cee-wals/Voron-2/custom/mods/Corner_Cable_Cover_with_Drop_Holes /README.md

# Top Corner Cable Cover with Drop Down Holes (LED Wires)
Covers cables that are running around the top corners of 2.4R2 extrusions behind the Z idlers with drop down holes around the vertical extrusions and inline holes with cutouts to keep the wire management as clean as possible.

Holes are big enough to allow 2 pin microfit connectors pass through. Works perfectly with LDO LED PCB breakout board.

**CAUTION**
Check your max Z travel as there will be some loss.

### Printing
  * Print 1 cover per LED strip
  * Default voron settings
  * No supports needed

### BOM

Size | Qty
--- | ---
M3x8 | 2
M3 T-Nut | 2

* QTY per cover

Top Corner Cable Cover

Top Corner Cable Cover

Top Corner Cable Cover
