cee-wals/Voron-2/custom/tools/12mm_Linear_Rail_Alignment_Tool_for_2020___3030_T_Slot/README.txt

12mm Linear Rail Alignment Tool for 2020 + 3030 T Slot by Omster_Designs on Thingiverse: https://www.thingiverse.com/thing:3383221
