cee-wals/Voron-2/custom/mods/MRW_Kinematic_Sexbolt_Mount/ORIGIN.md

__Origin:__ [MRW Adapted SexBolt Z endstop](https://github.com/azoner/VoronUsers/tree/master/printer_mods/azoner/MRW_Kinematic_Sexbolt_Mount)
