cee-wals/Voron-2/custom/mods/voron-v2-bed-level-camera-model_files/532931-voron-v2-bed-level-camera-3a5c9853-37b9-4ec1-85e7-4c6113cc6f03.pdf

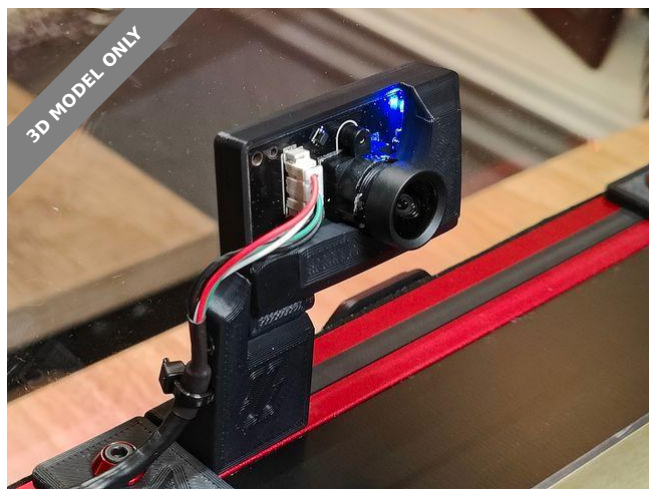
[picture p16: figure]
3D MODEL ONLY

Summary

In case you don't want the bird's eye view

3D Printers (https://printables.com/model?categoryId=1) > 3D Printers - Upgrades (https://printables.com/model?categoryId=2)

Tags: camera | mod | voron | webcam

This is a case and extrusion mount for inexpensive 1080p webcams. It's just low enough to clear the V2 gantry. Tested with Xol2 non-UHF hotend without kinematic mounts. If you use this successfully with other hotend combinations, please let me know and I'll update the description. If you use a kinematic mount, let me know what the difference is and I can make an additional extrusion mount for that height.

BOM

1x M3 20mm BHCS
3x M2 10mm self-tapping screws 1x 3x5x4 “Voron standard” heatset
1x Extrusion nut (roll-in, T-nut, etc.)
1x Small zip tie
1x Generic 1080p webcam (eMeet C960 (https://www.amazon.com/dp/B07M6Y7355?amp=&amp=) is what I used but I suspect most webcams are similar without the case)

neon.blue (https://printables.com/@neonblue)

Voron V2 Bed Level

Camera

VIEW IN BROWSER (https://printables.com/model/532931-voron-v2-bed-level-camera)

updated 26. 7. 2023 | published 26. 7. 2023

•
•
•
•
•
•

Instructions

Print 1 of each part
Insert heat set into Extrusion Mount
Open the webcam case (see below)
Once just the PCB is isolated, inspect the lens. Most of these cameras have a threaded (screw on) lens with a dab of glue. If so, twist the lens to break the glue seal. Rotate the lens so that it's about a quarter turn out(to the left) from it's original position. This step is necessary as most webcams are set with the focus distance too far away. Insert the PCB into the Back Plate.
Put the Front Cover over top of the Back Plate, holding both in place with one hand.
Thread the M2 screws in from the back.
Thread the M3 screw through the bottom of the Back Plate, and fasten to the Extrusion Mount.
Install extrusion not into 2020 frame and screw Extrusion Mount in place
Adjusting the pivot direction as needed
Place an item in the middle of the build plate to check how focus is. If everything is out of focus, twist the lens in (to the right). If the background is in focus but the printed object is not, twist the lens out (to the left).
Add a zip tie to secure the USB cable
Route the cable into the basement using your preferred method (belt covers with cable routing slots help here)

IMPORANT LAST STEP: Slowly lower the gantry down, then

move the Y axis back and forth to make sure everything
clears before running a print. I tested the model with a Xol2 toolhead with a Rapido HF (not the longer UHF), but your toolhead and hotend combination may vary slightly, so be sure to check!

Opening the eMeet C960 Case

Where the main case pivots from the mount, there are two rubber dots. Use an awl, ice pick, or thin need nose pliers to pry these out. Remove the pivot screws.
To remove the case, there's a small flat dimple that a flathead screwdriver will fit on the bottom. Use the screwdriver to pry it apart. This will break the case irreparably.
Once the case is halved, use plyers to pull the case apart to loosen the PCB. The case material is flexible and will bend enough to allow the PCB to easily come out. Be careful not to damage the PCB in the process.

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
### Model files

License

This work is licensed under a GNU

General Public License v3.0 (https://www.gnu.org/licenses/gpl-3.0.html)

✖ | Sharing without ATTRIBUTION
✔ | Remix Culture allowed
✔ | Commercial Use
✔ | Meets Open Definition
ℹ | Share under the same license extrusion⁻mount⁻no⁻kinematics.stl

front⁻cover.stl

back-plate.stl
