cee-wals/Voron-2/custom/tools/12mm_Linear_Rail_Alignment_Tool_for_2020___3030_T_Slot/images/Linear_Rail_3030_Alignment_Tool.png

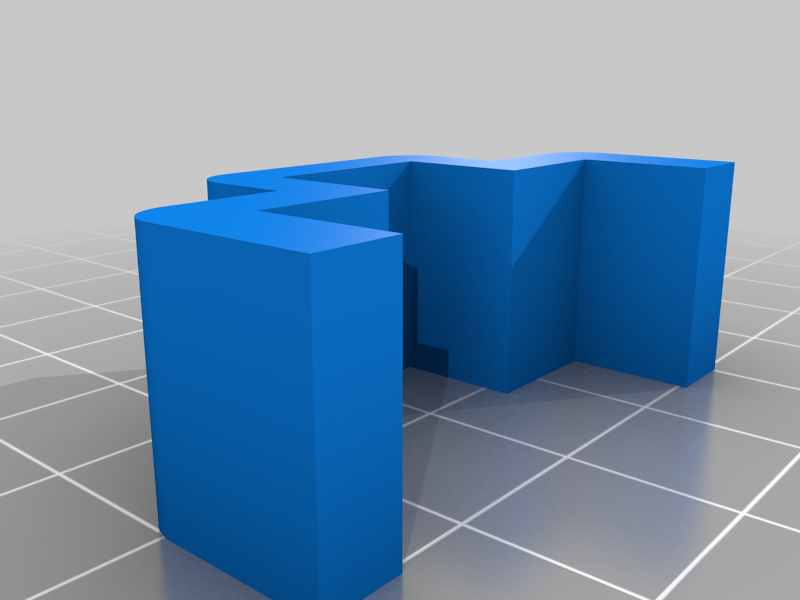
custom/tools/12mm_Linear_Rail_Alignment_Tool_for_2020___3030_T_Slot/images/Linear_Rail_3030_Alignment_Tool.png
