cee-wals/Voron-2/custom/voronica/BTT-Manta-M8P-v1.0.jpg

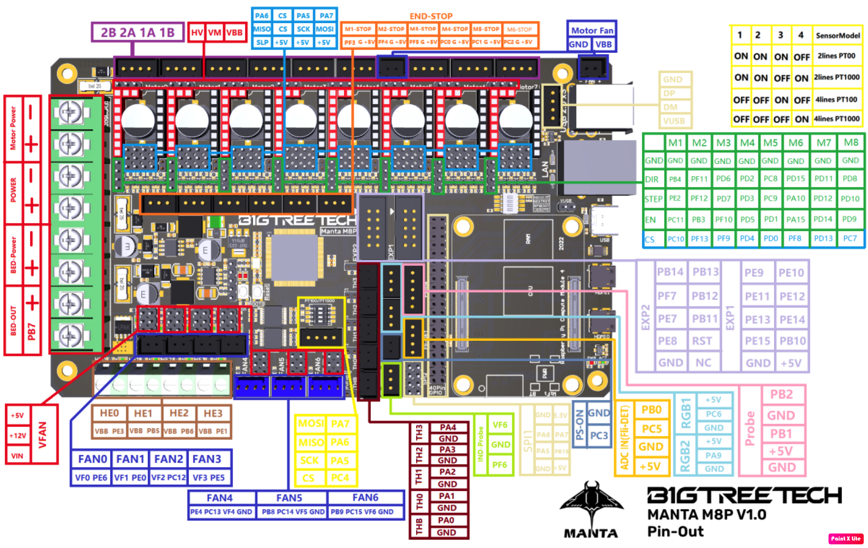
custom/voronica/BTT-Manta-M8P-v1.0.jpg
