cee-wals/Voron-2/BOM/voron2.4_350mm_bom.xlsx

Sheet: West3D Voron 2.4 BOM
WEST3D V2.4 Configurator - BOM In a Box
Description | Quantity | Configurable | BOM mod | Config 1 | Config 2 | Config 3 | My Choice | Notes | Actual Qty. | Unit Cost | Cost (parts only) | Shipping | Taxes | Total Cost | Actual Cost | Cost Adjustments | Status | Funding / Accounting Info | Accounting Tasking / Status
Printed Parts | 0 | YES |  | Printed Parts (https://west3d.com/products/printed-parts-for-voron-2-4?_pos=2&_sid=e14926f18&_ss=r) |  |  | DIY | TODO: Add filament and costs. 2 x ASA spools Jet black and lipstick red: from PrintedSolid.com | 0 | $0.00 | $0.00 |  |  | $0.00 |  |  | In-Progress |  |  | Statuses
West3D BDF Stainless Steel Fasteners - Default (https://west3d.com/products/west3d-stainless-steel-fastener-kit-for-voron-2-4-bdf) | 1 | YES |  | West3D BDF Stainless Steel Fasteners - Stainless Steel Hammer Head Upgrade (https://west3d.com/products/west3d-stainless-steel-fastener-kit-for-voron-2-4-bdf?variant=41091345612968) | West3DBDF All Black |  | West3D BDF Stainless Steel Fasteners - Stainless Steel Hammer Head Upgrade |  | 1 | $84.99 | $84.99 | $0.00 | $0.00 | $84.99 | $84.99 |  | Received | Voron Txn 3 (TWW-KF-VORON-3) TWW Kids fund (proj. voron): $530.90 on 11/11/2022 total shipping: $10.00 | TWW-KF-VORON-3 Direct from TWW account | Ordered
West3D Motion Kit Silver (https://west3d.com/products/west3d-bdm-voron-2-4-motion-set-black-or-silver?_pos=1&_sid=ffc38f735&_ss=r) | 1 | YES |  | West3D Motion Black (https://west3d.com/products/west3d-bdm-voron-2-4-motion-set-black-or-silver?variant=42314907910356) | POWGE Motion Silver (https://west3d.com/products/powge-gates-voron-2-4-motion-set-black-or-silver) | POWGE Motion Black (https://west3d.com/products/powge-gates-voron-2-4-motion-set-black-or-silver?_pos=6&_sid=c54dc9652&_ss=r) | POWGE Motion Black (https://west3d.com/products/berserker-v2-4-motion-kit?_pos=1&_sid=20ef47c64&_ss=r) | Voron 2.4 Motion Kit (black) | 1 | $144.99 | $144.99 | $0.00 | $0.00 | $144.99 | $144.99 |  | Received | Voron Txn 4 (TWW-KF-VORON-4) TWW Kids fund (proj. voron): $543.42 on 12/02/2022 | TWW-KF-VORON-4 Direct from TWW account | Out-of-stock
West3D Custom MGN9 Rails (https://west3d.com/products/west3d-printing-mgn9h-1r-300-350-400-linear-rails-with-carriages-cna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) | 6 | YES |  | LDO MGN9 Rails (https://west3d.com/products/ldo-motors-mgn9h-1r-300-350-4000-linear-rails-with-carriages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) | West3D MGN9 Black (https://west3d.com/products/west3d-printing-mgn9h-1r-300-350-400-linear-rails-with-carriages-cna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) | RobotDigg GS_MGN9-1H-B400 (black anodized) (https://www.robotdigg.com/product/1314/Black-anodized-linear-rail-7,-9,-12-and-15) | RobotDigg GS_MGN9-1H-B400 (black anodized) | Purchased from robotdig.com | 6 | $15.00 | $90.00 | $35.85 | $0.00 | $125.85 | $125.85 |  | Received | Voron Txn 2 (TWW-KF-VORON-2) TWW Kids fund (proj. voron): $146.82 on 10/24/2022 total shipping: $41.82 | TWW-KF-VORON-2 Pay Apple CC from TWW account | Received
West3D Custom MGN12 Rails (https://west3d.com/products/west3d-printing-mgn12h-1r-300-350-400-linear-rails-with-carriages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) | 1 | YES |  | LDO MGN12 Rails (https://west3d.com/products/ldo-motors-mgn12h-1r-300-350-400-linear-rails-with-carriages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) | West3D MGN12 Black (https://west3d.com/products/west3d-printing-mgn12h-1r-300-350-400-linear-rails-with-carriages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) | RobotDigg GS_MGN12-1H-B400 (black anodized) (https://www.robotdigg.com/product/1314/Black-anodized-linear-rail-7,-9,-12-and-15) | RobotDigg GS_MGN12-1H-B400 (black anodized) | Purchased from robotdig.com | 1 | $15.00 | $15.00 | $5.97 | $0.00 | $20.97 | $20.97 |  | Received | TWW-KF-VORON-2 | TWW-KF-VORON-2 Pay Apple CC from TWW account | Shipped
Updated Rubber Feet for V2.4 (https://west3d.com/products/updated-rubber-feet-for-trident-v2-4-set-of-4?_pos=3&_sid=1c2a5098d&_ss=r) | 4 | NO |  |  |  |  | Updated Rubber Feet for V2.4 | 1x Package contains 4 feet | 1 | $8.99 | $8.99 | $0.00 | $0.00 | $8.99 | $8.99 |  | Received | TWW-KF-VORON-4 | TWW-KF-VORON-4 | In-Progress
Z PCB (https://west3d.com/products/microswitch-z-endstop-pcb-assembled?_pos=1&_sid=06ad9004a&_ss=r) | 1 | YES |  | Sexbolt (https://west3d.com/products/sexbolt-z-endstop-fully-assembled?_pos=1&_sid=f739f1228&_ss=r) | Omron Mouse Button - Micro Switch (D2F-01L) (https://west3d.com/products/omron-mouse-button-micro-switch-d2f-01l?_pos=1&_sid=3f491dd97&_ss=r) |  | Z PCB | Accidentally bought the Z PCB. I originally planned on buying the Omron Mouse Button | 1 | $4.00 | $4.00 | $0.00 | $0.00 | $4.00 | $4.00 |  | Received | TWW-KF-VORON-4 | TWW-KF-VORON-4 | Partial Order
XY Microswitch PCB (https://west3d.com/products/voron-x-y-microswitch-endstop-pcb-assembled?_pos=2&_sid=15e9576ef&_ss=r) | 1 | YES |  | Microswitches (https://west3d.com/products/omron-mouse-button-micro-switch-d2f-01l?_pos=1&_sid=3f491dd97&_ss=r) | Hall Effect PCB (https://west3d.com/products/voron-hall-effect-x-y-endstop-pcb-assembled?_pos=1&_sid=ca49ce687&_ss=r) |  | XY Microswitch PCB |  | 1 | $6.49 | $6.49 | $0.00 | $0.00 | $6.49 | $6.49 |  | Received | TWW-KF-VORON-4 | TWW-KF-VORON-4
Omron TL-Q5MC2-Z NPN Inductve Probe (https://west3d.com/products/omron-tl-q5m-inductive-probe?_pos=2&_sid=832b33dd2&_ss=r) | 1 | NO |  | Klicky Probe (Complete) (https://west3d.com/products/klicky-probe-kit-complete) |  |  | Klicky Probe (Complete) | Attempting to use the Voron Tap | 0 | $27.99 | $0.00 |  |  | $0.00
Bat85 Diode (https://west3d.com/products/bat85-diode?_pos=2&_sid=7df00f9b9&_ss=r) | 1 | NO |  |  |  |  | Bat85 Diode | Included in wiring kit | 0 | $0.99 | $0.00 |  |  | $0.00
Panasonic AWA211VL 15A SSR (https://west3d.com/products/panasonic-aqa211vl-15a-solid-state-relay-ssr?_pos=1&_sid=8c7f9840c&_ss=r) | 1 | YES |  | Omron G3NA-210B-DC5 10A SSR (https://west3d.com/products/omron-g3na-210b-utu-dc5-24v-solid-state-relay-ssr?_pos=2&_sid=8c7f9840c&_ss=r) |  |  | Omron G3NA-210B-DC5 10A SSR |  | 1 | $28.99 | $28.99 | $0.00 | $0.00 | $28.99 | $28.99 |  | Received | TWW-KF-VORON-11 | TWW-KF-VORON-11
Voron 2.4 Motor Kit by OMC / Stepperonline (https://west3d.com/products/voron-2-4-motor-kit-by-omc-steppersonline?_pos=1&_sid=dd1f4dbfe&_ss=r) | 1 | YES |  | LDO V 2.4 Motor Kit (https://west3d.com/products/voron-2-4-motor-kit-by-ldo-motors) |  |  | LDO V 2.4 Motor Kit |  | 1 | $109.99 | $109.99 | $0.00 | $0.00 | $109.99 | $109.99 |  | Received | TWW-KF-VORON-3 | TWW-KF-VORON-3
Mean Well LRS-200-24 200W 24V 8.8A Power Supply (PSU) (https://west3d.com/products/mean-well-lrs-200-24-200w-24v-8-8a-power-supply-psu?_pos=4&_sid=965d25871&_ss=r) | 1 | NO |  | Mean Well LRS-200-48 (https://west3d.com/products/mean-well-lrs-200-48-200w-48v-4-4a-power-supply-psu?_pos=5&_sid=caa366dc6&_ss=r) | Mean Well UHP-200-24 (https://west3d.com/products/mean-well-uhp-200-24-200w-24v-8-4a-power-supply-psu?_pos=6&_sid=caa366dc6&_ss=r) | Mean Well UHP-200-48 (https://west3d.com/products/mean-well-uhp-200-48-200w-48v-4-2a-power-supply-psu-1?_pos=7&_sid=caa366dc6&_ss=r) | Mean Well LRS-200-24 200W 24V 8.8A Power Supply (PSU) |  | 1 | $30.99 | $30.99 | $0.00 | $0.00 | $30.99 | $30.99 |  | Received | TWW-KF-VORON-11 | TWW-KF-VORON-11
Mean Well RS-25-5 25W Power Supply (PSU) (https://west3d.com/products/mean-well-rs-25-5-25w-5v-5a-power-supply-psu?_pos=1&_sid=965d25871&_ss=r) | 1 | NO |  |  |  |  | Mean Well RS-25-5 25W Power Supply (PSU) |  | 1 | $18.99 | $18.99 | $0.00 | $0.00 | $18.99 | $18.99 |  | Received | TWW-KF-VORON-11 | TWW-KF-VORON-11
ZF - Rocker Switch DPST 16A On-Off - WRG32F2BBRLN (https://west3d.com/products/zf-rocker-switch-dpst-16a-on-off-wrg32f2bbrln?_pos=1&_sid=5dfc265cb&_ss=r) | 1 | YES |  | AC Power Unfiltered Inlet w/ 15A switch 250VAC Inlet IEC-GS-1-100 - Adam Tech (https://west3d.com/products/ac-power-unfilted-inlet-w-15a-switch-250vac-inlet-iec-gs-1-100-adam-tech) |  |  | ZF - Rocker Switch DPST 16A On-Off - WRG32F2BBRLN | Didn't order for some reason | 1 | $2.99 | $2.99 | $0.00 | $0.00 | $2.99 | $0.00 |  |  | TWW-KF-VORON-11 | TWW-KF-VORON-11
TycoElectronics - 10EHG1-2 Filtered Power Inlet (https://west3d.com/products/tycoelectronics-10ehg1-2-filtered-power-inlet?_pos=1&_sid=752da22d9&_ss=r) | 1 |  |  |  |  |  | TycoElectronics - 10EHG1-2 Filtered Power Inlet |  | 1 | $20.99 | $20.99 | $0.00 | $0.00 | $20.99 | $20.99 |  | Received | TWW-KF-VORON-11 | TWW-KF-VORON-11
Fuse 8A 250V Holder Cartridge 5 X 20mm Glass (https://west3d.com/products/fuse-8a-250v-holder-cartridge-5-x-20mm-glass?_pos=1&_sid=0d913b2f2&_ss=r) | 3 | NO |  |  |  |  | Fuse 8A 250V Holder Cartridge 5 X 20mm Glass |  | 3 | $0.99 | $2.97 | $0.00 | $0.00 | $2.97 | $2.97 |  | Received | TWW-KF-VORON-11 | TWW-KF-VORON-11
GDSTIME DC 24V 40x40x10 Axial Fan GDA4010 (https://west3d.com/products/gdstime-dc-24v-40x40x10-axial-fan-gda4010-9-blades-dual-ball-bearing-7500rpm-9w-04a-xh2-54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) | 1 | YES |  | Sunon 4010 Premium MagLev Axial (https://west3d.com/products/sunon-4010-premium-axial-fan-maglev-suspension-bearing-24v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) |  |  | GDSTIME DC 24V 40x40x10 Axial Fan GDA4010 | Adding 1 more for SB toolhead. TODO: Is this what that’s for | 2 | $6.99 | $13.98 | $0.00 | $0.00 | $13.98 | $13.98 |  | Received | TWW-KF-VORON-11 | TWW-KF-VORON-11
GDSTIME DC 24V 40x40x20 Centrifugal Blower Fan GDB4020 (https://west3d.com/products/gdstime-dc-24v-40x40x20-centrifugal-blower-fan-gdb3020-dual-ball-bearing-6500rpm-1-5w-07a-xh2-54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) | 1 | NO |  |  |  |  | GDSTIME DC 24V 40x40x20 Centrifugal Blower Fan GDB4020 |  | 1 | $6.99 | $6.99 | $0.00 | $0.00 | $6.99 | $6.99 |  | Received | TWW-KF-VORON-11 | TWW-KF-VORON-11
GDSTIME DC 24V 60x60x20 Axial Fan GDA6020 Dual Ball Bearing 5000RPM 1.7W 0.1A XH2.54 (https://west3d.com/products/gdstime-dc-24v-60x60x20-axial-fan-gda6020-dual-ball-bearing-5000rpm-1-7w-0-1a-xh2-54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) | 3 | NO |  |  |  |  | GDSTIME DC 24V 60x60x20 Axial Fan GDA6020 Dual Ball Bearing 5000RPM 1.7W 0.1A XH2.54 |  | 3 | $6.99 | $20.97 | $0.00 | $0.00 | $20.97 | $20.97 |  | Received | TWW-KF-VORON-11 | TWW-KF-VORON-11
125C Cutoff 15A Thermal Fuse (https://west3d.com/products/125c-cutoff-15a-thermal-fuse?_pos=6&_sid=0d913b2f2&_ss=r) | 1 | NO |  |  |  |  | 125C Cutoff 15A Thermal Fuse | 1 is required. Adding 1 more for in-case it fails | 2 | $1.29 | $2.58 | $0.00 | $0.00 | $2.58 | $2.58 | -$1.29 | Received | TWW-KF-VORON-11 | TWW-KF-VORON-11
~~BTT Octopus Controller Board / 3D Printer Control System~~ | ~~1~~ | ~~YES~~ |  | ~~Octopus PRO 446~~ (https://west3d.com/products/btt-48v-octopus-pro-controller-board-3d-printer-control-system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) | ~~Octopus PRO 429~~ (https://west3d.com/products/btt-48v-octopus-pro-controller-board-3d-printer-control-system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) | ~~Makerbase Monster8~~ (https://west3d.com/products/makerbase-mks-monster8-32bit-control-board-3d-printer?_pos=1&_sid=b657f83e5&_ss=r) | ~~Octopus PRO 429~~ | Not using the BTT Octopus PRO boards b/c the Rpi supply issue. Using the BTT Manta w/ BTT CB1 instead | ~~0~~ | ~~$74.99~~ | ~~$0.00~~ |  |  | ~~$0.00~~
BTT Manta M8P Klipper Controller Board / 3D Printer Control System using CB1/CM4 (https://west3d.com/products/btt-manta-m8p-klipper-controller-board-3d-printer-control-system-using-cb1-cm4) | 1 | YES | YES |  |  |  | BTT Manta M8P Klipper Controller Board / 3D Printer Control System using CB1/CM4 | Replaces BTT Octopus PRO control board and Raspberry Pi | 1 | $54.99 | $54.99 | $0.00 | $0.00 | $54.99 | $54.99 |  | Received | TWW-KF-VORON-3 | TWW-KF-VORON-3
BTT CB1 Computing Core Board Adapter for Manta CBs (https://west3d.com/products/btt-cb1-adapter-for-manta-controller-boards) | 2 | NO | YES (only 1 req) |  |  |  | BTT CB1 Computing Core Board Adapter for Manta CBs | 1 is only required. Adding 1 for private stock | 2 | $29.99 | $59.98 | $0.00 | $0.00 | $59.98 | $59.98 | -$29.99 | Received | TWW-KF-VORON-3 | TWW-KF-VORON-3
BTT Pi4B Adapter for CM4 or CB1 (https://west3d.com/products/btt-pi4b-adapter) | 1 | N/A | NO (not for Voron) |  |  |  | BTT Pi4B Adapter for CM4 or CB1 | Note a part of the Voron 2.4 build. For private stock | 1 | $22.99 | $22.99 | $0.00 | $0.00 | $22.99 | $22.99 | -$22.99 | Received | TWW-KF-VORON-3 | TWW-KF-VORON-3
TMC2209 Stepper Motor Driver / Drivers (BTT) | 7 | YES |  | TMC2226 (https://west3d.com/products/tmc2226-stepper-motor-driver-drivers-btt) | 5160HV |  | TMC2226 |  | 7 | $6.49 | $45.43 | $0.00 | $0.00 | $45.43 | $45.43 |  | Received | TWW-KF-VORON-11 | TWW-KF-VORON-11
Mini 12864 Display Type B RGB - Choose your color (extra) (https://west3d.com/products/mini-12864-display-type-b-bttwhite-on-rgb?_pos=3&_sid=7225d3998&_ss=r) | 1 | YES |  | Touch Screen 5" PiTFT50 (extra) (https://west3d.com/products/touch-screen-display-5-inch-ptft50-btt?_pos=1&_sid=3ed1cf151&_ss=r) | Touch Screen 7" PiTFT70 (extra) (https://west3d.com/products/touch-screen-display-5-inch-ptft50-btt?_pos=1&_sid=3ed1cf151&_ss=r) | BTT HDMI7 V1.0 Display from DFH (https://dfh.fm/products/btt-hdmi7-v1-0-display) | BTT HDMI7 V1.0 Display from DFH | Feature enhancement. 5" display PiTFT50 is listed in BOM, but V2.4 STLs are for the 7" display. | 1 | $70.00 | $70.00 | $3.27 | $0.00 | $73.28 | $73.28 | -$73.28 | Ordered | Voron Txn 13 (TWW-KF-VORON-13) TWW Kids fund (proj. voron): $130.10 on 12/26/2022 | TWW-KF-VORON-13 Direct from TWW account
Mini 12864 Display Type B RGB - Choose your color (https://west3d.com/products/mini-12864-display-type-b-bttwhite-on-rgb) | 2 | N/A | NO |  |  |  | Mini 12864 Display Type B RGB - Choose your color | 1 x Voron + 1 x Polyformer | 2 | $12.99 | $25.98 | $0.00 | $0.00 | $25.98 | $25.98 | -$12.99 | Received | TWW-KF-VORON-3 | TWW-KF-VORON-3
Voron v2.4 USA Frame Kit (black); 350mm (https://west3d.com/products/voron-v2-4-usa-frame-kit?variant=41115940520104) | 1 | NO |  |  |  |  | Voron v2.4 USA Frame Kit (black); 350mm |  | 1 | $150.00 | $150.00 | $10.00 | $0.00 | $160.00 | $160.00 |  | Received | TWW-KF-VORON-3 | TWW-KF-VORON-3
Bowden / PTFE Tube 4mm OD 3mm ID (https://west3d.com/products/bowden-ptfe-tube-4mm-od-3mm-id?variant=41895975387348) | 3 | NO |  |  |  |  | Bowden / PTFE Tube 4mm OD 3mm ID | Not needed for direct drive Voron. | 0 | $3.50 | $0.00 |  |  | $0.00
6mm x 3mm Round Neomydium Magnets (https://west3d.com/products/6mm-x-3mm-round-neomydium-magnets) | 8 | NO |  |  |  |  | 6mm x 3mm Round Neomydium Magnets | Only need 8 but doubling the quantity for other projects | 16 | $0.49 | $7.84 |  |  | $7.84 | $7.84 | -$3.92 | Received | TWW-KF-VORON-11 | TWW-KF-VORON-11
Bowden Coupler for 4mm OD PTFE Tube (https://west3d.com/products/bowden-coupler-for-4mm-od-ptfe-tube) | 1 | NO |  |  |  |  | Bowden Coupler for 4mm OD PTFE Tube |  | 1 | $0.99 | $0.99 |  |  | $0.99
5mm x 10m Single Sided Self Adhesive Tape / 1mm thick (https://west3d.com/products/5mm-x-10m-single-sided-self-adhesive-tape-1mm-thick) | 1 | NO |  |  |  |  | 5mm x 10m Single Sided Self Adhesive Tape / 1mm thick |  | 1 | $4.99 | $4.99 |  |  | $4.99
BMG Components Kit by TriangleLab Hardened Steel | 1 | YES |  | BMG Components Kit Nano Coated RNC (https://west3d.com/products/bmg-components-kit-by-trianglelab?variant=42230858744020) |  |  | BMG Components Kit Nano Coated RNC |  | 1 | $32.99 | $32.99 | $0.00 | $0.00 | $32.99 | $32.99 |  | Received | TWW-KF-VORON-11 | TWW-KF-VORON-11
Wiring Harness for Voron 2.4 / Trident (https://west3d.com/products/wiring-harness-for-voron-2-4-trident) | 1 | YES |  | Linneo DIY FEP Wiring Harness (https://west3d.com/products/linneo-diy-fep-wiring-harness-kit-for-voron-2-4-trident) | GleipnerHarness |  | Wiring Harness for Voron 2.4 / Trident | Linneo $99.99 West3D - Out of stock Need to make new cables for alt CB. Has stop PCBs | 1 | $79.99 | $79.99 | $0.00 | $0.00 | $79.99 | $79.99 |  | Received | TWW-KF-VORON-11 | TWW-KF-VORON-11
Generic Cable Chain Sets for V2.4 (350mm) (https://west3d.com/products/v2-4-cable-chain-set?variant=42258915098836) | 1 | YES |  | IGUS Cable Chain Set (350mm) (https://west3d.com/products/igus-cable-chain-kits?variant=42052418601172) |  |  | IGUS Cable Chain Set (350mm) | IGUS Cable Chain Set (350mm) $79.99 West3D - Out of stock. Default option $24.99 | 1 | $79.99 | $79.99 | $0.00 | $0.00 | $79.99 | $79.99 |  | Received | TWW-KF-VORON-11 | TWW-KF-VORON-11
Mandala Roseworks ABS Panels Black (350 mm) (https://west3d.com/products/voron-2-4-abs-panels?variant=41207116497064) | 1 | YES |  | Mandala Roseworks ABS Panels White | Printed Solide - Aluminum Composite backing Panels (https://www.printedsolid.com/products/voron-v2-panel-set-made-from-aluminum-composite-material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) |  | Printed Solide - Aluminum Composite backing Panels | Getting the ones from Printed Solid | 1 | $65.00 | $65.00 | $0.00 | $0.00 | $65.00 | $65.00 |  | Received | TWW-KF-VORON-5 | TWW-KF-VORON-5
Mandala Roseworks Acrylic Panels Smoked (350mm) (https://west3d.com/products/voron-2-4-acrylic-panels?variant=41213966287016) | 1 | YES |  | Mandala Roseworks Acrylic Panels Clear |  |  | Mandala Roseworks Acrylic Panels Clear | 350mm option | 1 | $48.99 | $48.99 | $19.57 | $0.00 | $68.56 | $68.56 |  | Received | TWW-KF-VORON-12 | TWW-KF-VORON-12
Voron 2.4 Build MIC6 Aluminum Build Plate (350mm) (https://west3d.com/products/voron-2-4-build-mic6-aluminum-build-plate?variant=41126171279528) | 1 | YES |  | Mandala Roseworks Ultraflat Magbed (350mm) (https://west3d.com/products/voron-mag-bed-mic6-aluminum-build-plate?variant=42537846702292) |  |  | Mandala Roseworks Ultraflat Magbed (350mm) | 350mm Aluminum build plate is $104.99 | 1 | $253.99 | $253.99 | $25.00 | $0.00 | $278.99 | $278.99 |  | Received | TWW-KF-VORON-4 | TWW-KF-VORON-4
Keenovo Silicone Heater / Heating Pad | 1 | YES |  | Fermio Style (350mm) (https://west3d.com/products/keenovo-fermio-style-silicone-heater-heating-pad?variant=41219774185640) | Fermoi Style (350mm) from Keenovo Store (https://keenovo.store/products/keenovo-silicone-heater-for-voron-3d-printer-with-fermio-style-build-plate-heatbed-heating-mat) |  | Fermoi Style (350mm) from Keenovo Store | Purchase from the Keenovo Store directly b/c of limited supplies | 1 | $102.12 | $102.12 | $32.00 | $0.00 | $134.12 | $134.12 |  | Received | Voron Txn 14 (TWW-KF-VORON-14) TWW Kids fund (proj. voron): $134.12 on 12/26/2022 | TWW-KF-VORON-14 Direct from TWW account
Magnetic Flex Plate Double-Sided (Texture - Smooth) with 3M Magnetic Backing (Energetic & West3D Collab) (https://west3d.com/products/double-sided-texture-smooth-flex-plate-with-3m-magnetic-backing-energetic-west3d-collab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) | 1 | YES |  |  |  |  | Magnetic Flex Plate Double-Sided (Texture - Smooth) with 3M Magnetic Backing (Energetic & West3D Collab) | Double-sided smoot/texture with Logo for 350mm | 1 | $59.99 | $59.99 | $19.57 | $0.00 | $79.56 | $79.56 |  | Ordered | Voron Txn 12 (TWW-KF-VORON-12) TWW Kids fund (proj. voron): $148.13 on 12/25/2022 | TWW-KF-VORON-12 Direct from TWW account
Phaetus Dragonfly Hotend (BMS) | 1 | YES |  | TriangleLab / Phaetus Rapdio HF (add $10 for UHF) | The Mosquito Hotend | Phaetus Rapido UHF /TL PT1000 (black) (https://west3d.com/products/rapido-hot-end-high-flow-tl-phaetus?variant=43306704470228) | Phaetus Rapido UHF /TL PT1000 (black) |  | 1 | $119.99 | $119.99 | $0.00 | $0.00 | $119.99 | $119.99 |  | Received | TWW-KF-VORON-11 | TWW-KF-VORON-11
50W 24V Heater Cartridge with 100CM cable | 1 | YES |  | 50W Heater Cartidge - 24V Slice Engineering |  |  | N/A | Is this need if using the Rapido Hotend | 1 | $0.00 | $0.00 |  |  | $0.00
PT1000 Thermistor Cartridge (450C) | 1 | YES |  | Pt1000 Resistance Temperature Detector (RTD) Thermistor | Thermistor High Temperature - 300C |  | N/A | Is this needed if using the Rapido Hotend | 1 | $0.00 | $0.00 |  |  | $0.00
Mobil Mobilux EP2 10ml filled syringe with blunt tips (https://west3d.com/products/mobil-mobilux-ep2-10ml-filled-syringe-with-blunt-tip) | 1 | NO |  |  |  |  | Mobil Mobilux EP2 10ml filled syringe with blunt tips |  | 1 | $8.99 | $8.99 | $0.00 | $0.00 | $8.99 | $8.99 |  | Received | TWW-KF-VORON-4 | TWW-KF-VORON-4
Large Printed Parts Decal (https://west3d.com/products/vinyl-sticker-decals?variant=42168373117140) | 1 | NO |  |  |  |  | Large Printed Parts Decal | Optional | 1 | $15.99 | $15.99 |  |  | $15.99
Voron Design Decal (https://west3d.com/products/vinyl-sticker-decals?_pos=1&_sid=e602fe7fa&_ss=r) | 1 | NO |  |  |  |  | Voron Design Decal | Optional | 1 | $5.99 | $5.99 |  |  | $5.99
Din Rails (Pair); 470mm (350 builds; Model 2.4 (https://west3d.com/products/din-rails-35mm-x-7-5mm-steel-pair?variant=42117740658900) | 1 | NO |  |  |  |  | Din Rails (Pair); 470mm (350 builds; Model 2.4 |  | 1 | $11.99 | $11.99 | $0.00 | $0.00 | $11.99 | $11.99 |  | Received | TWW-KF-VORON-4 | TWW-KF-VORON-4
Din Rail Clamp / Bracket for Solid State Relay (SSR) (https://west3d.com/products/din-rail-clamp-bracket-with-2-mounting-screws-for-solid-state-relay-ssr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) | 1 | NO |  |  |  |  | Din Rail Clamp / Bracket for Solid State Relay (SSR) |  | 1 | $3.99 | $3.99 | $0.00 | $0.00 | $3.99 | $3.99 |  | Received | TWW-KF-VORON-4 | TWW-KF-VORON-4
Wire Connectors (Wago 221-415) (https://west3d.com/products/wago-lever-nuts-fast-wire-cable-connectors-12-24awg-221-412-221-413-221-415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) | 3 | NO |  |  |  |  | Wire Connectors (Wago 221-415) |  | 3 | $2.79 | $8.37 |  |  | $8.37
3-3 DIN Mounting Fast Wire Cable Connectors / Wago Connector (https://west3d.com/products/3-3-din-mounting-fast-wire-cable-connectors-wago-connector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) | 2 | NO |  |  |  |  | 3-3 DIN Mounting Fast Wire Cable Connectors / Wago Connector | 2 is on the BOM, but purchasing 3 for an extra | 3 | $3.49 | $10.47 | $0.00 | $0.00 | $10.47 | $10.47 | -$3.49 | Received | TWW-KF-VORON-11 | TWW-KF-VORON-11
ADXL345 Accelerometer (https://west3d.com/products/adxl345-accelerometer?_pos=1&_sid=92bc887c8&_ss=r) | 1 | YES | YES | LDO Input Shaper kit; ADXL345 and more (https://www.fabreeko.com/products/copy-of-adxl345-accelerometer) |  |  | LDO Input Shaper kit; ADXL345 and more | On sale from Fabreeko. | 1 | $9.99 | $9.99 | $4.99 | $0.00 | $14.98 | $14.98 |  | Received | Voron Txn 16 (TWW-KF-VORON-16) TWW Kids fund (proj. voron): $14.98 on 12/27/2022 | TWW-KF-VORON-16 Direct from TWW account
C13 Power Cord (https://west3d.com/products/6ft-18-awg-power-cord-c13-ul-listed?_pos=1&_sid=9a86b2051&_ss=r) | 0 | NO |  |  |  |  | C13 Power Cord | Optional. I already have one | 0 |  | $0.00 |  |  | $0.00
ZipTies, VHB Tape + Other Misc. | 0 | NO |  |  |  |  |  | Not an acutal part. Adding al acarte | 0 |  | $0.00 |  |  | $0.00
3M VHB Tape 5952 5mm width (https://west3d.com/products/3m-vhb-tape-5952?variant=42692316594388) | 1 |  | YES |  |  |  | 3M VHB Tape 5952 5mm width | Addon. What size and purpose | 1 | $5.99 | $5.99 | $1.38 | $0.00 | $7.37 | $7.37 |  | Ordered | TWW-KF-VORON-19 | TWW-KF-VORON-19
3M VHB Tape 5952 6.35mm width (https://west3d.com/products/3m-vhb-tape-5952?variant=42692316627156) | 1 |  | YES |  |  |  | 3M VHB Tape 5952 6.35mm width | Addon. What size and purpose | 1 | $6.99 | $6.99 | $1.38 | $0.00 | $8.37 | $8.37 |  | Ordered | TWW-KF-VORON-19 | TWW-KF-VORON-19
Voron Serial Sticker (https://west3d.com/products/voron-serial-sticker) | 1 |  | YES |  |  |  |  |  | 1 | $6.50 | $6.50 |  |  | $6.50
Titanium Backers for Voron 2.4/Trident with screws 3-Pack (350mm) (https://west3d.com/products/titanium-backers-for-voron-2-4-trident-3-pack?variant=42064409624788) | 1 | NO | YES |  |  |  | Titanium Backers for Voron 2.4/Trident with screws 3-Pack (350mm) | Not required but highly recommended | 1 | $74.99 | $74.99 | $0.00 | $0.00 | $74.99 | $74.99 |  | Received | TWW-KF-VORON-4 | TWW-KF-VORON-4
Kinematics Mount V2.4 (350mm) (https://west3d.com/products/kinematics-mount?variant=42814774870228) | 1 | NO | YES | Mandala Roseworks Matched height kinematic kit (https://mandalaroseworks.com/products/matched-height-kinematic-kit) |  |  | Mandala Roseworks Matched height kinematic kit | Not required but highly recommended Shipping is split between orders. Purchased from Mandala Roseworks - Shop store | 1 | $88.00 | $88.00 | $4.06 | $0.00 | $92.06 | $92.06 |  | Received | TWW-KF-VORON-6 | TWW-KF-VORON-6
Kapton Tape | 1 | NO | YES |  |  |  | Kapton Tape | TODO: Figure out if needed and size | 1 | $0.00 | $0.00 |  |  | $0.00
Voron Zip Tie Kit (https://west3d.com/products/voron-zip-tie-kit) | 0 | NO |  |  |  |  | Voron Zip Tie Kit | TODO: Sizes? is there an assortment kit? | 0 | $4.00 | $0.00 |  |  | $0.00
Jet Black ASA Prusament (850g) - Primary color (https://www.printedsolid.com/collections/prusament/products/prusament-asa-1-75mm-850g-jet-black) | 3 | NO | YES |  |  |  | Jet Black ASA Prusament (850g) - Primary color | vendor: printedsolid.com; Purchased: 3 | 3 | $35.99 | $107.97 | $0.00 | $0.00 | $107.97 | $107.97 |  | Received | Voron Txn 1 (TWW-KF-VORON-1) TWW Kids fund (proj. voron): $71.98 on 10/07/2022 Voron Txn 5 (TWW-KF-VORON-5) TWW Kids fund (proj. voron): $136.98 on 12/02/2022 | TWW-KF-VORON-1 Pay Citicard CC from TWW account TWW-KF-VORON-5 Direct from TWW account
Jet Black ASA Prusament (850g) - Primary color; for mods (https://www.printedsolid.com/collections/prusament/products/prusament-asa-1-75mm-850g-jet-black) | 1 | NO | YES |  |  |  | Jet Black ASA Prusament (850g) - Primary color; for mods | vendor: printedsolid.com; Additional filament for printing mods | 1 | $35.99 | $35.99 | $0.00 | $0.00 | $35.99 | $35.99 |  | Ordered | Voron Txn 22 (TWW-KF-VORON-22) TWW Kids fund (proj. voron): $55.99 on 01/03/2022 | TWW-KF-VORON-22 Direct from TWW account
Lipstick Red ASA Prusament (850g) - Secondary color (https://www.printedsolid.com/collections/prusament/products/prusament-asa-lipstick-red-850g) | 1 | NO | YES |  |  |  | Lipstick Red ASA Prusament (850g) - Secondary color | vendor: printedsolid.com; Purchased: 1 | 1 | $35.99 | $35.99 | $0.00 |  | $35.99 | $35.99 |  | Received | TWW-KF-VORON-1 | TWW-KF-VORON-1
Jessie Premium PLA 1.75mm X Blue Moon 1kg (https://www.printedsolid.com/collections/1-75mm-jessie/products/jessie-pla-1-75mm-x-1kg-blue-moon) | 1 | NO | YES |  |  |  | Jessie Premium PLA 1.75mm X Blue Moon 1kg | vendor: printedsolid.com; for initial calibration and testing | 1 | $20.00 | $20.00 | $0.00 |  | $20.00 | $20.00 |  | Ordered | TWW-KF-VORON-22 | TWW-KF-VORON-22
BTT Smart Filament Runout Sensor (SFS) (https://west3d.com/products/btt-smart-filament-runout-sensor-sfs) | 1 | NO | YES | BTT SFS V1.0 Smart Filament Sensor (from DFH) (https://dfh.fm/products/btt-sfs-v1-0-smart-filament-sensor) |  |  | BTT SFS V1.0 Smart Filament Sensor (from DFH) | vendor: DFH via Shop | 1 | $20.00 | $20.00 | $3.27 | $0.00 | $23.27 | $23.27 |  | Ordered | TWW-KF-VORON-13 | TWW-KF-VORON-13
BTT CB1 Heatsink (https://west3d.com/products/btt-cb1-heatsink) | 2 | NO | YES |  |  |  | BTT CB1 Heatsink | 1 for Voron. 1 for private stock | 2 | $5.99 | $11.98 | $0.00 | $0.00 | $11.98 | $11.98 | -$5.99 | Received | TWW-KF-VORON-3 | TWW-KF-VORON-3
Mandala Roseworks Kinematic center brace for Voron 2.4 (https://mandalaroseworks.com/products/kinematic-center-brace-for-voron-2-4) | 1 | NO | YES |  |  |  | Mandala Roseworks Kinematic center brace for Voron 2.4 | Shipping is split between items. Purchased from Mandala Roseworks - Shop store | 1 | $35.00 | $35.00 | $4.06 | $0.00 | $39.06 | $39.06 |  | Received | Voron Txn 6 (TWW-KF-VORON-6) TWW Kids fund (proj. voron): $131.12 on 12/05/2022 total shipping: $8.12 | TWW-KF-VORON-6 Direct from TWW account
Mandala Roseworks The "Gripper" E3DV6 Wrench (https://mandalaroseworks.com/products/the-gripper-e3dv6-wrench) | 1 | NO | YES |  |  |  | Mandala Roseworks The "Gripper" E3DV6 Wrench | Tool. Not just for Voron though. Purchase through Mandala Roseworks - Shop store | 1 | $29.00 | $29.00 | $6.27 | $0.00 | $35.27 | $35.27 | -$35.27 | Received | Voron Txn 7 (TWW-KF-VORON-7) TWW Kids fund (proj. voron): $35.27 on 12/05/2022 total shipping: $6.27 | TWW-KF-VORON-7 Direct from TWW account
Layerneer Bed Weld - Original 3D printing adhesive (https://www.amazon.com/Printer-Adhesive-Layerneer-Original-Filament/dp/B079984GV5/) | 1 | NO | YES |  |  |  | Layerneer Bed Weld - Original 3D printing adhesive | Purchased from Amazon | 1 | $22.95 | $22.95 | $0.00 | $0.00 | $22.95 | $22.95 | -$22.95 | Received | Voron Txn 8 (TWW-KF-VORON-8) TWW Kids fund (proj. voron): $22.95 on 12/05/2022 | TWW-KF-VORON-8 Direct from TWW account
Voron Tap - rail w/ optotap v2 (5-24v) and HW kit; from DFH (https://dfh.fm/products/voron-tap?variant=43703614341342) | 1 | NO | YES |  |  |  | Voron Tap - rail w/ optotap v2 (5-24v) and HW kit; from DFH | Shipping is split between items. Purchased from DFH - Shop store | 1 | $45.00 | $45.00 | $2.24 | $0.00 | $47.24 | $45.24 |  | Ordered | Voron Txn 9 (TWW-KF-VORON-9) TWW Kids fund (proj. voron): $182.63 on 12/08/2022 total shipping: $20.18; total discount: $18.05 | TWW-KF-VORON-9 Direct from TWW account
Nightlight on a stick - LED Strip; from DFH (https://dfh.fm/products/nightlight-on-a-stick-by-bartlammers) | 2 | NO | YES |  |  |  | Nightlight on a stick - LED Strip; from DFH | Optional add-on Purchased from DFH - Shop store | 2 | $17.50 | $35.00 | $4.48 | $0.00 | $39.48 | $35.47 | -$35.47 | Ordered | TWW-KF-VORON-9 | TWW-KF-VORON-9
Disco stick on black PCB - LED Strip; from DFH (https://dfh.fm/products/disco-stick?variant=43340754976990) | 2 | NO | YES |  |  |  | Disco stick on black PCB - LED Strip; from DFH | Optional add-on Purchased from DFH - Shop store | 2 | $16.50 | $33.00 | $4.48 | $0.00 | $37.48 | $33.47 |  | Ordered | TWW-KF-VORON-9 | TWW-KF-VORON-9
OV5640 Camera Module; from DFH (https://dfh.fm/products/ov5640-camera-module) | 1 | NO | YES |  |  |  | OV5640 Camera Module; from DFH | Optional add-on Purchased from DFH - Shop store | 1 | $32.50 | $32.50 | $2.24 | $0.00 | $34.74 | $32.74 |  | Ordered | TWW-KF-VORON-9 | TWW-KF-VORON-9
Seeeduino XIAO; from DFH (https://dfh.fm/products/seeeduino-xiao') | 2 | NO | NO (not for Voron) |  |  |  | Seeeduino XIAO; from DFH | Not all for Voron. LED controller and other projects Purchased from DFH - Shop store | 2 | $10.00 | $20.00 | $4.48 | $0.00 | $24.48 | $20.47 | -$10.24 | Ordered | TWW-KF-VORON-9 | TWW-KF-VORON-9
Daylight on a stick on black PCB; from DFH (https://dfh.fm/products/daylight-on-a-stick-by-bartlammers?variant=43155177308382) | 1 | NO | NO (not for Voron) |  |  |  | Daylight on a stick on black PCB; from DFH | Bought for other projects Purchased from DFH - Shop store | 1 | $15.00 | $15.00 | $2.24 | $0.00 | $17.24 | $15.24 | -$15.24 | Ordered | TWW-KF-VORON-9 | TWW-KF-VORON-9
MR85 Bearings |  |  |  |  |  |  |  | Toolhead parts for: Stealth Burner + Clockwork2 + Phaetus Rapido UHF | 0 |  | $0.00 |  |  | $0.00
M3 x 6 FHCS |  |  |  |  |  |  |  | Toolhead parts for: Stealth Burner + Clockwork2 + Phaetus Rapido UHF | 0 |  | $0.00 |  |  | $0.00
LDO Nema14 36mm Pancake Stepper Motor LDO-36STH20-1004AHG (https://west3d.com/products/ldo-nema14-36mm-pancake-stepper-motor-ldo-36sth20-1004ahg?variant=41897549562068) | 1 | NO | YES |  |  |  | LDO Nema14 36mm Pancake Stepper Motor LDO-36STH20-1004AHG | Toolhead parts for: Stealth Burner + Clockwork2 + Phaetus Rapido UHF | 1 | $20.99 | $20.99 | $0.00 | $0.00 | $20.99 | $20.99 |  | Received | TWW-KF-VORON-11 | TWW-KF-VORON-11
Hartk Stealthburner Toolhead PCB (https://west3d.com/products/hartk-stealthburner-toolhead-pcb?variant=42679613718740) | 1 | NO | YES |  |  |  | Hartk Stealthburner Toolhead PCB | Toolhead parts for: Stealth Burner + Clockwork2 + Phaetus Rapido UHF | 1 | $21.99 | $21.99 | $0.00 | $0.00 | $21.99 | $21.99 |  | Received | TWW-KF-VORON-11 | TWW-KF-VORON-11
5015 GDSTIME DC 24V 50x50x15 Centrifugal Blower Fan GDB5015Dual Ball Bearing 6000RPM 2.2W .1A XH2.54 (https://west3d.com/products/gdstime-dc-24v-50x50x15-centrifugal-blower-fan-gdb5015dual-ball-bearing-6000rpm-2-2w-1a-xh2-54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) | 1 | NO | YES |  |  |  | 5015 GDSTIME DC 24V 50x50x15 Centrifugal Blower Fan GDB5015Dual Ball Bearing 6000RPM 2.2W .1A XH2.54 | Toolhead parts for: Stealth Burner + Clockwork2 + Phaetus Rapido UHF | 1 | $8.99 | $8.99 | $0.00 | $0.00 | $8.99 | $8.99 |  | Received | TWW-KF-VORON-11 | TWW-KF-VORON-11
Voron Stealthburner Fastener and LED Kit (https://dfh.fm/products/voron-stealthburner-fastener-and-led-kit) | 1 | NO | YES |  |  |  | Voron Stealthburner Fastener and LED Kit | Purchased from DFH via shop. Not sure if I duplicated the parts. | 1 | $12.00 | $12.00 | $3.27 | $0.00 | $15.28 | $15.28 |  | Ordered | TWW-KF-VORON-13 | TWW-KF-VORON-13
Voron 2.4 and Trident Sexbolt Z Endstop Super Kit (https://dfh.fm/products/voron-2-4-sexbolt-z-endstop-super-kit?variant=42577694163166) | 1 | NO | YES |  |  |  | Voron 2.4 and Trident Sexbolt Z Endstop Super Kit | Purchased from DFH via shop. Some parts are duplicated. | 1 | $15.00 | $15.00 | $3.27 | $0.00 | $18.27 | $18.27 |  | Ordered | TWW-KF-VORON-13 | TWW-KF-VORON-13
Capricornus PTFE Tube 1.9mm Teflonto Bowden Tube - Red (https://west3d.com/products/capricornus-ptfe-tube-1-9mm-teflonto?variant=42504300462292) | 2 | NO | YES |  |  |  | Capricornus PTFE Tube 1.9mm Teflonto Bowden Tube - Red | Addon. May not need | 2 | $4.99 | $9.98 | $2.75 | $0.00 | $12.73 | $12.73 |  | Ordered | Voron Txn 19 (TWW-KF-VORON-19) TWW Kids fund (proj. voron): $35.83 on 12/27/2022 | TWW-KF-VORON-19 Direct from TWW account
5mm x 10m Single Sided Self Adhesive Tape / 3mm thick (https://west3d.com/products/5mm-x-10m-single-sided-self-adhesive-tape-3mm-thick) | 1 | NO | YES |  |  |  | 5mm x 10m Single Sided Self Adhesive Tape / 3mm thick | For sealing enclosure | 1 | $5.99 | $5.99 | $1.38 | $0.00 | $7.37 | $7.37 |  | Ordered | TWW-KF-VORON-19 | TWW-KF-VORON-19
MODIFI3D - PRO 3D Print Finishing and Repair Tool (https://www.printedsolid.com/products/modifi3d-pro-3d-print-finishing-and-repair-tool?variant=31596345426005) | 1 | NO | NO (not for Voron) |  |  |  | MODIFI3D - PRO 3D Print Finishing and Repair Tool | vendor: Printedsolid.com | 1 |  | $89.99 | $0.00 | $0.00 | $89.99 | $89.99 | -$89.99 | Received | Voron Txn 10 (TWW-KF-VORON-10) TWW Kids fund (proj. voron): $89.99 on 12/21/2022 | TWW-KF-VORON-10 Direct from TWW account
SK6812 RGBW 5v LED (Similar to NeoPixel) (https://west3d.com/products/sk6812-rgbw-5v-led-neopixel?variant=42230909632724) | 4 | NO | YES |  |  |  | SK6812 RGBW 5v LED (Similar to NeoPixel) | Toolhead parts for: Stealth Burner + Clockwork2 + Phaetus Rapido UHF | 4 | $1.29 | $5.16 | $0.00 | $0.00 | $5.16 | $5.16 |  | Received | Voron Txn 11 (TWW-KF-VORON-11) TWW Kids fund (proj. voron): $581.28 on 12/21/2022 | TWW-KF-VORON-11 Direct from TWW account
LBY 100pcs Binding Screw kit,M5 x 10/20/30/40/50; Nickel Plated (Black) (https://www.amazon.com/dp/B0B5RBWM3Y?th=1) | 1 | NO | YES |  |  |  | LBY 100pcs Binding Screw kit,M5 x 10/20/30/40/50; Nickel Plated (Black) | Nevermore Micro V5 Duo Filter and MRW Voron 2.4 mod parts | 1 | $9.19 | $9.19 | $0.00 | $0.65 | $9.84 | $9.84 |  | Received | Voron Txn 17 (TWW-KF-VORON-17) TWW Kids fund (proj. voron): $17.48 on 12/27/2022 | TWW-KF-VORON-17 Direct from TWW account
uxcell 10pcs Sleeve Bearing 5x7x8mm (https://www.amazon.com/dp/B07JLVRYKT) | 1 | NO | YES |  |  |  | uxcell 10pcs Sleeve Bearing 5x7x8mm | Nevermore Micro V5 Duo Filter and MRW Voron 2.4 mod parts | 1 | $6.99 | $6.99 | $0.00 | $0.65 | $7.64 | $7.64 |  | Received | TWW-KF-VORON-17 | TWW-KF-VORON-17
5015 24v Dual Ball Blower (https://dfh.fm/products/5015-24v-dual-ball-blower?variant=39612699738281) | 2 | NO | YES |  |  |  | 5015 24v Dual Ball Blower | Nevermore Micro V5 Duo Filter and MRW Voron 2.4 mod parts | 2 | $8.00 | $16.00 | $4.92 | $0.00 | $20.92 | $20.92 |  | Received | Voron Txn 15 (TWW-KF-VORON-15) TWW Kids fund (proj. voron): $45.95 on 12/27/2022 | TWW-KF-VORON-15 Direct from TWW account
Nevermore Printer Carbon (https://dfh.fm/products/nevermore-printer-carbon?variant=42292685209822) | 1 | NO | YES |  |  |  | Nevermore Printer Carbon | Nevermore Micro V5 Duo Filter and MRW Voron 2.4 mod parts | 1 | $13.50 | $13.50 | $4.92 | $0.00 | $18.42 | $18.42 |  | Received | TWW-KF-VORON-15 | TWW-KF-VORON-15
Neodymium Magnet 6x3 Round - 10 Pack (https://dfh.fm/products/neodymium-magnet-6x3-round?variant=40397500940457) | 1 | NO | YES |  |  |  | Neodymium Magnet 6x3 Round - 10 Pack | Nevermore Micro V5 Duo Filter and MRW Voron 2.4 mod parts | 1 | $1.69 | $1.69 | $4.92 | $0.00 | $6.61 | $6.61 |  | Received | TWW-KF-VORON-15 | TWW-KF-VORON-15
M3x12 SHCS; Class 12.9 alloy steel black oxide finish (https://www.boltdepot.com/Product-Details.aspx?product=13637) | 8 | NO | YES |  |  |  | M3x12 SHCS; Class 12.9 alloy steel black oxide finish | Nevermore Micro V5 Duo Filter and MRW Voron 2.4 mod parts | 8 | $0.12 | $0.96 | $1.24 | $0.20 | $2.40 | $2.40 |  | Received | Voron Txn 18 (TWW-KF-VORON-18) TWW Kids fund (proj. voron): $11.05 on 12/27/2022 | TWW-KF-VORON-18 Direct from TWW account
M5x8 SHCS; Class 12.9 alloy steel black oxide finish (https://www.boltdepot.com/Product-Details.aspx?product=65183) | 8 | NO | YES |  |  |  | M5x8 SHCS; Class 12.9 alloy steel black oxide finish | Nevermore Micro V5 Duo Filter and MRW Voron 2.4 mod parts | 8 | $0.11 | $0.88 | $1.24 | $0.20 | $2.32 | $2.32 |  | Received | TWW-KF-VORON-18 | TWW-KF-VORON-18
M3x30 SHCS; Class 12.9 alloy steel black oxide finish (https://www.boltdepot.com/Product-Details.aspx?product=13641) | 12 | NO | YES |  |  |  | M3x30 SHCS; Class 12.9 alloy steel black oxide finish | Nevermore Micro V5 Duo Filter and MRW Voron 2.4 mod parts | 12 | $0.20 | $2.40 | $1.24 | $0.20 | $3.84 | $3.84 |  | Received | TWW-KF-VORON-18 | TWW-KF-VORON-18
M3x30 SHCS; Stainless steel 18-8 (A-2) (https://www.boltdepot.com/Product-Details.aspx?product=6385) | 8 | NO | NO (not for Voron) |  |  |  | M3x30 SHCS; Stainless steel 18-8 (A-2) | Not for Voron. Polyform parts | 8 | $0.13 | $1.04 | $1.24 | $0.20 | $2.48 | $2.48 | -$2.48 | Received | TWW-KF-VORON-18 | TWW-KF-VORON-18
Clockwise Tools DITR-0105 Digital Dial Indicator Gauge; 0.00005 Inch/0.001mm Resolution (https://www.amazon.com/gp/product/B07888LX1R) | 1 | NO | YES |  |  |  | Clockwise Tools DITR-0105 Digital Dial Indicator Gauge; 0.00005 Inch/0.001mm Resolution | Bed calibration tools. Purchased from Amazon | 1 | $63.84 | $63.84 | $0.00 | $2.96 | $66.80 | $66.80 |  | Received | Voron Txn 20 (TWW-KF-VORON-20) TWW Kids fund (proj. voron): $79.74 on 12/22/2022 | TWW-KF-VORON-20 Direct from TWW account
TÜRLEN Premium 22 pc Dial/Digital Indicator End Tip Point Set (https://www.amazon.com/gp/product/B0043F776) | 1 | NO | YES |  |  |  | TÜRLEN Premium 22 pc Dial/Digital Indicator End Tip Point Set | Bed calibration tools. Purchased from Amazon | 1 | $9.99 | $9.99 | $0.00 | $2.96 | $12.95 | $12.95 |  | Received | TWW-KF-VORON-20 | TWW-KF-VORON-20
Spring Loaded M3 T-Nuts for 2020 Series Aluminum Extrusions; 100 pack (https://www.amazon.com/100-Pack-Aluminum-Extrusions-Profile-Accessories/dp/B08YNFGYNH?th=1) | 1 | NO | YES |  |  |  |  | Additional 2020 M3 T-Nuts. B/c ball-joint T-Nuts are the shiz | 1 | $18.01 | $18.01 | $0.00 | $1.33 | $19.34 | $19.34 |  | Received | Voron Txn 21 (TWW-KF-VORON-21) TWW Kids fund (proj. voron): $18.01 on 12/28/2022 | TWW-KF-VORON-21 Direct from TWW account
 |  |  |  |  |  |  |  |  | 0 |  | $0.00 |  |  | $0.00
 |  |  |  |  |  |  |  |  | 0 |  | $0.00 |  |  | $0.00
 |  |  |  |  |  |  |  |  | 0 |  | $0.00 |  |  | $0.00
 |  |  |  |  |  |  |  |  | 0 |  | $0.00 |  |  | $0.00
 |  |  |  |  |  |  |  |  | 0 |  | $0.00 |  |  | $0.00
 |  |  |  |  |  |  |  |  | 0 |  | $0.00 |  |  | $0.00
 |  |  |  |  |  |  |  |  | 0 |  | $0.00 |  |  | $0.00
 |  |  |  |  |  |  |  |  | 0 |  | $0.00 |  |  | $0.00
 |  |  |  |  |  |  |  |  | 0 |  | $0.00 |  |  | $0.00
 |  |  |  |  |  |  |  |  | 0 |  | $0.00 |  |  | $0.00
 |  |  |  |  |  |  |  |  | 0 |  | $0.00 |  |  | $0.00
 |  |  |  |  |  |  |  |  | 0 |  | $0.00 |  |  | $0.00
 |  |  |  |  |  |  |  |  | 0 |  | $0.00 |  |  | $0.00
 |  |  |  |  |  |  |  |  | 0 |  | $0.00 |  |  | $0.00
 |  |  |  |  |  |  |  |  | 0 |  | $0.00 |  |  | $0.00
 |  |  |  |  |  |  |  |  | 0 |  | $0.00 |  |  | $0.00
 |  |  |  |  |  |  |  |  | 0 |  | $0.00 |  |  | $0.00
 |  |  |  |  |  |  |  |  | 0 |  | $0.00 |  |  | $0.00
 |  |  |  |  |  |  |  |  | 0 |  | $0.00 |  |  | $0.00
 |  |  |  |  |  |  |  |  | 0 |  | $0.00 |  |  | $0.00
 |  |  |  |  |  |  |  |  | 0 |  | $0.00 |  |  | $0.00
 |  |  |  |  |  |  |  |  | 0 |  | $0.00 |  |  | $0.00
 |  |  |  |  |  |  |  |  | 0 |  | $0.00 |  |  | $0.00
 |  |  |  |  |  |  |  |  | 0 |  | $0.00 |  |  | $0.00
 |  |  |  |  |  |  |  |  | 0 |  | $0.00 |  |  | $0.00
 |  |  |  |  |  |  |  |  | 0 |  | $0.00 |  |  | $0.00
 |  |  |  |  |  |  |  |  | 0 |  | $0.00 |  |  | $0.00
 |  |  |  |  |  |  |  |  | 0 |  | $0.00 |  |  | $0.00
 |  |  |  |  |  |  |  |  | 0 |  | $0.00 |  |  | $0.00
 |  |  |  |  |  |  |  |  | 0 |  | $0.00 |  |  | $0.00
 |  |  |  |  |  |  |  | Totals |  |  | $2993.34 | $227.22 | $9.36 | $3229.92 | $3166.05 | -$365.57
 |  |  |  |  |  |  |  |  |  |  |  |  |  |  |  | Remaining to spend | -$301.70
 |  |  |  |  |  |  |  |  |  |  |  |  |  |  |  | Total spent | $3166.05
 |  |  |  |  |  |  |  |  |  |  |  |  |  |  |  | Total cost of non-Voron parts | $365.57
 |  |  |  |  |  |  |  |  |  |  |  |  |  |  |  | To refund to Apple CC | $146.82
 |  |  |  |  |  |  |  |  |  |  |  |  |  |  |  | To refund to CitiCard CC | $71.98
 |  |  |  |  |  |  |  |  |  |  |  |  |  |  |  | TWW direct purchase | $2792.18

Sheet: Voron Stealthburner BOM
WEST3D V2.4 Configurator - BOM In a Box
Description | Quantity | Configurable | BOM mod | Config 1 | Config 2 | Config 3 | My Choice | Notes | Actual Qty. | Unit Cost | Cost (parts only) | Shipping | Taxes | Total Cost | Actual Cost | Cost Adjustments | Status | Funding / Accounting Info | Accounting Tasking / Status
MR85 Bearings |  |  |  |  |  |  |  | Toolhead parts for: Stealth Burner + Clockwork2 + Phaetus Rapido UHF | 0 |  | $0.00 |  |  | $0.00
M3 x 6 FHCS |  |  |  |  |  |  |  |  | 0 |  | $0.00 |  |  | $0.00
 |  |  |  |  |  |  |  |  | 0 |  | $0.00 |  |  | $0.00
 |  |  |  |  |  |  |  |  | 0 |  | $0.00 |  |  | $0.00
 |  |  |  |  |  |  |  |  | 0 |  | $0.00 |  |  | $0.00
 |  |  |  |  |  |  |  |  | 0 |  | $0.00 |  |  | $0.00
 |  |  |  |  |  |  |  |  | 0 |  | $0.00 |  |  | $0.00
 |  |  |  |  |  |  |  |  | 0 |  | $0.00 |  |  | $0.00
 |  |  |  |  |  |  |  |  | 0 |  | $0.00 |  |  | $0.00
 |  |  |  |  |  |  |  |  | 0 |  | $0.00 |  |  | $0.00
 |  |  |  |  |  |  |  |  | 0 |  | $0.00 |  |  | $0.00
 |  |  |  |  |  |  |  |  | 0 |  | $0.00 |  |  | $0.00
 |  |  |  |  |  |  |  |  | 0 |  | $0.00 |  |  | $0.00
 |  |  |  |  |  |  |  |  | 0 |  | $0.00 |  |  | $0.00
 |  |  |  |  |  |  |  |  | 0 |  | $0.00 |  |  | $0.00
 |  |  |  |  |  |  |  |  | 0 |  | $0.00 |  |  | $0.00
 |  |  |  |  |  |  |  |  | 0 |  | $0.00 |  |  | $0.00
 |  |  |  |  |  |  |  |  | 0 |  | $0.00 |  |  | $0.00
 |  |  |  |  |  |  |  |  | 0 |  | $0.00 |  |  | $0.00
 |  |  |  |  |  |  |  |  | 0 |  | $0.00 |  |  | $0.00
 |  |  |  |  |  |  |  |  | 0 |  | $0.00 |  |  | $0.00
 |  |  |  |  |  |  |  |  | 0 |  | $0.00 |  |  | $0.00
 |  |  |  |  |  |  |  |  | 0 |  | $0.00 |  |  | $0.00
 |  |  |  |  |  |  |  |  | 0 |  | $0.00 |  |  | $0.00
 |  |  |  |  |  |  |  |  | 0 |  | $0.00 |  |  | $0.00
 |  |  |  |  |  |  |  |  | 0 |  | $0.00 |  |  | $0.00
 |  |  |  |  |  |  |  |  | 0 |  | $0.00 |  |  | $0.00
 |  |  |  |  |  |  |  |  | 0 |  | $0.00 |  |  | $0.00
 |  |  |  |  |  |  |  |  | 0 |  | $0.00 |  |  | $0.00
 |  |  |  |  |  |  |  |  | 0 |  | $0.00 |  |  | $0.00
 |  |  |  |  |  |  |  |  | 0 |  | $0.00 |  |  | $0.00
 |  |  |  |  |  |  |  |  | 0 |  | $0.00 |  |  | $0.00
 |  |  |  |  |  |  |  |  | 0 |  | $0.00 |  |  | $0.00
 |  |  |  |  |  |  |  |  | 0 |  | $0.00 |  |  | $0.00
 |  |  |  |  |  |  |  |  | 0 |  | $0.00 |  |  | $0.00
 |  |  |  |  |  |  |  |  | 0 |  | $0.00 |  |  | $0.00
 |  |  |  |  |  |  |  |  | 0 |  | $0.00 |  |  | $0.00
 |  |  |  |  |  |  |  |  | 0 |  | $0.00 |  |  | $0.00
 |  |  |  |  |  |  |  |  | 0 |  | $0.00 |  |  | $0.00
 |  |  |  |  |  |  |  |  | 0 |  | $0.00 |  |  | $0.00
 |  |  |  |  |  |  |  |  | 0 |  | $0.00 |  |  | $0.00
 |  |  |  |  |  |  |  |  | 0 |  | $0.00 |  |  | $0.00
 |  |  |  |  |  |  |  |  | 0 |  | $0.00 |  |  | $0.00
 |  |  |  |  |  |  |  |  | 0 |  | $0.00 |  |  | $0.00
 |  |  |  |  |  |  |  |  | 0 |  | $0.00 |  |  | $0.00
 |  |  |  |  |  |  |  |  | 0 |  | $0.00 |  |  | $0.00
 |  |  |  |  |  |  |  |  | 0 |  | $0.00 |  |  | $0.00
 |  |  |  |  |  |  |  |  | 0 |  | $0.00 |  |  | $0.00
 |  |  |  |  |  |  |  |  | 0 |  | $0.00 |  |  | $0.00
 |  |  |  |  |  |  |  |  | 0 |  | $0.00 |  |  | $0.00
 |  |  |  |  |  |  |  | Totals |  |  | $0.00 | $0.00 | $0.00 | $0.00 | $0.00 | $0.00
 |  |  |  |  |  |  |  |  |  |  |  |  |  |  |  | Remaining to spend | $0.00
 |  |  |  |  |  |  |  |  |  |  |  |  |  |  |  | Total spent | $0.00
 |  |  |  |  |  |  |  |  |  |  |  |  |  |  |  | Total cost of non-Voron parts | $0.00
 |  |  |  |  |  |  |  |  |  |  |  |  |  |  |  | To refund to Apple CC | $146.82
 |  |  |  |  |  |  |  |  |  |  |  |  |  |  |  | To refund to CitiCard CC | $71.98
 |  |  |  |  |  |  |  |  |  |  |  |  |  |  |  | TWW direct purchase | $1583.27

Sheet: Voron Stealthburner orig BOM
WEST3D V2.4 Configurator - BOM In a Box
Description | Quantity | Configurable | BOM mod | Config 1 | Config 2 | Config 3 | My Choice | Notes | Actual Qty. | Unit Cost | Cost (parts only) | Shipping | Taxes | Total Cost | Actual Cost | Cost Adjustments | Status | Funding / Accounting Info | Accounting Tasking / Status
MR85 Bearings |  |  |  |  |  |  |  | Toolhead parts for: Stealth Burner + Clockwork2 + Phaetus Rapido UHF | 0 |  | $0.00 |  |  | $0.00
M3 x 6 FHCS |  |  |  |  |  |  |  |  | 0 |  | $0.00 |  |  | $0.00
 |  |  |  |  |  |  |  |  | 0 |  | $0.00 |  |  | $0.00
 |  |  |  |  |  |  |  |  | 0 |  | $0.00 |  |  | $0.00
 |  |  |  |  |  |  |  |  | 0 |  | $0.00 |  |  | $0.00
 |  |  |  |  |  |  |  |  | 0 |  | $0.00 |  |  | $0.00
 |  |  |  |  |  |  |  |  | 0 |  | $0.00 |  |  | $0.00
 |  |  |  |  |  |  |  |  | 0 |  | $0.00 |  |  | $0.00
 |  |  |  |  |  |  |  |  | 0 |  | $0.00 |  |  | $0.00
 |  |  |  |  |  |  |  |  | 0 |  | $0.00 |  |  | $0.00
 |  |  |  |  |  |  |  |  | 0 |  | $0.00 |  |  | $0.00
 |  |  |  |  |  |  |  |  | 0 |  | $0.00 |  |  | $0.00
 |  |  |  |  |  |  |  |  | 0 |  | $0.00 |  |  | $0.00
 |  |  |  |  |  |  |  |  | 0 |  | $0.00 |  |  | $0.00
 |  |  |  |  |  |  |  |  | 0 |  | $0.00 |  |  | $0.00
 |  |  |  |  |  |  |  |  | 0 |  | $0.00 |  |  | $0.00
 |  |  |  |  |  |  |  |  | 0 |  | $0.00 |  |  | $0.00
 |  |  |  |  |  |  |  |  | 0 |  | $0.00 |  |  | $0.00
 |  |  |  |  |  |  |  |  | 0 |  | $0.00 |  |  | $0.00
 |  |  |  |  |  |  |  |  | 0 |  | $0.00 |  |  | $0.00
 |  |  |  |  |  |  |  |  | 0 |  | $0.00 |  |  | $0.00
 |  |  |  |  |  |  |  |  | 0 |  | $0.00 |  |  | $0.00
 |  |  |  |  |  |  |  |  | 0 |  | $0.00 |  |  | $0.00
 |  |  |  |  |  |  |  |  | 0 |  | $0.00 |  |  | $0.00
 |  |  |  |  |  |  |  |  | 0 |  | $0.00 |  |  | $0.00
 |  |  |  |  |  |  |  |  | 0 |  | $0.00 |  |  | $0.00
 |  |  |  |  |  |  |  |  | 0 |  | $0.00 |  |  | $0.00
 |  |  |  |  |  |  |  |  | 0 |  | $0.00 |  |  | $0.00
 |  |  |  |  |  |  |  |  | 0 |  | $0.00 |  |  | $0.00
 |  |  |  |  |  |  |  |  | 0 |  | $0.00 |  |  | $0.00
 |  |  |  |  |  |  |  |  | 0 |  | $0.00 |  |  | $0.00
 |  |  |  |  |  |  |  |  | 0 |  | $0.00 |  |  | $0.00
 |  |  |  |  |  |  |  |  | 0 |  | $0.00 |  |  | $0.00
 |  |  |  |  |  |  |  |  | 0 |  | $0.00 |  |  | $0.00
 |  |  |  |  |  |  |  |  | 0 |  | $0.00 |  |  | $0.00
 |  |  |  |  |  |  |  |  | 0 |  | $0.00 |  |  | $0.00
 |  |  |  |  |  |  |  |  | 0 |  | $0.00 |  |  | $0.00
 |  |  |  |  |  |  |  |  | 0 |  | $0.00 |  |  | $0.00
 |  |  |  |  |  |  |  |  | 0 |  | $0.00 |  |  | $0.00
 |  |  |  |  |  |  |  |  | 0 |  | $0.00 |  |  | $0.00
 |  |  |  |  |  |  |  |  | 0 |  | $0.00 |  |  | $0.00
 |  |  |  |  |  |  |  |  | 0 |  | $0.00 |  |  | $0.00
 |  |  |  |  |  |  |  |  | 0 |  | $0.00 |  |  | $0.00
 |  |  |  |  |  |  |  |  | 0 |  | $0.00 |  |  | $0.00
 |  |  |  |  |  |  |  |  | 0 |  | $0.00 |  |  | $0.00
 |  |  |  |  |  |  |  |  | 0 |  | $0.00 |  |  | $0.00
 |  |  |  |  |  |  |  |  | 0 |  | $0.00 |  |  | $0.00
 |  |  |  |  |  |  |  |  | 0 |  | $0.00 |  |  | $0.00
 |  |  |  |  |  |  |  |  | 0 |  | $0.00 |  |  | $0.00
 |  |  |  |  |  |  |  |  | 0 |  | $0.00 |  |  | $0.00
 |  |  |  |  |  |  |  | Totals |  |  | $0.00 | $0.00 | $0.00 | $0.00 | $0.00 | $0.00
 |  |  |  |  |  |  |  |  |  |  |  |  |  |  |  | Remaining to spend | $0.00
 |  |  |  |  |  |  |  |  |  |  |  |  |  |  |  | Total spent | $0.00
 |  |  |  |  |  |  |  |  |  |  |  |  |  |  |  | Total cost of non-Voron parts | $0.00
 |  |  |  |  |  |  |  |  |  |  |  |  |  |  |  | To refund to Apple CC | $146.82
 |  |  |  |  |  |  |  |  |  |  |  |  |  |  |  | To refund to CitiCard CC | $71.98
 |  |  |  |  |  |  |  |  |  |  |  |  |  |  |  | TWW direct purchase | $1583.27

Sheet: Voron Stealthburner srcng guide
Category | Component | Additional Info | Qty | All sizes | Recommended | Alternative Source | Alternative Source 2 | Notes
Hardware | M3 Brass Heatstake Inserts - Short |  | 19 | All | Amazon | McMaster-Carr | Aliexpress - M3x5x4
Hardware | Hotend Mounting Screws (M2.5) |  | 2 | All
Hardware | Hotend Mounting Screws (M3) |  | 4 | All
Hardware | M3x6 FHCS | ISO 10462 / DIN7991 | 3 | All
Hardware | M3x6 BHCS | ISO 7380-1 | 1 | All | Bolt Depot
Hardware | M3x8 SHCS | ISO 4762 / DIN 912 | 2 | All | Bolt Depot
Hardware | M3x10 SHCS | ISO 4762 / DIN 913 | 2 | All
Hardware | M3x12 SHCS | ISO 4762 / DIN 912 | 2 | All | Bolt Depot
Hardware | M3x16 SHCS | ISO 4762 / DIN 912 | 2 | All | Bolt Depot
Hardware | M3x20 SHCS | ISO 4762 / DIN 912 | 1 | All | Bolt Depot
Hardware | M3x25 SHCS | ISO 4762 / DIN 912 | 6 | All | Bolt Depot
Hardware | M3x30 SHCS | ISO 4762 / DIN 912 | 1 | All | Bolt Depot
Hardware | M3x50 SHCS | ISO 4762 / DIN 912 | 2 | All | McMaster
Hardware | M3 washer | ISO 4033 / DIN 934 | 1 | All
Electronics | NEMA14 36mm Round Pancake Motor with 10 tooth gear 20mm |  | 1 | All
Electronics | 50x50x15 Centrefugal Fan |  | 1 | All
Electronics | 4010 Axial Fan |  | 1 | All
Electronics | NeoPixel RGBW Mini Button PCB |  | 3 | All
Misc. | 6x3mm Magnet |  | 1 | All
Misc. | PTFE Tube |  | 1 | All
Motion | BMG Extruder Insides |  | 1 | All | Aliexpress (TL)
Cables | MicroFit3 Male Pin |  | 3 | All
Cables | MicroFit3 Female Pin |  | 3 | All
Cables | MicroFit3 Connector Receptical 3 Position |  | 1 | All
Cables | MicroFit3 Connector Plug 3 Position |  | 1 | All
Cables | 30AWG PTFE Cable (3ft total) |  | 1 | All
Cables | 24AWG PTFE Cable (30ft total) |  | 1 | All
ADXL Optional | M3x12 SHCS |  | 2 | All
ADXL Optional | M3 Threaded Inserts - short |  | 2 | All
ADXL Optional | M2x10 self tapping screw |  | 2 | All
ADXL Optional | Harness for ADXL Sensor Module |  | 1 | All

Sheet: Voron2.4 350mm OUR BOM
Category | Description | Qty | Unit Cost | Cost | Shipping | Shipping Const | Total Cost | Actual Cost | Vendor | Part URL | Order Status | Notes | Original BOM Vendor | Additional Info | Funding / Accounting Info | Accounting Tasking / Status
Fasteners | Fastner kit (350mm x 350mm x 350mm) | 1 | $56.99 | $56.99 | $0.00 |  | $56.99 | $56.99 | www.voronkit.com |  | Ordered |  | www.voronkit.com | https://www.voronkit.com/products/voron-2-4-kit | Voron Txn 2 (TWW-KF-VORON-2) TWW Kids fund (proj. voron): $510.57 on 10/24/2022 | TWW-KF-VORON-2 Paid via TWW business acct. Update Oct. Invoice
Fasteners | M3x10 FHCS | 4 | $0.00 | $0.00 | $0.00 |  | $0.00 |  |  |  |  | TODO: Not in the Kit. Verify if this is just another screw
Motion | Motion kit (350mm x 350mm x 350mm) | 1 | $129.90 | $129.90 | $0.00 |  | $129.90 | $129.90 | www.voronkit.com | Voron Kit Store - Motion Kit (https://www.voronkit.com/products/voron-v2-4-motion-kit) | Ordered |  | www.voronkit.com | https://www.voronkit.com/products/voron-2-4-kit | TWW-KF-VORON-2 | TWW-KF-VORON-2
Motion | LDO Linear Rail MGN9H 400mm; black anondized stainless steel GS_MGN9-1H-B400 | 6 | $15.00 | $90.00 | $35.85 | $5.97 | $125.85 | $125.85 | robotdigg.com | Robot Digg - black anondize linear rail (http://robotdigg.com/product/1314/Black-anodized-linear-rail-7,-9,-12-and-15) | Ordered |  |  |  | Voron Txn 1 (TWW-KF-VORON-1) TWW Kids fund (proj. voron): $146.82 on 10/24/2022 | TWW-KF-VORON-1 Pay Apple CC from TWW account
Motion | LDO Linear Rail MGN12H 400mm; black anondized stainless steel GS_MGN12-1H-B400 | 1 | $15.00 | $15.00 | $5.97 | $5.97 | $20.97 | $20.97 | robotdigg.com | Robot Digg - black anondize linear rail (http://robotdigg.com/product/1314/Black-anodized-linear-rail-7,-9,-12-and-15) | Ordered |  |  |  | TWW-KF-VORON-1 | TWW-KF-VORON-1
Frame | Frame kit (350mm x 350mm x 350mm) | 1 | $129.99 | $129.99 | $0.00 |  | $129.99 | $129.99 | www.voronkit.com | Voron Kit Store - Frame Kit (https://www.voronkit.com/products/voron-v2-4-frame-kit?variant=39755687493720) | Ordered |  | www.voronkit.com | https://www.voronkit.com/products/voron-2-4-kit | TWW-KF-VORON-2 | TWW-KF-VORON-2
Cables | Cable kit (350mm x 350mm x 350mm) | 1 | $56.99 | $56.99 | $0.00 |  | $56.99 |  | www.voronkit.com | Voron Kit Store - Cables Kit (https://www.voronkit.com/products/voron-v2-4-cables-kit) |  |  | www.voronkit.com | https://www.voronkit.com/products/voron-2-4-kit
Misc | Misc. Parts Kit | 1 | $65.99 | $65.99 | $0.00 |  | $65.99 | $65.99 | www.voronkit.com | Voron Kit Store - Misc Parts (https://www.voronkit.com/products/voron-v2-4-misc-parts) | Ordered | See contents of Misc Parts Kit | www.voronkit.com | https://www.voronkit.com/products/voron-2-4-kit | TWW-KF-VORON-2 | TWW-KF-VORON-2
Electronics | BTT Mini 12864 Screen | 2 | $13.90 | $27.80 | $0.00 |  | $27.80 | $27.80 | www.voronkit.com | Voron Kit Store - BTT Mini 12864 screen (https://www.voronkit.com/products/btt-mini-12864-screen) | Ordered | Actually bought 2 (1 x vonon + 1 x polyformer | www.voronkit.com | https://www.voronkit.com/products/voron-2-4-kit | TWW-KF-VORON-2 | TWW-KF-VORON-2
Electronics | BTT TMC 2209 v1.2 Stepper Motor Driver | 7 | $5.90 | $41.30 | $0.00 |  | $41.30 |  | www.voronkit.com | Voron Kit Store - BTT TMC 2209 v1.2 (https://www.voronkit.com/products/btt-tmc-2209-v12) |  |  | www.voronkit.com | https://www.voronkit.com/products/voron-2-4-kit
Electronics | Steppers Kits | 1 | $99.90 | $99.90 | $0.00 |  | $99.90 | $99.00 | www.voronkit.com | Voron Kit Store - Steppers Kit (https://www.voronkit.com/products/voron-v24-steppers-kit) | Ordered | NEMA17 Stepper Motor 17HS19-2004S NEMA17 Stepper Motor 17HS08-1004S | www.voronkit.com | https://www.voronkit.com/products/voron-2-4-kit | TWW-KF-VORON-2 | TWW-KF-VORON-2
Electronics | BTT Manta M8P Klipper Controller Board / 3D Printer Control System using CB1/CM4 | 1 | $54.99 | $54.99 | $0.00 |  | $54.99 |  | west3d.com | West3D - BTT Manta M8P control board (https://west3d.com/products/btt-manta-m8p-klipper-controller-board-3d-printer-control-system-using-cb1-cm4) |  | Eliminates need for an RPi. TODO: Is there a change to the power supply req?
Electronics | BTT CB1 Computing Core Board Adapter for Manta Controller Boards | 1 | $29.99 | $29.99 | $0.00 |  | $29.99 |  | west3d.com | West3D - BTT CB1 adapter (https://west3d.com/products/btt-cb1-adapter-for-manta-controller-boards) |  | Eliminates need for an RPi. TODO: Is there a change to the power supply req?
Electronics | Auto bed leveling sensor (high quality) - Omrn TL-Q5MC2-Z | 1 | $27.90 | $27.90 | $0.00 |  | $27.90 |  | www.voronkit.com | Voron Kit Store - OMRN TL-Q5MC2-Z (https://www.voronkit.com/products/omron-tl-q5mc2?pr_prod_strat=copurchase_transfer_learning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) |  | Proximity switch. Compat w/ Voron 2.2 and 2.4 | www.voronkit.com
Electronics | Mean Well LRS-200-24 PSU; 24v power supply | 1 | $32.90 | $32.90 | $0.00 |  | $32.90 |  | www.voronkit.com | Voron Kit Store - MeanWell LRS-200-24 (https://www.voronkit.com/products/meanwell-lrs-200-24) |  |  | www.voronkit.com | https://www.voronkit.com/products/voron-2-4-kit
Electronics | Mean Well RS-25-5 PSU; 5v power supply | 1 | $13.90 | $13.90 | $0.00 |  | $13.90 |  | www.voronkit.com | Voron Kit Store - MeanWell RS-25-5 (https://www.voronkit.com/products/meanwell-rs-25-5) |  |  | www.voronkit.com | https://www.voronkit.com/products/voron-2-4-kit
Electronics | OMRON G3NB-210B DC5-24 SSR . solid state relay | 1 | $22.90 | $22.90 | $0.00 |  | $22.90 |  | www.voronkit.com | Voron Kit Store - OMRON G3NB-210B (https://www.voronkit.com/products/omron-g3nb-210b-dc5-24-misumi) |  |  | www.voronkit.com | MiSUMi - G3NA-210B DC5-24 (https://us.misumi-ec.com/vona2/detail/222000863384/?HissuCode=G3NA-210B%20DC5-24)
Electronics | Omron D2F-01L Micro Switch | 3 | $0.00 | $0.00 | $0.00 |  | $0.00
Electronics | Inductive Probe (See sourcing guide) | 1 | $0.00 | $0.00 | $0.00 |  | $0.00 |  |  |  |  | TODO: Is this the same as the auto-bed leveling sensor? |  | https://www.digikey.com/en/products/detail/panasonic-industrial-automation-sales/GX-HL15B/3896951 https://www.digikey.com/en/products/detail/omron-automation-and-safety/tl-q5mc2/2669828 https://www.aliexpress.us/item/2251832663198775.html?gatewayAdapt=glo2usa&_randl_shipto=US
Electronics | Hotend Kit (24V) | 1 | $0.00 | $0.00 | $0.00 |  | $0.00 |  |  |  |  | Need to figure out which hotend to start with. The Cables Kit comes with some parts, but not going to use them.
 |  |  | $0.00 | $0.00 | $0.00 |  | $0.00
 |  |  | $0.00 | $0.00 | $0.00 |  | $0.00
Electronics | TycoElectronics 10EGG1-1 Filtered Power Inlet (NA/UK) | 1 | $0.00 | $0.00 | $0.00 |  | $0.00 |  |  |  |  | Part of Cables Kit but is for non-US, Inlet Power Socket IEC320 C14 (With 8A250V Fuse). TODO: Get the US compat part
Electronics | Medium Blow Fuse 5x20mm 8A (120v mains) | 1 | $0.00 | $0.00 | $0.00 |  | $0.00 |  |  |  |  | Part of Cables Kit but is for non-US, Inlet Power Socket IEC320 C14 (With 8A250V Fuse). TODO: Get the US compat part
Electronics | Keystone CAT6 Insert (Optional) | 1 | $0.00 | $0.00 | $0.00 |  | $0.00
 |  |  | $0.00 | $0.00 | $0.00 |  | $0.00
Electronics | USB Cable for selected controller (TODO: Do we need this) | 1 | $0.00 | $0.00 | $0.00 |  | $0.00 | $0.00 |  |  | Own | Does this come with the BTT Octopus Pro 1.0?
Cables | Nylon Cable Ties, Small (.07-.10", 1.8-2.7mm wide) | 42 | $0.00 | $0.00 | $0.00 |  | $0.00
 |  |  | $0.00 | $0.00 | $0.00 |  | $0.00
 |  |  | $0.00 | $0.00 | $0.00 |  | $0.00
 |  |  | $0.00 | $0.00 | $0.00 |  | $0.00
Cables | Female Spade Crimp Terminal (18-22AWG, .250", 6.35mm) | 7 | $0.00 | $0.00 | $0.00 |  | $0.00
Cables | Fork Spade Crimp Terminal (18-22AWG, #10) | 5 | $0.00 | $0.00 | $0.00 |  | $0.00
Cables | Ring Crimp Terminal (16-22AWG, #6) | 1 | $0.00 | $0.00 | $0.00 |  | $0.00
Cables | JST XH Connector, 3 Position Male/Female Pair plus Pins | 1 | $0.00 | $0.00 | $0.00 |  | $0.00
Cables | Connector kit matching your controller choice (usually JST-XH) | 1 | $0.00 | $0.00 | $0.00 |  | $0.00
Cables | Crimp Ferrule Kit (covering sizes 24AWG to 18AWG) | 1 | $0.00 | $0.00 | $0.00 |  | $0.00
Cables | WAGO 221-415 Lever-Nuts | 3 | $0.00 | $0.00 | $0.00 |  | $0.00
Cables | IGUS E2-15-10-028-0 Chain | 1 | $0.00 | $0.00 | $0.00 |  | $0.00 |  |  |  |  | Z Chain, (250 - 22 links) (300 - 25 links) (350 - 28 links)
Cables | IGUS E2-150-10-12PZ Chain Ends | 1 | $0.00 | $0.00 | $0.00 |  | $0.00 |  |  |  |  | Z Chain End link sets
Cables | IGUS E2i-10-10-018-0 Chain | 2 | $0.00 | $0.00 | $0.00 |  | $0.00 |  |  |  |  | X/Y Chain (250 - 16 links) (300 - 19 links) (350 - 21 links)
Cables | IGUS E2-100-10-12PZ Chain Ends | 2 | $0.00 | $0.00 | $0.00 |  | $0.00 |  |  |  |  | X/Y Chain End link sets
 |  |  | $0.00 | $0.00 | $0.00 |  | $0.00
 |  |  | $0.00 | $0.00 | $0.00 |  | $0.00 |  |  |  |  | Does this come with the BTT Octopus Pro 1.0?
 |  |  | $0.00 | $0.00 | $0.00 |  | $0.00
 |  |  | $0.00 | $0.00 | $0.00 |  | $0.00
 |  |  | $0.00 | $0.00 | $0.00 |  | $0.00
 |  |  | $0.00 | $0.00 | $0.00 |  | $0.00
 |  |  | $0.00 | $0.00 | $0.00 |  | $0.00
 |  |  | $0.00 | $0.00 | $0.00 |  | $0.00 |  |  |  |  | Does this come with the BTT Octopus Pro 1.0?
 |  |  | $0.00 | $0.00 | $0.00 |  | $0.00
 |  |  | $0.00 | $0.00 | $0.00 |  | $0.00
 |  |  | $0.00 | $0.00 | $0.00 |  | $0.00
 |  |  | $0.00 | $0.00 | $0.00 |  | $0.00
Fliament | Jet Black ASA (850g spool) - Primary color | 3 | $29.99 | $89.97 | $26.86 |  |  |  | Prusa3D (https://www.prusa3d.com/) | Prusament ASA (https://www.prusa3d.com/category/prusament-asa/) |  | Required qty: 2 x 1 kg spool |  | Purchased 1 spool; Jet Black ASA; printedsolid.com. (TODO: Check price)
Filament | Red ASA (850g spool) - Secondary color | 2 | $29.99 | $59.98 | $24.02 |  |  |  | Prusa3D (https://www.prusa3d.com/) | Prusament ASA (https://www.prusa3d.com/category/prusament-asa/) |  | Required qty: 1 x 1 kg spool |  | Purchased 1 spool; Lipstick Red ASA; printedsolid.com. (TODO: Check price)
 |  |  | $0.00 | $0.00 | $0.00 |  | $0.00
 |  |  | $0.00 | $0.00 | $0.00 |  | $0.00 |  |  |  |  | Does this come with the BTT Octopus Pro 1.0?
 |  |  | $0.00 | $0.00 | $0.00 |  | $0.00
 |  |  | $0.00 | $0.00 | $0.00 |  | $0.00
 |  |  | $0.00 | $0.00 | $0.00 |  | $0.00
 |  |  | $0.00 | $0.00 | $0.00 |  | $0.00
 |  |  | $0.00 | $0.00 | $0.00 |  | $0.00
 |  |  | $0.00 | $0.00 | $0.00 |  | $0.00 |  |  |  |  | Does this come with the BTT Octopus Pro 1.0?
 |  |  | $0.00 | $0.00 | $0.00 |  | $0.00
 |  |  | $0.00 | $0.00 | $0.00 |  | $0.00
 |  |  | $0.00 | $0.00 | $0.00 |  | $0.00
 |  |  | $0.00 | $0.00 | $0.00 |  | $0.00
 |  |  | $0.00 | $0.00 | $0.00 |  | $0.00
 |  |  |  |  |  |  |  | $656.49
Voron 2.4 Mods or alternative parts
Accessories | Logitech C270 HD Webcam w/ 3D printed mount | 1 | $34.99 | $34.99 | $0.00 |  | $34.99 |  | voronkits.com (https://voronkits.com/collections/voron-upgrades) | voronkits.com - Logitech C270 Webcam (https://voronkits.com/collections/voron-upgrades/products/logitech-c270-hd-webcam-with-3d-printed-mount-for-voron-2-4-trident-hd-720p-pc-mac-raspberry-pi)
Electronics | BTT Manta M8P Klipper Controller Board / 3D Printer Control System using CB1/CM4 | 1 | $54.99 | $54.99 | $0.00 |  | $54.99 |  | west3d.com | West3D - BTT Manta M8P control board (https://west3d.com/products/btt-manta-m8p-klipper-controller-board-3d-printer-control-system-using-cb1-cm4) |  | Eliminates need for an RPi. TODO: Is there a change to the power supply req?
Electronics | BTT CB1 Computing Core Board Adapter for Manta Controller Boards | 1 | $29.99 | $29.99 | $0.00 |  | $29.99 |  | west3d.com | West3D - BTT CB1 adapter (https://west3d.com/products/btt-cb1-adapter-for-manta-controller-boards) |  | Eliminates need for an RPi. TODO: Is there a change to the power supply req?
Electronics | BTT Octopus Pro F446 (180 Mhz ARM-Cortex-M4 CPU & 512 KB flash memory); Controller w/ 7 stepper outputs | 1 | $59.99 | $59.99 | $0.00 |  | $59.99 |  | www.voronkit.com | Voron Kit Store - BTT Octopus Pro (https://www.voronkit.com/products/btt-octopus-pro) |  | Octopus v1.0 Pro; DO NOT get the Octopus v1.1 | www.voronkit.com | Alt. control boards: SKR V1.4 Turbo Control Board
Electronics | RaspberryPi 4 w/ 4GB RAM Canakit. (RaspberryPi 3B+ or better) | 1 | $159.95 | $159.95 | $0.00 |  | $159.95 | $0.00 | www.canakit.com | Canakit - RPi4 4GB (https://www.canakit.com/raspberry-pi-4-4gb.html) | Own | No need to purchase necessary. already own.
Voron 2.4 Alternative part sources
Electronics | Auto bed leveling sensor (high quality) - Omrn TL-Q5MC2-Z | 1 | $21.99 | $21.99 | $0.00 |  | $21.99 |  | voronkits.com (https://voronkits.com/collections/voron-upgrades) | voronkits.com - OMRN TL-Q5MC2-Z (https://voronkits.com/collections/voron-upgrades/products/vorn2-4-auto-bed-leveling-sensor-omrn-tl-q5mc2-z-proximity-switch-3-wire-dc10-30v-shield-type-induct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) |  | Alt. source. | Maker Creatives - voronkits.com (https://voronkits.com/collections/voron-upgrades)
Motion | LDO Linear Rail MGN9H 400mm | 6 | $30.00 | $180.00 | $0.00 |  | $180.00 |  | printedsolid.com | Printed Solid - MGN9H (https://www.printedsolid.com/products/ldo-linear-rail-mgn9h-linear-rail-with-carriage-400mm-350mm-300mm-lengths) |  |  | www.printedsolid.com
Motion | LDO Linear Rail MGN9H 400mm; stainless steel | 6 | $35.94 | $215.64 | $0.00 |  | $215.64 |  | printedsolid.com | Printed Solid - MGN9H (stainless steel) (https://www.printedsolid.com/products/ldo-stainless-steel-linear-rail-mgn9h-with-carriage-400mm-350mm-300mm-lengths) |  | Alt. source and material | www.printedsolid.com
Motion | LDO Linear Rail MGN12H 400mm | 1 | $34.80 | $34.80 | $0.00 |  | $34.80 |  | printedsolid.com | Printed Solid - MGN12H (https://www.printedsolid.com/products/ldo-linear-rail-mgn12h-with-one-carriage-in-300-400-500-700mm-lengths) |  |  | www.printedsolid.com
Motion | LDO Linear Rail MGN9H 400mm; black anondized stainless steel GS_MGN9-1H-B400 | 6 | $15.00 | $90.00 | $35.85 | $5.97 | $125.85 |  | robotdigg.com | Robot Digg - black anondize linear rail (http://robotdigg.com/product/1314/Black-anodized-linear-rail-7,-9,-12-and-15)
Motion | LDO Linear Rail MGN12H 400mm; black anondized stainless steel GS_MGN12-1H-B400 | 1 | $15.00 | $15.00 | $5.97 | $5.97 | $20.97 |  | robotdigg.com | Robot Digg - black anondize linear rail (http://robotdigg.com/product/1314/Black-anodized-linear-rail-7,-9,-12-and-15)
Motion | Linear Rail MGN9H 400mm | 6 | $26.90 | $161.40 | $0.00 |  | $161.40 |  | www.voronkit.com | Voron Kit Store - MGN9H (https://www.voronkit.com/products/mgn9h-linear-rail?variant=39772655845464) |  |  | www.voronkit.com | https://www.voronkit.com/products/voron-2-4-kit
Motion | Linear Rail MGN12H 400mm | 1 | $34.80 | $34.80 | $0.00 |  | $34.80 |  | www.voronkit.com | Printed Solid - MGN12H (https://www.printedsolid.com/products/ldo-linear-rail-mgn12h-with-one-carriage-in-300-400-500-700mm-lengths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) |  | Not available from the Voron Kit Store. | www.voronkit.com | https://www.voronkit.com/products/voron-2-4-kit
 |  |  | $0.00 | $0.00 | $0.00 |  | $0.00
 |  |  | $0.00 | $0.00 | $0.00 |  | $0.00
 |  |  | $0.00 | $0.00 | $0.00 |  | $0.00
 |  |  | $0.00 | $0.00 | $0.00 |  | $0.00
 |  |  | $0.00 | $0.00 | $0.00 |  | $0.00
 |  |  | $0.00 | $0.00 | $0.00 |  | $0.00
 |  |  | $0.00 | $0.00 | $0.00 |  | $0.00
Parts to find and add to our BOM w/ vendor info
Misc | Fume Extractor Carbon Filter Element | 1
Misc | Loctite Blue Threadlocker Stick | 1
Misc | Mobil EP1/2 Grease | 1
Misc | Single Sided Foam Tape 1mm Thick (5m) | 1
Misc | Single Sided Foam Tape 3mm Thick (5m) | 1
Misc | PTFE Tube (4mm OD 2mm ID) - 300mm | 1
Cables | Nylon Cable Ties, Small (.07-.10", 1.8-2.7mm wide) | 42
Cables | 18AWG Wire (10ft/3m total) | 1
Cables | 20AWG High-flex Wire (10ft/3m total) | 1
Cables | 22-24AWG High-flex Wire (min 19 strand)(250ft/76m total) | 1
Cables | Female Spade Crimp Terminal (18-22AWG, .250", 6.35mm) | 7
Cables | Fork Spade Crimp Terminal (18-22AWG, #10) | 5
Cables | Ring Crimp Terminal (16-22AWG, #6) | 1
Cables | JST XH Connector, 3 Position Male/Female Pair plus Pins | 1
Cables | Connector kit matching your controller choice (usually JST-XH) | 1
Cables | Crimp Ferrule Kit (covering sizes 24AWG to 18AWG) | 1
Cables | WAGO 221-415 Lever-Nuts | 3
Panels | Coroplast Sheet - 469x469x4 mm | 2
Panels | Coroplast Sheet - 483x503x4 mm | 1
Panels | Acrylic Sheet Clear - 241.5x503x3 mm | 2
Panels | Acrylic Sheet Clear - 483x503x3 mm | 2
Panels | Acrylic Sheet Clear - 483x483x3 mm | 1
Buildplate | MIC6 5/16" Plate - 14"x14" | 1
Buildplate | Adhesive Magnetic Sheet - 14"x14" | 1
Buildplate | Spring Steel Flexible Print Surface - 14"x14" | 1
Buildplate | Keenovo Silicone AC Heater w/ thermistor - 300x300mm (650W) | 1

Sheet: Voron2.4 350mm (orig - redo)
Category | Description | Qty | Unit Cost | Cost | Shipping | Shipping Const | Total Cost | Actual Cost | Vendor | Part URL | Order Status | Notes | Original BOM Vendor | Additional Info | Funding / Accounting Info | Accounting Tasking / Status
Fasteners | Fastner kit (350mm x 350mm x 350mm) | 1 | $56.99 | $56.99 | $0.00 |  | $56.99 | $56.99 | www.voronkit.com |  | Ordered |  | www.voronkit.com | https://www.voronkit.com/products/voron-2-4-kit | Voron Txn 2 (TWW-KF-VORON-2) TWW Kids fund (proj. voron): $510.57 on 10/24/2022 | TWW-KF-VORON-2 Paid via TWW business acct. Update Oct. Invoice
Fasteners | M3x10 FHCS | 4 | $0.00 | $0.00 | $0.00 |  | $0.00 |  |  |  |  | TODO: Not in the Kit. Verify if this is just another screw
Motion | Motion kit (350mm x 350mm x 350mm) | 1 | $129.90 | $129.90 | $0.00 |  | $129.90 | $129.90 | www.voronkit.com | Voron Kit Store - Motion Kit (https://www.voronkit.com/products/voron-v2-4-motion-kit) | Ordered |  | www.voronkit.com | https://www.voronkit.com/products/voron-2-4-kit | TWW-KF-VORON-2 | TWW-KF-VORON-2
Motion | LDO Linear Rail MGN9H 400mm; black anondized stainless steel GS_MGN9-1H-B400 | 6 | $15.00 | $90.00 | $35.85 | $5.97 | $125.85 | $125.85 | robotdigg.com | Robot Digg - black anondize linear rail (http://robotdigg.com/product/1314/Black-anodized-linear-rail-7,-9,-12-and-15) | Ordered |  |  |  | Voron Txn 1 (TWW-KF-VORON-1) TWW Kids fund (proj. voron): $146.82 on 10/24/2022 | TWW-KF-VORON-1 Pay Apple CC from TWW account
Motion | LDO Linear Rail MGN12H 400mm; black anondized stainless steel GS_MGN12-1H-B400 | 1 | $15.00 | $15.00 | $5.97 | $5.97 | $20.97 | $20.97 | robotdigg.com | Robot Digg - black anondize linear rail (http://robotdigg.com/product/1314/Black-anodized-linear-rail-7,-9,-12-and-15) | Ordered |  |  |  | TWW-KF-VORON-1 | TWW-KF-VORON-1
Frame | Frame kit (350mm x 350mm x 350mm) | 1 | $129.99 | $129.99 | $0.00 |  | $129.99 | $129.99 | www.voronkit.com | Voron Kit Store - Frame Kit (https://www.voronkit.com/products/voron-v2-4-frame-kit?variant=39755687493720) | Ordered |  | www.voronkit.com | https://www.voronkit.com/products/voron-2-4-kit | TWW-KF-VORON-2 | TWW-KF-VORON-2
Cables | Cable kit (350mm x 350mm x 350mm) | 1 | $56.99 | $56.99 | $0.00 |  | $56.99 |  | www.voronkit.com | Voron Kit Store - Cables Kit (https://www.voronkit.com/products/voron-v2-4-cables-kit) |  |  | www.voronkit.com | https://www.voronkit.com/products/voron-2-4-kit
Misc | Misc. Parts Kit | 1 | $65.99 | $65.99 | $0.00 |  | $65.99 | $65.99 | www.voronkit.com | Voron Kit Store - Misc Parts (https://www.voronkit.com/products/voron-v2-4-misc-parts) | Ordered | See contents of Misc Parts Kit | www.voronkit.com | https://www.voronkit.com/products/voron-2-4-kit | TWW-KF-VORON-2 | TWW-KF-VORON-2
Electronics | BTT Mini 12864 Screen | 2 | $13.90 | $27.80 | $0.00 |  | $27.80 | $27.80 | www.voronkit.com | Voron Kit Store - BTT Mini 12864 screen (https://www.voronkit.com/products/btt-mini-12864-screen) | Ordered | Actually bought 2 (1 x vonon + 1 x polyformer | www.voronkit.com | https://www.voronkit.com/products/voron-2-4-kit | TWW-KF-VORON-2 | TWW-KF-VORON-2
Electronics | BTT TMC 2209 v1.2 Stepper Motor Driver | 7 | $5.90 | $41.30 | $0.00 |  | $41.30 |  | www.voronkit.com | Voron Kit Store - BTT TMC 2209 v1.2 (https://www.voronkit.com/products/btt-tmc-2209-v12) |  |  | www.voronkit.com | https://www.voronkit.com/products/voron-2-4-kit
Electronics | Steppers Kits | 1 | $99.90 | $99.90 | $0.00 |  | $99.90 | $99.00 | www.voronkit.com | Voron Kit Store - Steppers Kit (https://www.voronkit.com/products/voron-v24-steppers-kit) | Ordered | NEMA17 Stepper Motor 17HS19-2004S NEMA17 Stepper Motor 17HS08-1004S | www.voronkit.com | https://www.voronkit.com/products/voron-2-4-kit | TWW-KF-VORON-2 | TWW-KF-VORON-2
Electronics | BTT Manta M8P Klipper Controller Board / 3D Printer Control System using CB1/CM4 | 1 | $54.99 | $54.99 | $0.00 |  | $54.99 |  | west3d.com | West3D - BTT Manta M8P control board (https://west3d.com/products/btt-manta-m8p-klipper-controller-board-3d-printer-control-system-using-cb1-cm4) |  | Eliminates need for an RPi. TODO: Is there a change to the power supply req?
Electronics | BTT CB1 Computing Core Board Adapter for Manta Controller Boards | 1 | $29.99 | $29.99 | $0.00 |  | $29.99 |  | west3d.com | West3D - BTT CB1 adapter (https://west3d.com/products/btt-cb1-adapter-for-manta-controller-boards) |  | Eliminates need for an RPi. TODO: Is there a change to the power supply req?
Electronics | Auto bed leveling sensor (high quality) - Omrn TL-Q5MC2-Z | 1 | $27.90 | $27.90 | $0.00 |  | $27.90 |  | www.voronkit.com | Voron Kit Store - OMRN TL-Q5MC2-Z (https://www.voronkit.com/products/omron-tl-q5mc2?pr_prod_strat=copurchase_transfer_learning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) |  | Proximity switch. Compat w/ Voron 2.2 and 2.4 | www.voronkit.com
Electronics | Mean Well LRS-200-24 PSU; 24v power supply | 1 | $32.90 | $32.90 | $0.00 |  | $32.90 |  | www.voronkit.com | Voron Kit Store - MeanWell LRS-200-24 (https://www.voronkit.com/products/meanwell-lrs-200-24) |  |  | www.voronkit.com | https://www.voronkit.com/products/voron-2-4-kit
Electronics | Mean Well RS-25-5 PSU; 5v power supply | 1 | $13.90 | $13.90 | $0.00 |  | $13.90 |  | www.voronkit.com | Voron Kit Store - MeanWell RS-25-5 (https://www.voronkit.com/products/meanwell-rs-25-5) |  |  | www.voronkit.com | https://www.voronkit.com/products/voron-2-4-kit
Electronics | OMRON G3NB-210B DC5-24 SSR . solid state relay | 1 | $22.90 | $22.90 | $0.00 |  | $22.90 |  | www.voronkit.com | Voron Kit Store - OMRON G3NB-210B (https://www.voronkit.com/products/omron-g3nb-210b-dc5-24-misumi) |  |  | www.voronkit.com | MiSUMi - G3NA-210B DC5-24 (https://us.misumi-ec.com/vona2/detail/222000863384/?HissuCode=G3NA-210B%20DC5-24)
Electronics | Omron D2F-01L Micro Switch | 3 | $0.00 | $0.00 | $0.00 |  | $0.00
Electronics | Inductive Probe (See sourcing guide) | 1 | $0.00 | $0.00 | $0.00 |  | $0.00 |  |  |  |  | TODO: Is this the same as the auto-bed leveling sensor? |  | https://www.digikey.com/en/products/detail/panasonic-industrial-automation-sales/GX-HL15B/3896951 https://www.digikey.com/en/products/detail/omron-automation-and-safety/tl-q5mc2/2669828 https://www.aliexpress.us/item/2251832663198775.html?gatewayAdapt=glo2usa&_randl_shipto=US
Electronics | Hotend Kit (24V) | 1 | $0.00 | $0.00 | $0.00 |  | $0.00 |  |  |  |  | Need to figure out which hotend to start with. The Cables Kit comes with some parts, but not going to use them.
 |  |  | $0.00 | $0.00 | $0.00 |  | $0.00
 |  |  | $0.00 | $0.00 | $0.00 |  | $0.00
Electronics | TycoElectronics 10EGG1-1 Filtered Power Inlet (NA/UK) | 1 | $0.00 | $0.00 | $0.00 |  | $0.00 |  |  |  |  | Part of Cables Kit but is for non-US, Inlet Power Socket IEC320 C14 (With 8A250V Fuse). TODO: Get the US compat part
Electronics | Medium Blow Fuse 5x20mm 8A (120v mains) | 1 | $0.00 | $0.00 | $0.00 |  | $0.00 |  |  |  |  | Part of Cables Kit but is for non-US, Inlet Power Socket IEC320 C14 (With 8A250V Fuse). TODO: Get the US compat part
Electronics | Keystone CAT6 Insert (Optional) | 1 | $0.00 | $0.00 | $0.00 |  | $0.00
 |  |  | $0.00 | $0.00 | $0.00 |  | $0.00
Electronics | USB Cable for selected controller (TODO: Do we need this) | 1 | $0.00 | $0.00 | $0.00 |  | $0.00 | $0.00 |  |  | Own | Does this come with the BTT Octopus Pro 1.0?
Cables | Nylon Cable Ties, Small (.07-.10", 1.8-2.7mm wide) | 42 | $0.00 | $0.00 | $0.00 |  | $0.00
 |  |  | $0.00 | $0.00 | $0.00 |  | $0.00
 |  |  | $0.00 | $0.00 | $0.00 |  | $0.00
 |  |  | $0.00 | $0.00 | $0.00 |  | $0.00
Cables | Female Spade Crimp Terminal (18-22AWG, .250", 6.35mm) | 7 | $0.00 | $0.00 | $0.00 |  | $0.00
Cables | Fork Spade Crimp Terminal (18-22AWG, #10) | 5 | $0.00 | $0.00 | $0.00 |  | $0.00
Cables | Ring Crimp Terminal (16-22AWG, #6) | 1 | $0.00 | $0.00 | $0.00 |  | $0.00
Cables | JST XH Connector, 3 Position Male/Female Pair plus Pins | 1 | $0.00 | $0.00 | $0.00 |  | $0.00
Cables | Connector kit matching your controller choice (usually JST-XH) | 1 | $0.00 | $0.00 | $0.00 |  | $0.00
Cables | Crimp Ferrule Kit (covering sizes 24AWG to 18AWG) | 1 | $0.00 | $0.00 | $0.00 |  | $0.00
Cables | WAGO 221-415 Lever-Nuts | 3 | $0.00 | $0.00 | $0.00 |  | $0.00
Cables | IGUS E2-15-10-028-0 Chain | 1 | $0.00 | $0.00 | $0.00 |  | $0.00 |  |  |  |  | Z Chain, (250 - 22 links) (300 - 25 links) (350 - 28 links)
Cables | IGUS E2-150-10-12PZ Chain Ends | 1 | $0.00 | $0.00 | $0.00 |  | $0.00 |  |  |  |  | Z Chain End link sets
Cables | IGUS E2i-10-10-018-0 Chain | 2 | $0.00 | $0.00 | $0.00 |  | $0.00 |  |  |  |  | X/Y Chain (250 - 16 links) (300 - 19 links) (350 - 21 links)
Cables | IGUS E2-100-10-12PZ Chain Ends | 2 | $0.00 | $0.00 | $0.00 |  | $0.00 |  |  |  |  | X/Y Chain End link sets
 |  |  | $0.00 | $0.00 | $0.00 |  | $0.00
 |  |  | $0.00 | $0.00 | $0.00 |  | $0.00 |  |  |  |  | Does this come with the BTT Octopus Pro 1.0?
 |  |  | $0.00 | $0.00 | $0.00 |  | $0.00
 |  |  | $0.00 | $0.00 | $0.00 |  | $0.00
 |  |  | $0.00 | $0.00 | $0.00 |  | $0.00
 |  |  | $0.00 | $0.00 | $0.00 |  | $0.00
 |  |  | $0.00 | $0.00 | $0.00 |  | $0.00
 |  |  | $0.00 | $0.00 | $0.00 |  | $0.00 |  |  |  |  | Does this come with the BTT Octopus Pro 1.0?
 |  |  | $0.00 | $0.00 | $0.00 |  | $0.00
 |  |  | $0.00 | $0.00 | $0.00 |  | $0.00
 |  |  | $0.00 | $0.00 | $0.00 |  | $0.00
 |  |  | $0.00 | $0.00 | $0.00 |  | $0.00
Fliament | Jet Black ASA (850g spool) - Primary color | 3 | $29.99 | $89.97 | $26.86 |  |  |  | Prusa3D (https://www.prusa3d.com/) | Prusament ASA (https://www.prusa3d.com/category/prusament-asa/) |  | Required qty: 2 x 1 kg spool |  | Purchased 1 spool; Jet Black ASA; printedsolid.com. (TODO: Check price)
Filament | Red ASA (850g spool) - Secondary color | 2 | $29.99 | $59.98 | $24.02 |  |  |  | Prusa3D (https://www.prusa3d.com/) | Prusament ASA (https://www.prusa3d.com/category/prusament-asa/) |  | Required qty: 1 x 1 kg spool |  | Purchased 1 spool; Lipstick Red ASA; printedsolid.com. (TODO: Check price)
 |  |  | $0.00 | $0.00 | $0.00 |  | $0.00
 |  |  | $0.00 | $0.00 | $0.00 |  | $0.00 |  |  |  |  | Does this come with the BTT Octopus Pro 1.0?
 |  |  | $0.00 | $0.00 | $0.00 |  | $0.00
 |  |  | $0.00 | $0.00 | $0.00 |  | $0.00
 |  |  | $0.00 | $0.00 | $0.00 |  | $0.00
 |  |  | $0.00 | $0.00 | $0.00 |  | $0.00
 |  |  | $0.00 | $0.00 | $0.00 |  | $0.00
 |  |  | $0.00 | $0.00 | $0.00 |  | $0.00 |  |  |  |  | Does this come with the BTT Octopus Pro 1.0?
 |  |  | $0.00 | $0.00 | $0.00 |  | $0.00
 |  |  | $0.00 | $0.00 | $0.00 |  | $0.00
 |  |  | $0.00 | $0.00 | $0.00 |  | $0.00
 |  |  | $0.00 | $0.00 | $0.00 |  | $0.00
 |  |  | $0.00 | $0.00 | $0.00 |  | $0.00
 |  |  |  |  |  |  |  | $656.49
Voron 2.4 Mods or alternative parts
Accessories | Logitech C270 HD Webcam w/ 3D printed mount | 1 | $34.99 | $34.99 | $0.00 |  | $34.99 |  | voronkits.com (https://voronkits.com/collections/voron-upgrades) | voronkits.com - Logitech C270 Webcam (https://voronkits.com/collections/voron-upgrades/products/logitech-c270-hd-webcam-with-3d-printed-mount-for-voron-2-4-trident-hd-720p-pc-mac-raspberry-pi)
Electronics | BTT Manta M8P Klipper Controller Board / 3D Printer Control System using CB1/CM4 | 1 | $54.99 | $54.99 | $0.00 |  | $54.99 |  | west3d.com | West3D - BTT Manta M8P control board (https://west3d.com/products/btt-manta-m8p-klipper-controller-board-3d-printer-control-system-using-cb1-cm4) |  | Eliminates need for an RPi. TODO: Is there a change to the power supply req?
Electronics | BTT CB1 Computing Core Board Adapter for Manta Controller Boards | 1 | $29.99 | $29.99 | $0.00 |  | $29.99 |  | west3d.com | West3D - BTT CB1 adapter (https://west3d.com/products/btt-cb1-adapter-for-manta-controller-boards) |  | Eliminates need for an RPi. TODO: Is there a change to the power supply req?
Electronics | BTT Octopus Pro F446 (180 Mhz ARM-Cortex-M4 CPU & 512 KB flash memory); Controller w/ 7 stepper outputs | 1 | $59.99 | $59.99 | $0.00 |  | $59.99 |  | www.voronkit.com | Voron Kit Store - BTT Octopus Pro (https://www.voronkit.com/products/btt-octopus-pro) |  | Octopus v1.0 Pro; DO NOT get the Octopus v1.1 | www.voronkit.com | Alt. control boards: SKR V1.4 Turbo Control Board
Electronics | RaspberryPi 4 w/ 4GB RAM Canakit. (RaspberryPi 3B+ or better) | 1 | $159.95 | $159.95 | $0.00 |  | $159.95 | $0.00 | www.canakit.com | Canakit - RPi4 4GB (https://www.canakit.com/raspberry-pi-4-4gb.html) | Own | No need to purchase necessary. already own.
Voron 2.4 Alternative part sources
Electronics | Auto bed leveling sensor (high quality) - Omrn TL-Q5MC2-Z | 1 | $21.99 | $21.99 | $0.00 |  | $21.99 |  | voronkits.com (https://voronkits.com/collections/voron-upgrades) | voronkits.com - OMRN TL-Q5MC2-Z (https://voronkits.com/collections/voron-upgrades/products/vorn2-4-auto-bed-leveling-sensor-omrn-tl-q5mc2-z-proximity-switch-3-wire-dc10-30v-shield-type-induct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) |  | Alt. source. | Maker Creatives - voronkits.com (https://voronkits.com/collections/voron-upgrades)
Motion | LDO Linear Rail MGN9H 400mm | 6 | $30.00 | $180.00 | $0.00 |  | $180.00 |  | printedsolid.com | Printed Solid - MGN9H (https://www.printedsolid.com/products/ldo-linear-rail-mgn9h-linear-rail-with-carriage-400mm-350mm-300mm-lengths) |  |  | www.printedsolid.com
Motion | LDO Linear Rail MGN9H 400mm; stainless steel | 6 | $35.94 | $215.64 | $0.00 |  | $215.64 |  | printedsolid.com | Printed Solid - MGN9H (stainless steel) (https://www.printedsolid.com/products/ldo-stainless-steel-linear-rail-mgn9h-with-carriage-400mm-350mm-300mm-lengths) |  | Alt. source and material | www.printedsolid.com
Motion | LDO Linear Rail MGN12H 400mm | 1 | $34.80 | $34.80 | $0.00 |  | $34.80 |  | printedsolid.com | Printed Solid - MGN12H (https://www.printedsolid.com/products/ldo-linear-rail-mgn12h-with-one-carriage-in-300-400-500-700mm-lengths) |  |  | www.printedsolid.com
Motion | LDO Linear Rail MGN9H 400mm; black anondized stainless steel GS_MGN9-1H-B400 | 6 | $15.00 | $90.00 | $35.85 | $5.97 | $125.85 |  | robotdigg.com | Robot Digg - black anondize linear rail (http://robotdigg.com/product/1314/Black-anodized-linear-rail-7,-9,-12-and-15)
Motion | LDO Linear Rail MGN12H 400mm; black anondized stainless steel GS_MGN12-1H-B400 | 1 | $15.00 | $15.00 | $5.97 | $5.97 | $20.97 |  | robotdigg.com | Robot Digg - black anondize linear rail (http://robotdigg.com/product/1314/Black-anodized-linear-rail-7,-9,-12-and-15)
Motion | Linear Rail MGN9H 400mm | 6 | $26.90 | $161.40 | $0.00 |  | $161.40 |  | www.voronkit.com | Voron Kit Store - MGN9H (https://www.voronkit.com/products/mgn9h-linear-rail?variant=39772655845464) |  |  | www.voronkit.com | https://www.voronkit.com/products/voron-2-4-kit
Motion | Linear Rail MGN12H 400mm | 1 | $34.80 | $34.80 | $0.00 |  | $34.80 |  | www.voronkit.com | Printed Solid - MGN12H (https://www.printedsolid.com/products/ldo-linear-rail-mgn12h-with-one-carriage-in-300-400-500-700mm-lengths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) |  | Not available from the Voron Kit Store. | www.voronkit.com | https://www.voronkit.com/products/voron-2-4-kit
 |  |  | $0.00 | $0.00 | $0.00 |  | $0.00
 |  |  | $0.00 | $0.00 | $0.00 |  | $0.00
 |  |  | $0.00 | $0.00 | $0.00 |  | $0.00
 |  |  | $0.00 | $0.00 | $0.00 |  | $0.00
 |  |  | $0.00 | $0.00 | $0.00 |  | $0.00
 |  |  | $0.00 | $0.00 | $0.00 |  | $0.00
 |  |  | $0.00 | $0.00 | $0.00 |  | $0.00
Parts to find and add to our BOM w/ vendor info
Misc | Fume Extractor Carbon Filter Element | 1
Misc | Loctite Blue Threadlocker Stick | 1
Misc | Mobil EP1/2 Grease | 1
Misc | Single Sided Foam Tape 1mm Thick (5m) | 1
Misc | Single Sided Foam Tape 3mm Thick (5m) | 1
Misc | PTFE Tube (4mm OD 2mm ID) - 300mm | 1
Cables | Nylon Cable Ties, Small (.07-.10", 1.8-2.7mm wide) | 42
Cables | 18AWG Wire (10ft/3m total) | 1
Cables | 20AWG High-flex Wire (10ft/3m total) | 1
Cables | 22-24AWG High-flex Wire (min 19 strand)(250ft/76m total) | 1
Cables | Female Spade Crimp Terminal (18-22AWG, .250", 6.35mm) | 7
Cables | Fork Spade Crimp Terminal (18-22AWG, #10) | 5
Cables | Ring Crimp Terminal (16-22AWG, #6) | 1
Cables | JST XH Connector, 3 Position Male/Female Pair plus Pins | 1
Cables | Connector kit matching your controller choice (usually JST-XH) | 1
Cables | Crimp Ferrule Kit (covering sizes 24AWG to 18AWG) | 1
Cables | WAGO 221-415 Lever-Nuts | 3
Panels | Coroplast Sheet - 469x469x4 mm | 2
Panels | Coroplast Sheet - 483x503x4 mm | 1
Panels | Acrylic Sheet Clear - 241.5x503x3 mm | 2
Panels | Acrylic Sheet Clear - 483x503x3 mm | 2
Panels | Acrylic Sheet Clear - 483x483x3 mm | 1
Buildplate | MIC6 5/16" Plate - 14"x14" | 1
Buildplate | Adhesive Magnetic Sheet - 14"x14" | 1
Buildplate | Spring Steel Flexible Print Surface - 14"x14" | 1
Buildplate | Keenovo Silicone AC Heater w/ thermistor - 300x300mm (650W) | 1

Sheet: Voron2.4 350 Checklist
Category | Description | Qty | Order Status | Voron 2.4 Kit | Info | Notes
Fasteners | M5x40 SHCS | 22 |  | Fastner Kit (https://www.voronkit.com/products/voron-v2-4-fasteners-kit-voron-3d-printer-project)
Fasteners | M5x30 BHCS | 22 |  | Fastner Kit (https://www.voronkit.com/products/voron-v2-4-fasteners-kit-voron-3d-printer-project)
Fasteners | M5x16 BHCS | 35 |  | Fastner Kit
Fasteners | M5x10 BHCS | 35 |  | Fastner Kit
Fasteners | M5 Hexnut | 16 |  | Fastner Kit (https://www.voronkit.com/products/voron-v2-4-fasteners-kit-voron-3d-printer-project)
Fasteners | M5 Post-install T-nut | 68 |  | Fastner Kit (https://www.voronkit.com/products/voron-v2-4-fasteners-kit-voron-3d-printer-project)
Fasteners | M5 1mm Shim | 42 |  | Fastner Kit (https://www.voronkit.com/products/voron-v2-4-fasteners-kit-voron-3d-printer-project)
Fasteners | M4x6 BHCS | 7 |  | Fastner Kit (https://www.voronkit.com/products/voron-v2-4-fasteners-kit-voron-3d-printer-project)
Fasteners | M4 Knurled Nut (DIN 466-B) | 4 |  | Fastner Kit (https://www.voronkit.com/products/voron-v2-4-fasteners-kit-voron-3d-printer-project)
Fasteners | M3x40 SHCS | 30 |  | Fastner Kit (https://www.voronkit.com/products/voron-v2-4-fasteners-kit-voron-3d-printer-project)
Fasteners | M3x30 SHCS | 25 |  | Fastner Kit (https://www.voronkit.com/products/voron-v2-4-fasteners-kit-voron-3d-printer-project)
Fasteners | M3x20 SHCS | 22 |  | Fastner Kit (https://www.voronkit.com/products/voron-v2-4-fasteners-kit-voron-3d-printer-project)
Fasteners | M3x16 SHCS | 20 |  | Fastner Kit (https://www.voronkit.com/products/voron-v2-4-fasteners-kit-voron-3d-printer-project)
Fasteners | M3x12 SHCS | 41 |  | Fastner Kit (https://www.voronkit.com/products/voron-v2-4-fasteners-kit-voron-3d-printer-project)
Fasteners | M3x10 FHCS | 4 |  |  | Not in kit | TODO: Not in the Kit. Verify if this is just another screw
Fasteners | M3x8 SHCS | 187 |  | Fastner Kit (https://www.voronkit.com/products/voron-v2-4-fasteners-kit-voron-3d-printer-project)
Fasteners | M3x6 BHCS | 11 |  | Fastner Kit (https://www.voronkit.com/products/voron-v2-4-fasteners-kit-voron-3d-printer-project)
Fasteners | M3x6 FHCS | 8 |  | Fastner Kit (https://www.voronkit.com/products/voron-v2-4-fasteners-kit-voron-3d-printer-project)
Fasteners | M3 Hexnut | 6 |  | Fastner Kit (https://www.voronkit.com/products/voron-v2-4-fasteners-kit-voron-3d-printer-project)
Fasteners | M3 Post-install T-nut | 103 |  | Fastner Kit (https://www.voronkit.com/products/voron-v2-4-fasteners-kit-voron-3d-printer-project)
Fasteners | M3 Hammer Head T-nuts | 60 |  | Fastner Kit (https://www.voronkit.com/products/voron-v2-4-fasteners-kit-voron-3d-printer-project)
Fasteners | M3 Washer | 3 |  | Fastner Kit (https://www.voronkit.com/products/voron-v2-4-fasteners-kit-voron-3d-printer-project)
Fasteners | M3 Threaded Insert | 110 |  | Fastner Kit (https://www.voronkit.com/products/voron-v2-4-fasteners-kit-voron-3d-printer-project)
Fasteners | M2x10 Self-tapping Screw | 16 |  | Fastner Kit (https://www.voronkit.com/products/voron-v2-4-fasteners-kit-voron-3d-printer-project)
Motion | GT2 80T Pulley (5mm ID 6mm W) | 4 |  | Motion kit (https://www.voronkit.com/products/voron-v2-4-motion-kit)
Motion | GT2 20T Pulley (5mm ID 6mm W) | 3 |  | Motion kit (https://www.voronkit.com/products/voron-v2-4-motion-kit)
Motion | GT2 20T Pulley (5mm ID 9mm W) | 4 |  | Motion kit
Motion | GT2 16T Pulley (5mm ID 6mm W) | 4 |  | Motion kit (https://www.voronkit.com/products/voron-v2-4-motion-kit)
Motion | GT2 20T Toothed Idler (5mm ID 6mm W) | 2 |  | Motion kit
Motion | GT2 20T Toothed Idler (5mm ID 9mm W) | 4 |  | Motion kit
Motion | F695 Bearing | 20 |  | Motion kit (https://www.voronkit.com/products/voron-v2-4-motion-kit)
Motion | 625 Bearing | 12 |  | Motion kit
Motion | 5x60mm Shaft (D Cut) - Grind Flat | 4 |  | Motion kit (https://www.voronkit.com/products/voron-v2-4-motion-kit)
Motion | 5x30mm Shaft (trim to size) | 1 |  | Motion kit
Motion | GT2 Belt Loop (6mm W) - 188mm | 4 |  | Motion kit (https://www.voronkit.com/products/voron-v2-4-motion-kit)
Motion | GT2 Open Belt LL-2GT-9 (9mm wide) - 1200mm | 4 |  | Motion kit (https://www.voronkit.com/products/voron-v2-4-motion-kit)
Motion | BMG Extruder Components Kit | 1 |  | Misc Parts kit (https://www.voronkit.com/products/voron-v2-4-misc-parts)
Motion | Linear Rail MGN9H 400mm | 6 |  | Voron Kit Store - MGN9H (https://www.voronkit.com/products/mgn9h-linear-rail?variant=39772655845464)
Motion | Linear Rail MGN12H 400mm | 1 |  | Printed Solid - MGN12H (https://www.printedsolid.com/products/ldo-linear-rail-mgn12h-with-one-carriage-in-300-400-500-700mm-lengths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)
Motion | GT2 Open Belt LL-2GT-6 (6mm wide) - 2000mm | 2 |  | Motion kit (https://www.voronkit.com/products/voron-v2-4-motion-kit)
Electronics | Omron D2F-01L Micro Switch | 3 |  | Cables Kit (https://www.voronkit.com/products/voron-v2-4-cables-kit)
Electronics | Inductive Probe (See sourcing guide) | 1 |  | Voron Kit Store - OMRN TL-Q5MC2-Z (https://www.voronkit.com/products/omron-tl-q5mc2?pr_prod_strat=copurchase_transfer_learning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)
Electronics | Hotend Kit (24V) | 1
Electronics | 40x40x20 Centrifugal Fan (24V) | 1 |  | Misc Parts kit (https://www.voronkit.com/products/voron-v2-4-misc-parts)
Electronics | 40x40x10 Axial Fan (24V) | 1 |  | Misc Parts kit (https://www.voronkit.com/products/voron-v2-4-misc-parts)
Electronics | Mini 12864 Display | 1 |  | Voron Kit Store - BTT Mini 12864 screen (https://www.voronkit.com/products/btt-mini-12864-screen)
Electronics | TycoElectronics 10EGG1-1 Filtered Power Inlet (NA/UK) | 1 |  |  |  | Part of Cables Kit but is for non-US, Inlet Power Socket IEC320 C14 (With 8A250V Fuse). TODO: Get the US compat part
Electronics | Medium Blow Fuse 5x20mm 8A (120v mains) | 1 |  |  |  | Part of Cables Kit but is for non-US, Inlet Power Socket IEC320 C14 (With 8A250V Fuse). TODO: Get the US compat part
Electronics | Keystone CAT6 Insert (Optional) | 1
Electronics | 60x60x20 Fan (24V) | 3 |  | Misc Parts kit (https://www.voronkit.com/products/voron-v2-4-misc-parts)
Electronics | Controller with 7+ Stepper outputs | 1 |  | Voron Kit Store - BTT Octopus Pro 1.0 (https://www.voronkit.com/products/btt-octopus-pro)
Electronics | TMC2209 Stepper Motor Driver | 7 |  | Voron Kit Store - BTT TMC 2209 v1.2 (https://www.voronkit.com/products/btt-tmc-2209-v12)
Electronics | USB Cable for selected controller | 1 | Own |  |  | TODO: Do we need?
Electronics | RaspberryPi 3B+ or better | 1 | Own | Canakit - RPi4 4GB (https://www.canakit.com/raspberry-pi-4-4gb.html) |  | Already own
Electronics | Mean Well LRS-200-24 PSU | 1 |  | Voron Kit Store - MeanWell LRS-200-24 (https://www.voronkit.com/products/meanwell-lrs-200-24)
Electronics | Mean Well RS-25-5 PSU | 1 |  | Voron Kit Store - MeanWell RS-25-5 (https://www.voronkit.com/products/meanwell-rs-25-5)
Electronics | Omron G3A-210B-DC5 SSR | 1 |  | Voron Kit Store - OMRON G3NB-210B (https://www.voronkit.com/products/omron-g3nb-210b-dc5-24-misumi)
Electronics | DIN Rail Mount Bracket for G3A SSR | 1 |  | Misc Parts kit (https://www.voronkit.com/products/voron-v2-4-misc-parts)
Electronics | BAT85 Diode | 1 |  | Cables Kit (https://www.voronkit.com/products/voron-v2-4-cables-kit)
Electronics | C13 Power Cord | 1 | Own | Cables Kit (https://www.voronkit.com/products/voron-v2-4-cables-kit) |  | TODO: Is it in the cables kit? Already own one
Electronics | Thermal Fuse (125C) | 1 |  | Cables Kit (https://www.voronkit.com/products/voron-v2-4-cables-kit) |  | 120C Thermal Fuse in the cables kit. Should we get the recommended 125C?
Electronics | NEMA17 Motor 17HS19-2004S | 6 |  | Steppers Kit (https://www.voronkit.com/products/voron-v24-steppers-kit)
Electronics | NEMA17 Motor 17HS08-1004S | 1 |  | Steppers Kit (https://www.voronkit.com/products/voron-v24-steppers-kit)
Vibration Management | Rubber Foot (1.5x.75", 38x19mm) | 4 |  | Misc Parts kit (https://www.voronkit.com/products/voron-v2-4-misc-parts)
Frame | OpenBuilds Billet Angle Corner Connector (2020) | 4 |  | Frame Kit (https://www.voronkit.com/products/voron-v2-4-frame-kit?variant=39755687493720)
Frame | Misumi HFSB5-2020-340 | 1 |  | Frame Kit (https://www.voronkit.com/products/voron-v2-4-frame-kit?variant=39755687493720)
Frame | DIN 3 Rails (35mm W) - 465mm | 2 |  | Frame Kit
Frame | Misumi HFSB5-2020-430 | 1 |  | Frame Kit (https://www.voronkit.com/products/voron-v2-4-frame-kit?variant=39755687493720)
Frame | Misumi HFSB5-2020-450 | 2 |  | Frame Kit
Frame | Misumi HFSB5-2020-470-TPW | 10 |  | Frame Kit
Frame | Misumi HFSB5-2020-530-LCP-RCP | 4 |  | Frame Kit
Frame | Voron 2.4 frame kit (350mm x 350mm x 350mm) | 0 |  | Frame Kit (https://www.voronkit.com/products/voron-v2-4-frame-kit?variant=39755687493720) |  | Frame kit. TODO: Remove if all the contents of the Voron Kit Store - Frame Kit checkout
Misc | Fume Extractor Carbon Filter Element | 1
Misc | 4mm Threaded Bowden Coupler | 1 |  | Misc Parts kit (https://www.voronkit.com/products/voron-v2-4-misc-parts) |  | PC4-01 in Misc Parts kit
Misc | 3M VHB Tape 5952 | 1 |  | Misc Parts kit (https://www.voronkit.com/products/voron-v2-4-misc-parts)
Misc | Loctite Blue Threadlocker Stick | 1 | Own |  |  | Already own
Misc | Mobil EP1/2 Grease | 1
Misc | Single Sided Foam Tape 1mm Thick (5m) | 1
Misc | Single Sided Foam Tape 3mm Thick (5m) | 1
Misc | 6x3mm Neodimium Magnet | 8 |  | Misc Parts kit (https://www.voronkit.com/products/voron-v2-4-misc-parts)
Misc | PTFE Tube (4mm OD 3mm ID) - 1000mm | 1 |  | Misc Parts kit (https://www.voronkit.com/products/voron-v2-4-misc-parts)
Misc | PTFE Tube (4mm OD 2mm ID) - 300mm | 1 |  |  |  | Not in kit. TODO: Verify after getting Misc Parts
Cables | Nylon Cable Ties, Small (.07-.10", 1.8-2.7mm wide) | 42
Cables | 18AWG Wire (10ft/3m total) | 1 |  | Cables Kit (https://www.voronkit.com/products/voron-v2-4-cables-kit) |  | 16 AWG in Cables kit; consider getting the 18 AWG. see https://www.amazon.com/gp/product/B01LH1G2IE/
Cables | 20AWG High-flex Wire (10ft/3m total) | 1 |  | Cables Kit (https://www.voronkit.com/products/voron-v2-4-cables-kit) |  | Alt. source: see https://www.amazon.com/gp/product/B01LH1G2IE/
Cables | 22-24AWG High-flex Wire (min 19 strand)(250ft/76m total) | 1 |  | Cables Kit (https://www.voronkit.com/products/voron-v2-4-cables-kit) |  | Alt. source: see https://www.amazon.com/gp/product/B01LH1G2IE/
Cables | Female Spade Crimp Terminal (18-22AWG, .250", 6.35mm) | 7 |  | Cables Kit (https://www.voronkit.com/products/voron-v2-4-cables-kit) |  | Insulated crimp receptical in Cables Kit. TODO: Verify
Cables | Fork Spade Crimp Terminal (18-22AWG, #10) | 5 |  | Cables Kit (https://www.voronkit.com/products/voron-v2-4-cables-kit) |  | Fork crimp terminal in Cables Kit. TODO: Verify
Cables | Ring Crimp Terminal (16-22AWG, #6) | 1
Cables | JST XH Connector, 3 Position Male/Female Pair plus Pins | 1 |  |  |  | XH2.54 Kit in the Cables Kit
Cables | Connector kit matching your controller choice (usually JST-XH) | 1 |  | Cables Kit (https://www.voronkit.com/products/voron-v2-4-cables-kit) |  | XH2.54 Kit in the Cables Kit
Cables | Crimp Ferrule Kit (covering sizes 24AWG to 18AWG) | 1 |  |  |  | TODO: Check sourcing. TODO: Do I have?
Cables | MicroFit3 Connector Plug 4 Position | 4 |  | Cables Kit (https://www.voronkit.com/products/voron-v2-4-cables-kit)
Cables | MicroFit3 Connector Plug 3 Position | 1 |  | Cables Kit (https://www.voronkit.com/products/voron-v2-4-cables-kit)
Cables | MicroFit3 Connector Plug 2 Position | 2 |  | Cables Kit
Cables | MicroFit3 Connector Receptacle 4 Position | 4 |  | Cables Kit
Cables | MicroFit3 Connector Receptacle 3 Position | 1 |  | Cables Kit
Cables | MicroFit3 Connector Receptacle 2 Position | 2 |  | Cables Kit
Cables | MLX Power Receptacle 3 Position (bed wiring) | 1 |  | Cables Kit
Cables | MLX Power Plug 3 Position | 1 |  | Cables Kit
Cables | MLX Male Pin | 6 |  | Cables Kit
Cables | MLX Female Pin | 6 |  | Cables Kit
Cables | MicroFit3 Female Pin | 40 |  | Cables Kit
Cables | MicroFit3 Male Pin | 40 |  | Cables Kit
Cables | WAGO 221-415 Lever-Nuts | 3
Cables | VORON XY ZipChain (printed a/b link pairs) | 24 |  | Misc Parts kit (https://www.voronkit.com/products/voron-v2-4-misc-parts) |  | Generic cable chain in kit. TODO: Update to use the IGUS E2xxxx chains. See BOM
Cables | VORON Z ZipChain (printed a/b link pairs) | 14 |  | Misc Parts kit (https://www.voronkit.com/products/voron-v2-4-misc-parts) |  | Generic cable chain in kit. TODO: Update to use the IGUS E2xxxx chains. See BOM
Cables | VORON XY ZipChain (printed ends) | 4 |  | Misc Parts kit (https://www.voronkit.com/products/voron-v2-4-misc-parts) |  | Generic cable chain in kit. TODO: Update to use the IGUS E2xxxx chains. See BOM
Cables | VORON Z ZipChain (printed ends) | 2 |  | Misc Parts kit (https://www.voronkit.com/products/voron-v2-4-misc-parts) |  | Generic cable chain in kit. TODO: Update to use the IGUS E2xxxx chains. See BOM
Cables | IGUS E2-15-10-028-0 Chain | 1 |  |  |  | Z Chain, (250 - 22 links) (300 - 25 links) (350 - 28 links) *adjust travel distance untill desired number of links is shown*
Cables | IGUS E2-150-10-12PZ Chain Ends | 1 |  |  |  | Z Chain End link sets
Cables | IGUS E2i-10-10-018-0 Chain | 2 |  |  |  | X/Y Chain (250 - 16 links) (300 - 19 links) (350 - 21 links) *adjust travel distance untill desired number of links is shown*
Cables | IGUS E2-100-10-12PZ Chain Ends | 2 |  |  |  | X/Y Chain End link sets
Panels | Coroplast Sheet - 469x469x4 mm | 2
Panels | Coroplast Sheet - 483x503x4 mm | 1
Panels | Acrylic Sheet Clear - 241.5x503x3 mm | 2
Panels | Acrylic Sheet Clear - 483x503x3 mm | 2
Panels | Acrylic Sheet Clear - 483x483x3 mm | 1

Sheet: voron2.4_350mm_bom
Category | Description | Qty | Unit Cost | Cost | Shipping | Total Cost | Actual Cost | Vendor | Part URL | Order Status | Notes | Original BOM Vendor | Additional Info
Fasteners | M5x40 SHCS | 22 | $0.00 | $0.00
Fasteners | M5x30 BHCS | 22
Fasteners | M5x16 BHCS | 35
Fasteners | M5x10 BHCS | 35
Fasteners | M5 Hexnut | 16
Fasteners | M5 Post-install T-nut | 68
Fasteners | M5 1mm Shim | 42
Fasteners | M4x6 BHCS | 7
Fasteners | M4 Knurled Nut (DIN 466-B) | 4
Fasteners | M3x40 SHCS | 30
Fasteners | M3x30 SHCS | 25
Fasteners | M3x20 SHCS | 22
Fasteners | M3x16 SHCS | 20
Fasteners | M3x12 SHCS | 41
Fasteners | M3x10 FHCS | 4
Fasteners | M3x8 SHCS | 187
Fasteners | M3x6 BHCS | 11
Fasteners | M3x6 FHCS | 8
Fasteners | M3 Hexnut | 6
Fasteners | M3 Post-install T-nut | 103
Fasteners | M3 Hammer Head T-nuts | 60
Fasteners | M3 Washer | 3
Fasteners | M3 Threaded Insert | 110
Fasteners | M2x10 Self-tapping Screw | 16
Motion | GT2 80T Pulley (5mm ID 6mm W) | 4
Motion | GT2 20T Pulley (5mm ID 6mm W) | 3
Motion | GT2 20T Pulley (5mm ID 9mm W) | 4
Motion | GT2 16T Pulley (5mm ID 6mm W) | 4
Motion | GT2 20T Toothed Idler (5mm ID 6mm W) | 2
Motion | GT2 20T Toothed Idler (5mm ID 9mm W) | 4
Motion | F695 Bearing | 20
Motion | 625 Bearing | 12
Motion | √ò5x60mm Shaft (D Cut) | 4
Motion | √ò5x35mm Shaft (trim to size) | 1
Motion | GT2 Belt Loop (6mm W) - 188mm | 4
Motion | GT2 Open Belt LL-2GT-9 (9mm wide) - 1200mm | 4
Motion | BMG Extruder Components Kit | 1
Motion | Linear Rail MGN9H 400mm | 6
Motion | Linear Rail MGN12H 400mm | 1
Motion | GT2 Open Belt LL-2GT-6 (6mm wide) - 2000mm | 2
Electronics | Omron D2F-01L Micro Switch | 3
Electronics | Inductive Probe (See sourcing guide) | 1
Electronics | Hotend Kit (24V) | 1
Electronics | 40x40x20 Centrifugal Fan (24V) | 1
Electronics | 40x40x10 Axial Fan (24V) | 1
Electronics | Mini 12864 Display | 1
Electronics | TycoElectronics 10EGG1-1 Filtered Power Inlet (NA/UK) | 1
Electronics | TycoElectronics 10EGG1-2 Filtered Power Inlet (EU) | 1
Electronics | Medium Blow Fuse 5x20mm 4A (220V mains) | 2
Electronics | Medium Blow Fuse 5x20mm 8A (120v mains) | 1
Electronics | Keystone CAT6 Insert (Optional) | 1
Electronics | 60x60x20 Fan (24V) | 3
Electronics | Controller with 7+ Stepper outputs | 1
Electronics | TMC2209 Stepper Motor Driver | 7
Electronics | USB Cable for selected controller | 1
Electronics | RaspberryPi 3B+ or better | 1
Electronics | Mean Well LRS-200-24 PSU | 1
Electronics | Mean Well RS-25-5 PSU | 1
Electronics | Omron G3A-210B-DC5 SSR | 1
Electronics | DIN Rail Mount Bracket for G3A SSR | 1
Electronics | BAT85 Diode | 1
Electronics | C13 Power Cord | 1
Electronics | Thermal Fuse (125C) | 1
Electronics | NEMA17 Motor 17HS19-2004S | 6
Electronics | NEMA17 Motor 17HS08-1004S | 1
Vibration Management | Rubber Foot (1.5x.75", 38x19mm) | 4
Frame | OpenBuilds Billet Angle Corner Connector (2020) | 4 |  |  |  |  |  | FermioLabs (Premium) (https://fermio.xyz/en/voron-design/voron2/frames/&sa=D&source=editors&ust=1659621277714488&usg=AOvVaw3Ix34gAu-x518leOIp7u_F) |  |  |  | FermioLabs (Premium) (https://fermio.xyz/en/voron-design/voron2/frames/&sa=D&source=editors&ust=1659621277714488&usg=AOvVaw3Ix34gAu-x518leOIp7u_F)
Frame | Misumi HFSB5-2020-340 | 1 |  |  |  |  |  | FermioLabs (Premium) |  |  |  | FermioLabs (Premium)
Frame | DIN 3 Rails (35mm W) - 465mm | 2 |  |  |  |  |  | FermioLabs (Premium) |  |  |  | FermioLabs (Premium)
Frame | Misumi HFSB5-2020-430 | 1 |  |  |  |  |  | FermioLabs (Premium) (https://fermio.xyz/en/voron-design/voron2/frames/&sa=D&source=editors&ust=1659621277714488&usg=AOvVaw3Ix34gAu-x518leOIp7u_F) |  |  |  | FermioLabs (Premium) (https://fermio.xyz/en/voron-design/voron2/frames/&sa=D&source=editors&ust=1659621277714488&usg=AOvVaw3Ix34gAu-x518leOIp7u_F)
Frame | Misumi HFSB5-2020-450 | 2 |  |  |  |  |  | FermioLabs (Premium) (https://fermio.xyz/en/voron-design/voron2/frames/&sa=D&source=editors&ust=1659621277714488&usg=AOvVaw3Ix34gAu-x518leOIp7u_F) |  |  |  | FermioLabs (Premium) (https://fermio.xyz/en/voron-design/voron2/frames/&sa=D&source=editors&ust=1659621277714488&usg=AOvVaw3Ix34gAu-x518leOIp7u_F)
Frame | Misumi HFSB5-2020-470-TPW | 10 |  |  |  |  |  | FermioLabs (Premium) |  |  |  | FermioLabs (Premium)
Frame | Misumi HFSB5-2020-530-LCP-RCP | 4 |  |  |  |  |  | FermioLabs (Premium) |  |  |  | FermioLabs (Premium)
Frame | Voron 2.4 frame kit (350mm x 350mm x 350mm) | 1 |  |  |  |  |  | Printed Solid (https://www.printedsolid.com/) | LDO Voron 2.4 Frame Kit (https://www.printedsolid.com/products/ldo-voron-2-4-frame-kit?variant=39294478745685)
Misc | Fume Extractor Carbon Filter Element | 1
Misc | 4mm Threaded Bowden Coupler | 1
Misc | 3M VHB Tape 5952 | 1
Misc | Loctite Blue Threadlocker Stick | 1
Misc | Mobil EP1/2 Grease | 1
Misc | Single Sided Foam Tape 1mm Thick (5m) | 1
Misc | Single Sided Foam Tape 3mm Thick (5m) | 1
Misc | √ò6x3mm Neodimium Magnet | 8
Misc | PTFE Tube (4mm OD 3mm ID) - 1000mm | 1
Misc | PTFE Tube (4mm OD 2mm ID) - 300mm | 1
Cables | Nylon Cable Ties, Small (.07-.10", 1.8-2.7mm wide) | 42
Cables | 18AWG Wire (10ft/3m total) | 1
Cables | 20AWG High-flex Wire (10ft/3m total) | 1
Cables | 22-24AWG High-flex Wire (min 19 strand)(250ft/76m total) | 1
Cables | Female Spade Crimp Terminal (18-22AWG, .250", 6.35mm) | 7
Cables | Fork Spade Crimp Terminal (18-22AWG, #10) | 5
Cables | Ring Crimp Terminal (16-22AWG, #6) | 1
Cables | JST XH Connector, 3 Position Male/Female Pair plus Pins | 1
Cables | Connector kit matching your controller choice (usually JST-XH) | 1
Cables | Crimp Ferrule Kit (covering sizes 24AWG to 18AWG) | 1
Cables | MicroFit3 Connector Plug 4 Position | 4
Cables | MicroFit3 Connector Plug 3 Position | 1
Cables | MicroFit3 Connector Plug 2 Position | 2
Cables | MicroFit3 Connector Receptacle 4 Position | 4
Cables | MicroFit3 Connector Receptacle 3 Position | 1
Cables | MicroFit3 Connector Receptacle 2 Position | 2
Cables | MLX Power Receptacle 3 Position (bed wiring) | 1
Cables | MLX Power Plug 3 Position | 1
Cables | MLX Male Pin | 6
Cables | MLX Female Pin | 6
Cables | MicroFit3 Female Pin | 40
Cables | MicroFit3 Male Pin | 40
Cables | WAGO 221-415 Lever-Nuts | 3
Cables | VORON XY ZipChain (printed a/b link pairs) | 24
Cables | VORON Z ZipChain (printed a/b link pairs) | 14
Cables | VORON XY ZipChain (printed ends) | 4
Cables | VORON Z ZipChain (printed ends) | 2
Panels | Coroplast Sheet - 469x469x4 mm | 2
Panels | Coroplast Sheet - 483x503x4 mm | 1
Panels | Acrylic Sheet Clear - 241.5x503x3 mm | 2
Panels | Acrylic Sheet Clear - 483x503x3 mm | 2
Panels | Acrylic Sheet Clear - 483x483x3 mm | 1
Buildplate | MIC6 5/16" Plate - 14"x14" | 1
Buildplate | Adhesive Magnetic Sheet - 14"x14" | 1
Buildplate | Spring Steel Flexible Print Surface - 14"x14" | 1
Buildplate | Keenovo Silicone AC Heater w/ thermistor - 300x300mm (650W) | 1
Fliament | Jet Black ASA (850g spool) - Primary color | 3 | $29.99 | $89.97 | $26.86 |  |  | Prusa3D (https://www.prusa3d.com/) | Prusament ASA (https://www.prusa3d.com/category/prusament-asa/) |  | Required qty: 2 x 1 kg spool |  | Purchased 1 spool; Jet Black ASA; printedsolid.com. (TODO: Check price)
Filament | Red ASA (850g spool) - Secondary color | 2 | $29.99 | $59.98 | $24.02 |  |  | Prusa3D (https://www.prusa3d.com/) | Prusament ASA (https://www.prusa3d.com/category/prusament-asa/) |  | Required qty: 1 x 1 kg spool |  | Purchased 1 spool; Lipstick Red ASA; printedsolid.com. (TODO: Check price)

Sheet: Multi_build_BOM
Category | Description | Qty | Unit Cost | Cost | Shipping | Total Cost | Actual Cost | Vendor | Part URL | Order Status | Notes | Custom Variables
Fasteners | M5x40 SHCS | 44 | $0.00 | $0.00 |  |  |  | 0 |  |  |  | # of printers | 2
Fasteners | M5x30 BHCS | 44 | $0.00 | $0.00 |  |  |  | 0 |  |  |  | NY Sales tax (Oswego) | 4.00%
Fasteners | M5x16 BHCS | 70 | $0.00 | $0.00 |  |  |  | 0
Fasteners | M5x10 BHCS | 70 | $0.00 | $0.00 |  |  |  | 0
Fasteners | M5 Hexnut | 32 | $0.00 | $0.00 |  |  |  | 0
Fasteners | M5 Post-install T-nut | 136 | $0.00 | $0.00 |  |  |  | 0
Fasteners | M5 1mm Shim | 84 | $0.00 | $0.00 |  |  |  | 0
Fasteners | M4x6 BHCS | 14 | $0.00 | $0.00 |  |  |  | 0
Fasteners | M4 Knurled Nut (DIN 466-B) | 8 | $0.00 | $0.00 |  |  |  | 0
Fasteners | M3x40 SHCS | 60 | $0.00 | $0.00 |  |  |  | 0
Fasteners | M3x30 SHCS | 50 | $0.00 | $0.00 |  |  |  | 0
Fasteners | M3x20 SHCS | 44 | $0.00 | $0.00 |  |  |  | 0
Fasteners | M3x16 SHCS | 40 | $0.00 | $0.00 |  |  |  | 0
Fasteners | M3x12 SHCS | 82 | $0.00 | $0.00 |  |  |  | 0
Fasteners | M3x10 FHCS | 8 | $0.00 | $0.00 |  |  |  | 0
Fasteners | M3x8 SHCS | 374 | $0.00 | $0.00 |  |  |  | 0
Fasteners | M3x6 BHCS | 22 | $0.00 | $0.00 |  |  |  | 0
Fasteners | M3x6 FHCS | 16 | $0.00 | $0.00 |  |  |  | 0
Fasteners | M3 Hexnut | 12 | $0.00 | $0.00 |  |  |  | 0
Fasteners | M3 Post-install T-nut | 206 | $0.00 | $0.00 |  |  |  | 0
Fasteners | M3 Hammer Head T-nuts | 120 | $0.00 | $0.00 |  |  |  | 0
Fasteners | M3 Washer | 6 | $0.00 | $0.00 |  |  |  | 0
Fasteners | M3 Threaded Insert | 220 | $0.00 | $0.00 |  |  |  | 0
Fasteners | M2x10 Self-tapping Screw | 32 | $0.00 | $0.00 |  |  |  | 0
Motion | GT2 80T Pulley (5mm ID 6mm W) | 8 | $0.00 | $0.00 |  |  |  | 0
Motion | GT2 20T Pulley (5mm ID 6mm W) | 6 | $0.00 | $0.00 |  |  |  | 0
Motion | GT2 20T Pulley (5mm ID 9mm W) | 8 | $0.00 | $0.00 |  |  |  | 0
Motion | GT2 16T Pulley (5mm ID 6mm W) | 8 | $0.00 | $0.00 |  |  |  | 0
Motion | GT2 20T Toothed Idler (5mm ID 6mm W) | 4 | $0.00 | $0.00 |  |  |  | 0
Motion | GT2 20T Toothed Idler (5mm ID 9mm W) | 8 | $0.00 | $0.00 |  |  |  | 0
Motion | F695 Bearing | 40 | $0.00 | $0.00 |  |  |  | 0
Motion | 625 Bearing | 24 | $0.00 | $0.00 |  |  |  | 0
Motion | √ò5x60mm Shaft (D Cut) | 8 | $0.00 | $0.00 |  |  |  | 0
Motion | √ò5x35mm Shaft (trim to size) | 2 | $0.00 | $0.00 |  |  |  | 0
Motion | GT2 Belt Loop (6mm W) - 188mm | 8 | $0.00 | $0.00 |  |  |  | 0
Motion | GT2 Open Belt LL-2GT-9 (9mm wide) - 1200mm | 8 | $0.00 | $0.00 |  |  |  | 0
Motion | BMG Extruder Components Kit | 2 | $0.00 | $0.00 |  |  |  | 0
Motion | Linear Rail MGN9H 400mm | 12 | $0.00 | $0.00 |  |  |  | 0
Motion | Linear Rail MGN12H 400mm | 2 | $0.00 | $0.00 |  |  |  | 0
Motion | GT2 Open Belt LL-2GT-6 (6mm wide) - 2000mm | 4 | $0.00 | $0.00 |  |  |  | 0
Electronics | Omron D2F-01L Micro Switch | 6 | $0.00 | $0.00 |  |  |  | 0
Electronics | Inductive Probe (See sourcing guide) | 2 | $0.00 | $0.00 |  |  |  | 0
Electronics | Hotend Kit (24V) | 2 | $0.00 | $0.00 |  |  |  | 0
Electronics | 40x40x20 Centrifugal Fan (24V) | 2 | $0.00 | $0.00 |  |  |  | 0
Electronics | 40x40x10 Axial Fan (24V) | 2 | $0.00 | $0.00 |  |  |  | 0
Electronics | Mini 12864 Display | 2 | $0.00 | $0.00 |  |  |  | 0
Electronics | TycoElectronics 10EGG1-1 Filtered Power Inlet (NA/UK) | 2 | $0.00 | $0.00 |  |  |  | 0
Electronics | TycoElectronics 10EGG1-2 Filtered Power Inlet (EU) | 2 | $0.00 | $0.00 |  |  |  | 0
Electronics | Medium Blow Fuse 5x20mm 4A (220V mains) | 4 | $0.00 | $0.00 |  |  |  | 0
Electronics | Medium Blow Fuse 5x20mm 8A (120v mains) | 2 | $0.00 | $0.00 |  |  |  | 0
Electronics | Keystone CAT6 Insert (Optional) | 2 | $0.00 | $0.00 |  |  |  | 0
Electronics | 60x60x20 Fan (24V) | 6 | $0.00 | $0.00 |  |  |  | 0
Electronics | Controller with 7+ Stepper outputs | 2 | $0.00 | $0.00 |  |  |  | 0
Electronics | TMC2209 Stepper Motor Driver | 14 | $0.00 | $0.00 |  |  |  | 0
Electronics | USB Cable for selected controller | 2 | $0.00 | $0.00 |  |  |  | 0
Electronics | RaspberryPi 3B+ or better | 2 | $0.00 | $0.00 |  |  |  | 0
Electronics | Mean Well LRS-200-24 PSU | 2 | $0.00 | $0.00 |  |  |  | 0
Electronics | Mean Well RS-25-5 PSU | 2 | $0.00 | $0.00 |  |  |  | 0
Electronics | Omron G3A-210B-DC5 SSR | 2 | $0.00 | $0.00 |  |  |  | 0
Electronics | DIN Rail Mount Bracket for G3A SSR | 2 | $0.00 | $0.00 |  |  |  | 0
Electronics | BAT85 Diode | 2 | $0.00 | $0.00 |  |  |  | 0
Electronics | C13 Power Cord | 2 | $0.00 | $0.00 |  |  |  | 0
Electronics | Thermal Fuse (125C) | 2 | $0.00 | $0.00 |  |  |  | 0
Electronics | NEMA17 Motor 17HS19-2004S | 12 | $0.00 | $0.00 |  |  |  | 0
Electronics | NEMA17 Motor 17HS08-1004S | 2 | $0.00 | $0.00 |  |  |  | 0
Vibration Management | Rubber Foot (1.5x.75", 38x19mm) | 8 | $0.00 | $0.00 |  |  |  | 0
Frame | OpenBuilds Billet Angle Corner Connector (2020) | 8 | $0.00 | $0.00 |  |  |  | FermioLabs (Premium)
Frame | Misumi HFSB5-2020-340 | 2 | $0.00 | $0.00 |  |  |  | FermioLabs (Premium)
Frame | DIN 3 Rails (35mm W) - 465mm | 4 | $0.00 | $0.00 |  |  |  | FermioLabs (Premium)
Frame | Misumi HFSB5-2020-430 | 2 | $0.00 | $0.00 |  |  |  | FermioLabs (Premium)
Frame | Misumi HFSB5-2020-450 | 4 | $0.00 | $0.00 |  |  |  | FermioLabs (Premium)
Frame | Misumi HFSB5-2020-470-TPW | 20 | $0.00 | $0.00 |  |  |  | FermioLabs (Premium)
Frame | Misumi HFSB5-2020-530-LCP-RCP | 8 | $0.00 | $0.00 |  |  |  | FermioLabs (Premium)
Frame | Voron 2.4 frame kit (350mm x 350mm x 350mm) | 2 | $0.00 | $0.00 |  |  |  | Printed Solid
Misc | Fume Extractor Carbon Filter Element | 2 | $0.00 | $0.00 |  |  |  | 0
Misc | 4mm Threaded Bowden Coupler | 2 | $0.00 | $0.00 |  |  |  | 0
Misc | 3M VHB Tape 5952 | 2 | $0.00 | $0.00 |  |  |  | 0
Misc | Loctite Blue Threadlocker Stick | 2 | $0.00 | $0.00 |  |  |  | 0
Misc | Mobil EP1/2 Grease | 2 | $0.00 | $0.00 |  |  |  | 0
Misc | Single Sided Foam Tape 1mm Thick (5m) | 2 | $0.00 | $0.00 |  |  |  | 0
Misc | Single Sided Foam Tape 3mm Thick (5m) | 2 | $0.00 | $0.00 |  |  |  | 0
Misc | √ò6x3mm Neodimium Magnet | 16 | $0.00 | $0.00 |  |  |  | 0
Misc | PTFE Tube (4mm OD 3mm ID) - 1000mm | 2 | $0.00 | $0.00 |  |  |  | 0
Misc | PTFE Tube (4mm OD 2mm ID) - 300mm | 2 | $0.00 | $0.00 |  |  |  | 0
Cables | Nylon Cable Ties, Small (.07-.10", 1.8-2.7mm wide) | 84 | $0.00 | $0.00 |  |  |  | 0
Cables | 18AWG Wire (10ft/3m total) | 2 | $0.00 | $0.00 |  |  |  | 0
Cables | 20AWG High-flex Wire (10ft/3m total) | 2 | $0.00 | $0.00 |  |  |  | 0
Cables | 22-24AWG High-flex Wire (min 19 strand)(250ft/76m total) | 2 | $0.00 | $0.00 |  |  |  | 0
Cables | Female Spade Crimp Terminal (18-22AWG, .250", 6.35mm) | 14 | $0.00 | $0.00 |  |  |  | 0
Cables | Fork Spade Crimp Terminal (18-22AWG, #10) | 10 | $0.00 | $0.00 |  |  |  | 0
Cables | Ring Crimp Terminal (16-22AWG, #6) | 2 | $0.00 | $0.00 |  |  |  | 0
Cables | JST XH Connector, 3 Position Male/Female Pair plus Pins | 2 | $0.00 | $0.00 |  |  |  | 0
Cables | Connector kit matching your controller choice (usually JST-XH) | 2 | $0.00 | $0.00 |  |  |  | 0
Cables | Crimp Ferrule Kit (covering sizes 24AWG to 18AWG) | 2 | $0.00 | $0.00 |  |  |  | 0
Cables | MicroFit3 Connector Plug 4 Position | 8 | $0.00 | $0.00 |  |  |  | 0
Cables | MicroFit3 Connector Plug 3 Position | 2 | $0.00 | $0.00 |  |  |  | 0
Cables | MicroFit3 Connector Plug 2 Position | 4 | $0.00 | $0.00 |  |  |  | 0
Cables | MicroFit3 Connector Receptacle 4 Position | 8 | $0.00 | $0.00 |  |  |  | 0
Cables | MicroFit3 Connector Receptacle 3 Position | 2 | $0.00 | $0.00 |  |  |  | 0
Cables | MicroFit3 Connector Receptacle 2 Position | 4 | $0.00 | $0.00 |  |  |  | 0
Cables | MLX Power Receptacle 3 Position (bed wiring) | 2 | $0.00 | $0.00 |  |  |  | 0
Cables | MLX Power Plug 3 Position | 2 | $0.00 | $0.00 |  |  |  | 0
Cables | MLX Male Pin | 12 | $0.00 | $0.00 |  |  |  | 0
Cables | MLX Female Pin | 12 | $0.00 | $0.00 |  |  |  | 0
Cables | MicroFit3 Female Pin | 80 | $0.00 | $0.00 |  |  |  | 0
Cables | MicroFit3 Male Pin | 80 | $0.00 | $0.00 |  |  |  | 0
Cables | WAGO 221-415 Lever-Nuts | 6 | $0.00 | $0.00 |  |  |  | 0
Cables | VORON XY ZipChain (printed a/b link pairs) | 48 | $0.00 | $0.00 |  |  |  | 0
Cables | VORON Z ZipChain (printed a/b link pairs) | 28 | $0.00 | $0.00 |  |  |  | 0
Cables | VORON XY ZipChain (printed ends) | 8 | $0.00 | $0.00 |  |  |  | 0
Cables | VORON Z ZipChain (printed ends) | 4 | $0.00 | $0.00 |  |  |  | 0
Panels | Coroplast Sheet - 469x469x4 mm | 4 | $0.00 | $0.00 |  |  |  | 0
Panels | Coroplast Sheet - 483x503x4 mm | 2 | $0.00 | $0.00 |  |  |  | 0
Panels | Acrylic Sheet Clear - 241.5x503x3 mm | 4 | $0.00 | $0.00 |  |  |  | 0
Panels | Acrylic Sheet Clear - 483x503x3 mm | 4 | $0.00 | $0.00 |  |  |  | 0
Panels | Acrylic Sheet Clear - 483x483x3 mm | 2 | $0.00 | $0.00 |  |  |  | 0
Buildplate | MIC6 5/16" Plate - 14"x14" | 2 | $0.00 | $0.00 |  |  |  | 0
Buildplate | Adhesive Magnetic Sheet - 14"x14" | 2 | $0.00 | $0.00 |  |  |  | 0
Buildplate | Spring Steel Flexible Print Surface - 14"x14" | 2 | $0.00 | $0.00 |  |  |  | 0
Buildplate | Keenovo Silicone AC Heater w/ thermistor - 300x300mm (650W) | 2 | $0.00 | $0.00 |  |  |  | 0
Fliament | Jet Black ASA (850g spool) - Primary color | 6 | $29.99 | $89.97 |  |  |  | Prusa3D
Filament | Red ASA (850g spool) - Secondary color | 4 | $29.99 | $59.98 |  |  |  | Prusa3D

Sheet: Frame Parts - Raw
Frame Components - unfinished / full-size
Voron Part(s) | Part | Qty | Unit Cost | Net Cost | Total Cost | Actual Cost | Vendor | URL | Notes
Misumi HFSB5-2020-430 (1) Misumi HFSB5-2020-450 (2) | HFS5 Series 20mm x 20mm - Length: 4000 mm; 13.12 ft) - Black anondized (HFSB5) - four side slotes |  |  | $0.00 |  |  | MiSUMi | KHFSB5-2020-4000 (https://us.misumi-ec.com/vona2/detail/110302683830/?Tab=wysiwyg_area_0)
Misumi HFSB5-2020-450
Misumi HFSB5-2020-470-TPW
Misumi HFSB5-2020-530-LCP-RCP

Sheet: Nevermore V5 Duo BOM - Raw
Part | Quantity | Cost per unit | Kit Cost | Vendor | Purchase? | Part URL | Notes
5015 24v Dual Ball Blower | 2 | $8.00 |  | DFH (https://dfh.fm/) | Yes | https://dfh.fm/products/5015-24v-dual-ball-blower?variant=39612699738281
Nevermore Printer Carbon | 1 | $13.50 |  | DFH | Yes | https://dfh.fm/products/nevermore-printer-carbon?variant=42292685209822
Neodymium Magnet 6x3 Round - 10 Pack | 1 | $1.69 |  | DFH | Yes | https://dfh.fm/products/neodymium-magnet-6x3-round?variant=40397500940457 | Min. quantity: 8
M3x4 BHCS | 1 |  |  |  | No |  | Do not need. Enough on-hand
M3X6 BHCS | 2 |  |  |  | No |  | Do not need. Enough on-hand
M3x12 SHCS | 2 | $0.12 |  | Bolt Depot (http://boltdepot.com/) | Yes | Metric socket cap, Class 12.9 alloy steel black oxide finish, 3mm x 0.5mm x 12mm (https://www.boltdepot.com/Product-Details.aspx?product=13637) | Purchase qty: 8
M3X16 BHCS | 4 |  |  |  | No |  | Do not need. Enough on-hand
M3X18 BHCS | 1 |  |  |  | No |  | Do not need. Enough on-hand
2 PIN JST header | 1 |  |  |  | No |  | Do not need. Enough on-hand
Threaded Heat Insert Nut x 100 (M3x5x4) | 1 | $8.00 |  | DFH | No | https://dfh.fm/products/threaded-heat-insert-nut?variant=39650196816041 | Do not need. Enough on-hand. Min. quantity: 5
2020 M3 T-nuts; roll-in spring loaded (100-pack) | 1 | $16.68 |  | Amazon | No | https://www.amazon.com/100-Pack-Aluminum-Extrusions-Profile-Accessories/dp/B08YNFGYNH | May not need if enough left over from the voron build. Min. quantity: 2
Mods for Voron 2.4R2 w/ Mandala Roseworks (MRW) kinematic mounts
M5x8 SHCS | 1 | $0.11 |  | Bolt Depot (http://boltdepot.com/) | Yes | Metric socket cap, Class 12.9 alloy steel black oxide finish, 5mm x 0.8mm x 8mm Socket head screw (https://www.boltdepot.com/Product-Details.aspx?product=65183) | Purchase qty: 8
M5x40mm Binding Screw | 1 |  | $9.19 | Amazon | Yes | Amazon - Binding Screw (https://www.amazon.com/dp/B0B5RBWM3Y?th=1) | LBY 100pcs Phillips Chicago Screws Binding Screw Posts,M5 x 10/20/30/40/50mm Book Screws,Binding Barrels and Screws Assortment Kit, for Leather Saddles Purses Belt Repair, Nickel Plated (Black)
5x7x8 Sleeve Bearing | 3 |  | $6.99 | Amazon | Yes | Amazon - Sleeve Bearing (https://www.amazon.com/dp/B07JLVRYKT) | uxcell Sleeve Bearing 5mm Bore x 7mm OD x 8mm Length Plain Bearings Wrapped Oilless Bushings 10pcs
M3x30 SHCS | 2 | $0.20 |  | Bolt Depot (http://boltdepot.com/) | Yes | Metric socket cap, Class 12.9 alloy steel black oxide finish, 3mm x 0.5mm x 30mm (https://www.boltdepot.com/Product-Details.aspx?product=13641) | Purchase qty: 12
Z endstop PCB | 1 |  |  |  | No | Formosissima - Z endstop PCB (https://deepfriedhero.in/products/z-endstop-pcb-for-voron-v2-4) | Do not need. Part of the sexbolt kit
M2x8 Self Tapping | 4 |  |  |  | No | Amazon - M2x8 SHCS Self Tapping (https://www.amazon.com/dp/B00YBMRAH4) | Do not need. Part of the sexbolt kit
M3x5x4 Heatset Insert | 2 |  |  |  | No |  | Do not need. Enough on-hand
Extras
M3x30 SHCS | 8 | $0.13 |  | Bolt Depot (http://boltdepot.com/) | Yes | Metric socket cap, Stainless steel 18-8 (A-2), 3mm x 0.5mm x 30mm (https://www.boltdepot.com/Product-Details.aspx?product=6385) | Actually for the polyformer
 |  |  |  |  |  | M3x12 SHCS; Class 12.9 alloy steel black oxide finish (https://www.boltdepot.com/Product-Details.aspx?product=13637) | 8 | 0.12
 |  |  |  |  |  | M5x8 SHCS; Class 12.9 alloy steel black oxide finish (https://www.boltdepot.com/Product-Details.aspx?product=65183) | 8 | 0.11
 |  |  |  |  |  | M3x30 SHCS; Class 12.9 alloy steel black oxide finish (https://www.boltdepot.com/Product-Details.aspx?product=13641) | 12 | 0.2
 |  |  |  |  |  | M3x30 SHCS; Stainless steel 18-8 (A-2) (https://www.boltdepot.com/Product-Details.aspx?product=6385) | 8 | 0.13
 |  |  |  |  |  | LBY 100pcs Binding Screw kit,M5 x 10/20/30/40/50mm; Nickel Plated (Black) (https://www.amazon.com/dp/B0B5RBWM3Y?th=1) | 1 | 9.19
 |  |  |  |  |  | uxcell 10pcs Sleeve Bearing 5x7x8mm (https://www.amazon.com/dp/B07JLVRYKT) | 1 | 6.99
 |  |  |  |  |  | 5015 24v Dual Ball Blower (https://dfh.fm/products/5015-24v-dual-ball-blower?variant=39612699738281) | 2 | 8
 |  |  |  |  |  | Nevermore Printer Carbon (https://dfh.fm/products/nevermore-printer-carbon?variant=42292685209822) | 1 | 13.5
 |  |  |  |  |  | Neodymium Magnet 6x3 Round - 10 Pack (https://dfh.fm/products/neodymium-magnet-6x3-round?variant=40397500940457) | 1 | 1.69
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
