cee-wals/Voron-2/custom/3mf/success/z_drive_main_b_x2.3mf

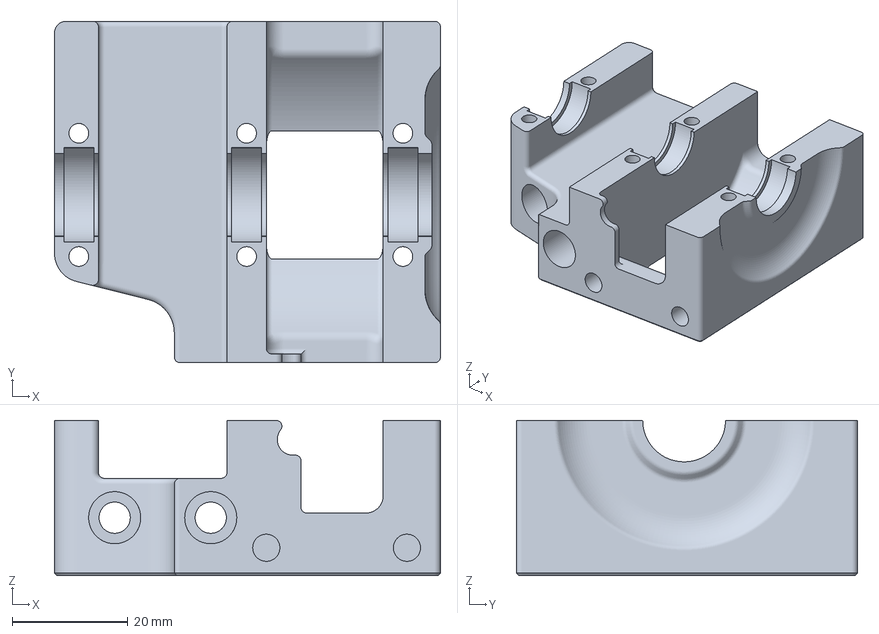
[picture p23: CAD file, 2022-12-21]
custom/3mf/success/z_drive_main_b_x2.3mf
66.7 x 59.0 x 26.8 mm
