cee-wals/Voron-2/custom/mods/vz-nocturne-usb-cam-mount-model_files/back-plate-main.stl

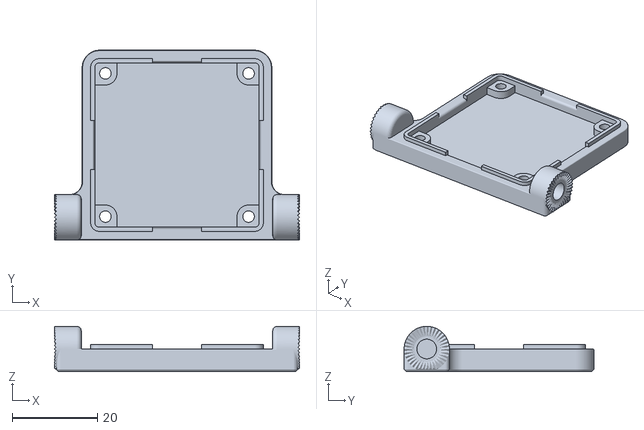
[picture p25: CAD file, 2026-08-27]
custom/mods/vz-nocturne-usb-cam-mount-model_files/back-plate-main.stl
57.3 x 44.4 x 10.6
