cee-wals/Voron-2/CAD/mods/Manta-M8P_Bracket.step

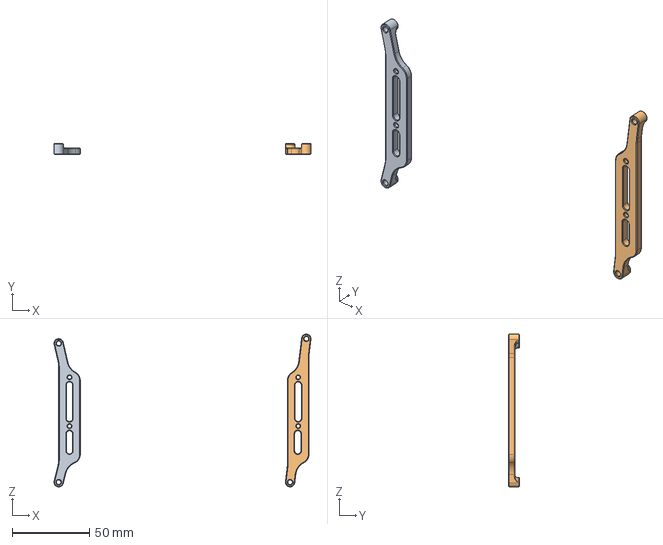
[picture p26: CAD file, 2022-12-12]
CAD/mods/Manta-M8P_Bracket.step
166.6 x 7.00 x 99.1 mm
