cee-wals/Voron-2/custom/3mf/in-progress/filter/exhaust_filter_housing.3mf

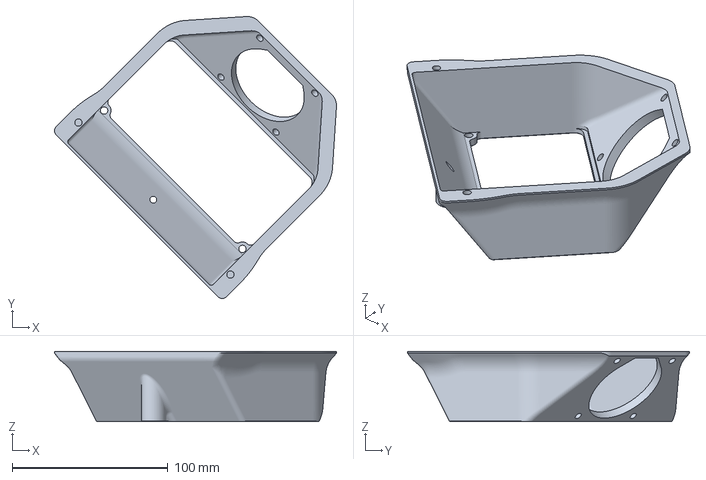
[picture p27: CAD file, 2023-01-05]
custom/3mf/in-progress/filter/exhaust_filter_housing.3mf
181.3 x 181.3 x 45.0 mm
