cee-wals/Voron-2/custom/3mf/in-progress/panel/bottom_panel_hinge_x2.3mf

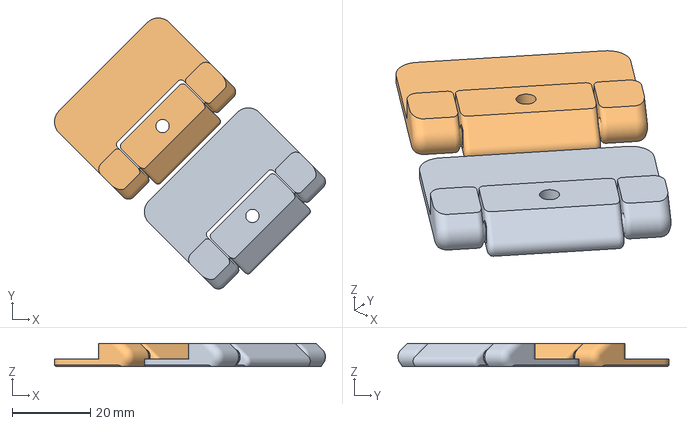
[picture p28: CAD file, 2023-01-05]
custom/3mf/in-progress/panel/bottom_panel_hinge_x2.3mf
69.4 x 69.4 x 6.00 mm
