cee-wals/Voron-2/custom/3mf/in-progress/skirt/front_skirt_a_350.3mf

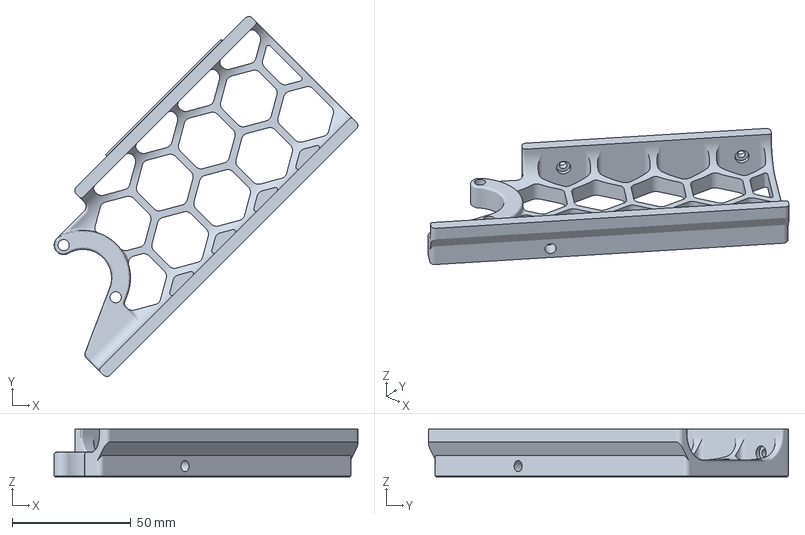
[picture p29: CAD file, 2022-12-27]
custom/3mf/in-progress/skirt/front_skirt_a_350.3mf
127.8 x 151.4 x 20.0 mm
