cee-wals/Voron-2/custom/3mf/in-progress/spool-management/bowden_retainer.3mf

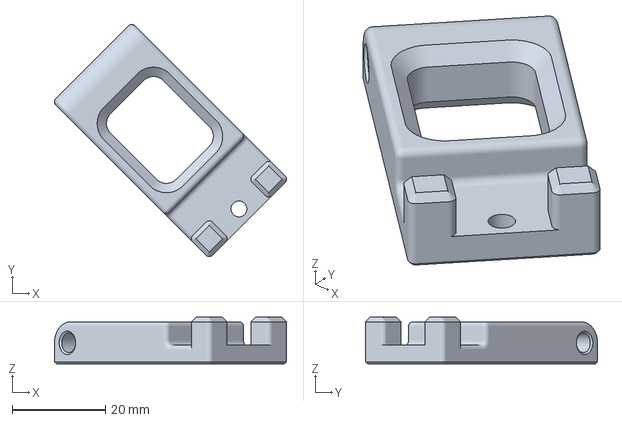
[picture p30: CAD file, 2023-01-05]
custom/3mf/in-progress/spool-management/bowden_retainer.3mf
49.7 x 49.7 x 10.00 mm
