cee-wals/Voron-2/custom/3mf/mods/Angry_CAM_USB/[a]Angry_CAM_Front_120.3mf

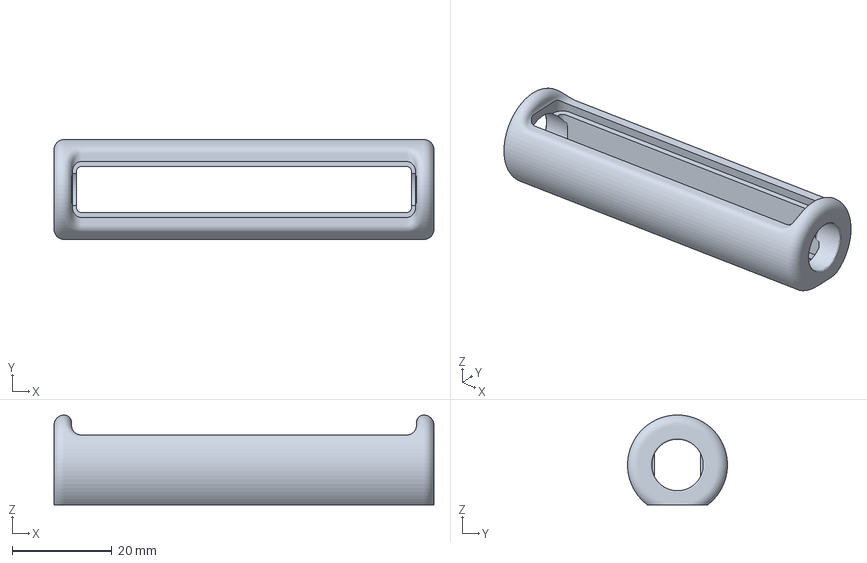
[picture p31: CAD file, 2023-02-24]
custom/3mf/mods/Angry_CAM_USB/[a]Angry_CAM_Front_120.3mf
76.0 x 20.0 x 18.0 mm
