cee-wals/Voron-2/custom/3mf/mods/BTT_Sensor_Mount_A_B.3mf

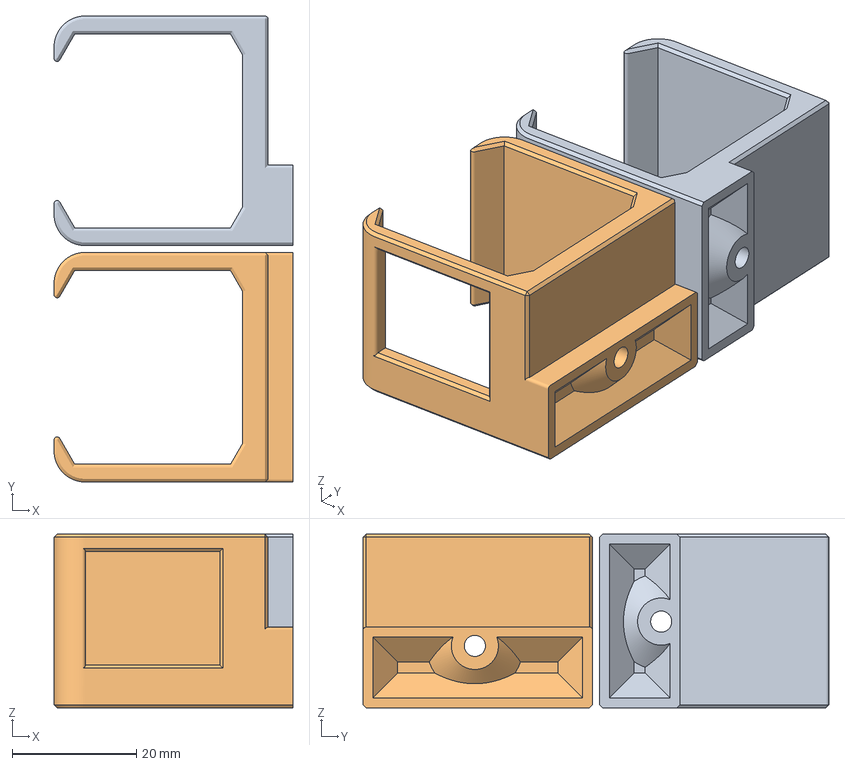
[picture p32: CAD file, 2023-02-24]
custom/3mf/mods/BTT_Sensor_Mount_A_B.3mf
38.5 x 75.1 x 28.0 mm
BTT_Sensor_Mount_A.stl
BTT_Sensor_Mount_B.stl
