cee-wals/Voron-2/custom/3mf/mods/RemovableDoors/RemovableDoors_Hinge_x4.3mf

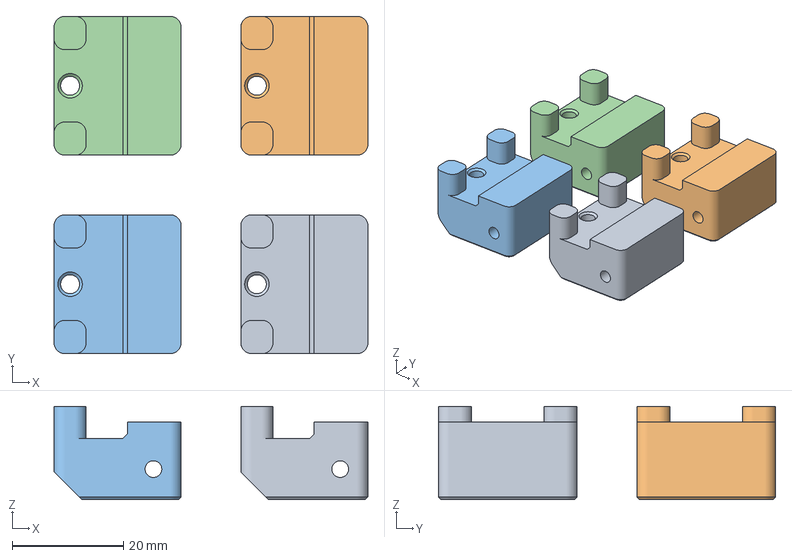
[picture p34: CAD file, 2026-08-27]
custom/3mf/mods/RemovableDoors/RemovableDoors_Hinge_x4.3mf
56.5 x 60.7 x 16.8 mm
