cee-wals/Voron-2/custom/3mf/mods/V2.4_handle/handle_inner_part.3mf

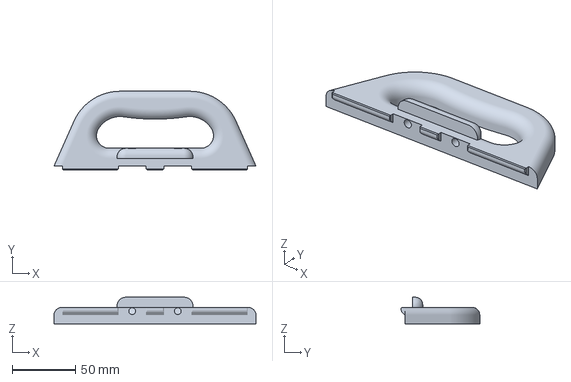
[picture p35: CAD file, 2023-02-24]
custom/3mf/mods/V2.4_handle/handle_inner_part.3mf
159.5 x 62.0 x 21.0 mm
