cee-wals/Voron-2/custom/3mf/reprint/[a]_skirts_keystone_blank_insert.3mf

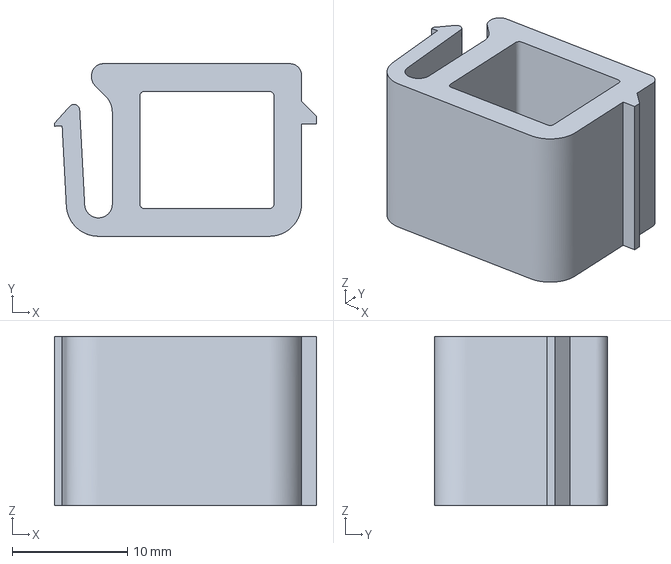
[picture p36: CAD file, 2022-12-12]
custom/3mf/reprint/[a]_skirts_keystone_blank_insert.3mf
22.8 x 15.0 x 14.7 mm
