cee-wals/Voron-2/custom/3mf/success/cable_routing_z_belt_cover_a_b_mod.3mf

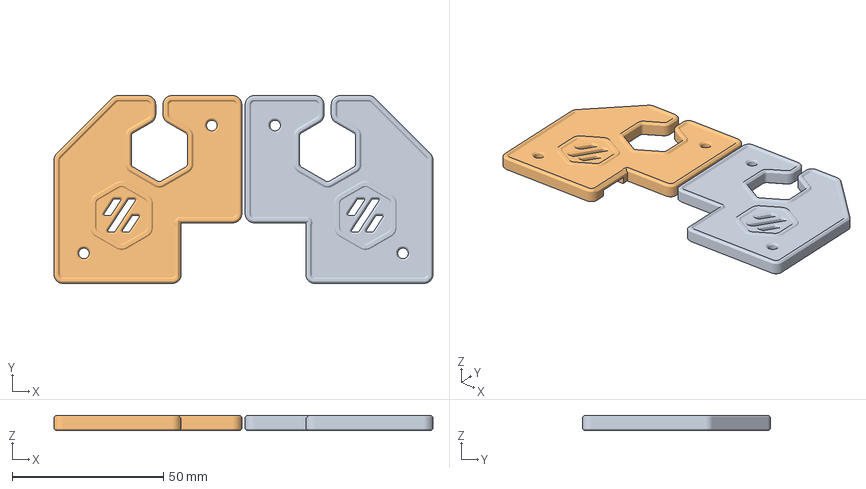
[picture p37: CAD file, 2023-02-24]
custom/3mf/success/cable_routing_z_belt_cover_a_b_mod.3mf
125.1 x 62.0 x 5.00 mm
cable_routing_z_belt_cover_a_mod.stl
cable_routing_z_belt_cover_b_mod.stl
