cee-wals/Voron-2/custom/3mf/success/RockNRoll/rocker_left.3mf

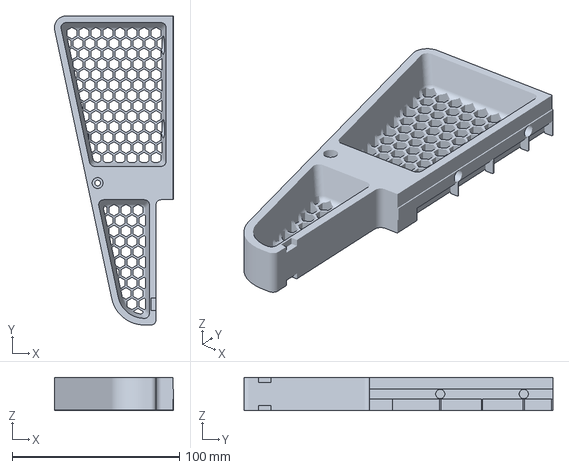
[picture p38: CAD file, 2023-02-24]
custom/3mf/success/RockNRoll/rocker_left.3mf
71.4 x 185.0 x 20.0 mm
