cee-wals/Voron-2/custom/mods/2020-extrusion-clip-for-decoration-or-cable-management/2020 Internal Clip.stl

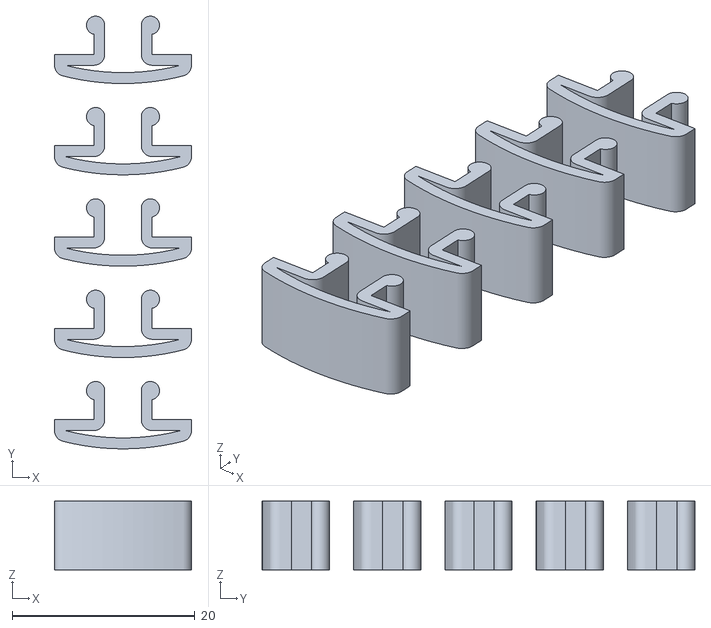
[picture p39: CAD file, 2023-02-24]
custom/mods/2020-extrusion-clip-for-decoration-or-cable-management/2020 Internal Clip.stl
15.0 x 47.4 x 7.50
