cee-wals/Voron-2/custom/mods/20x20mm_Profile_Covers /CAD/2020_Stealth_Profile_Cover.step

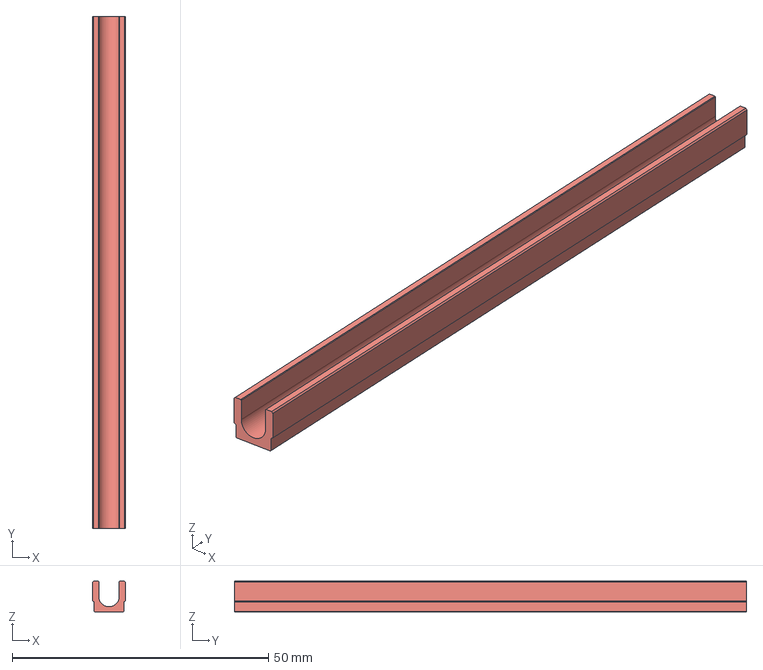
[picture p40: CAD file, 2023-02-24]
custom/mods/20x20mm_Profile_Covers /CAD/2020_Stealth_Profile_Cover.step
6.40 x 100.0 x 5.99 mm
