cee-wals/Voron-2/custom/mods/20x20mm_Profile_Covers /STL/2020_Profile_and_stealth_Cover.3mf

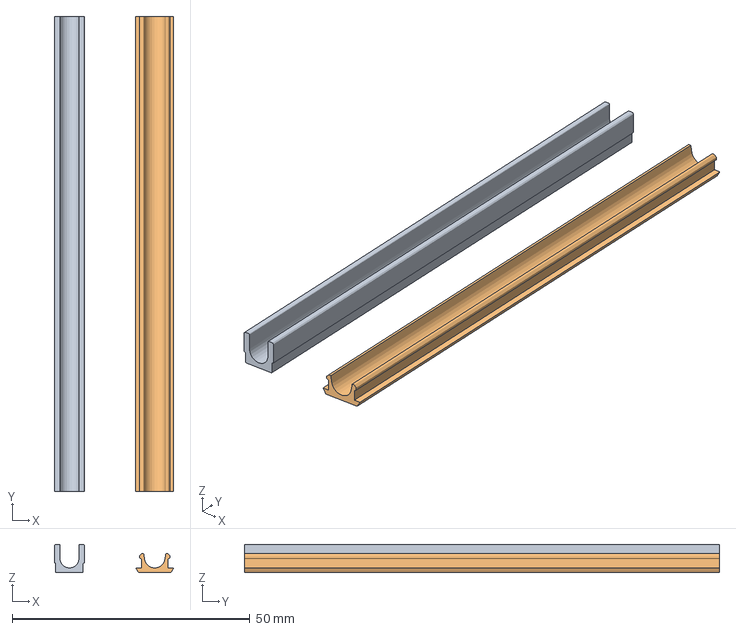
[picture p41: CAD file, 2026-08-27]
custom/mods/20x20mm_Profile_Covers /STL/2020_Profile_and_stealth_Cover.3mf
25.2 x 100.0 x 5.99 mm
2020_Stealth_Profile_Cover.stl
2020_Profile_Cover.stl
