cee-wals/Voron-2/custom/mods/Angry_CAM_USB /CAD/Angry_CAM_Front_Mount.step

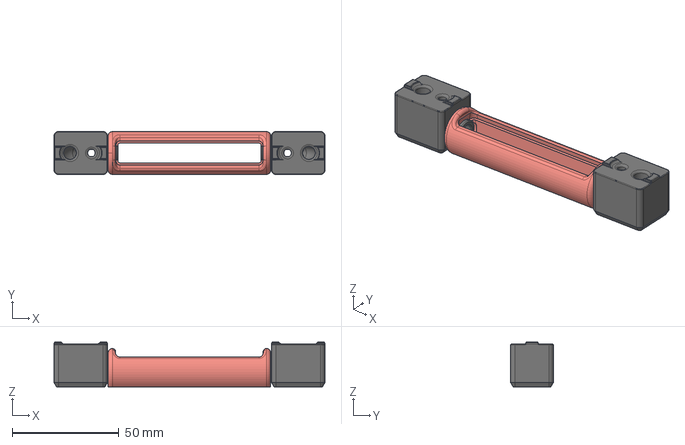
[picture p42: CAD file, 2023-02-24]
custom/mods/Angry_CAM_USB /CAD/Angry_CAM_Front_Mount.step
126.7 x 20.0 x 21.0 mm
