cee-wals/Voron-2/custom/mods/CableGator-Cable-Comb /STLs/Voron-CableGator-Lower-Jaw.stl

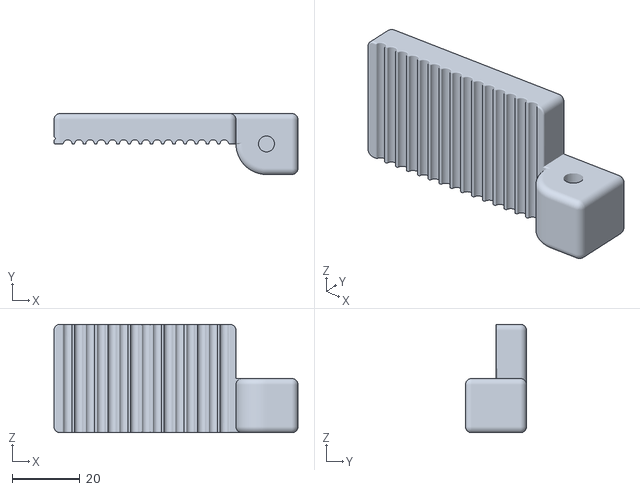
[picture p43: CAD file, 2023-02-24]
custom/mods/CableGator-Cable-Comb /STLs/Voron-CableGator-Lower-Jaw.stl
72.0 x 18.0 x 32.0
