cee-wals/Voron-2/custom/mods/Clip-On_Front_Door_Frame /STEPs/Voron_Panel_Trim_250mm.step

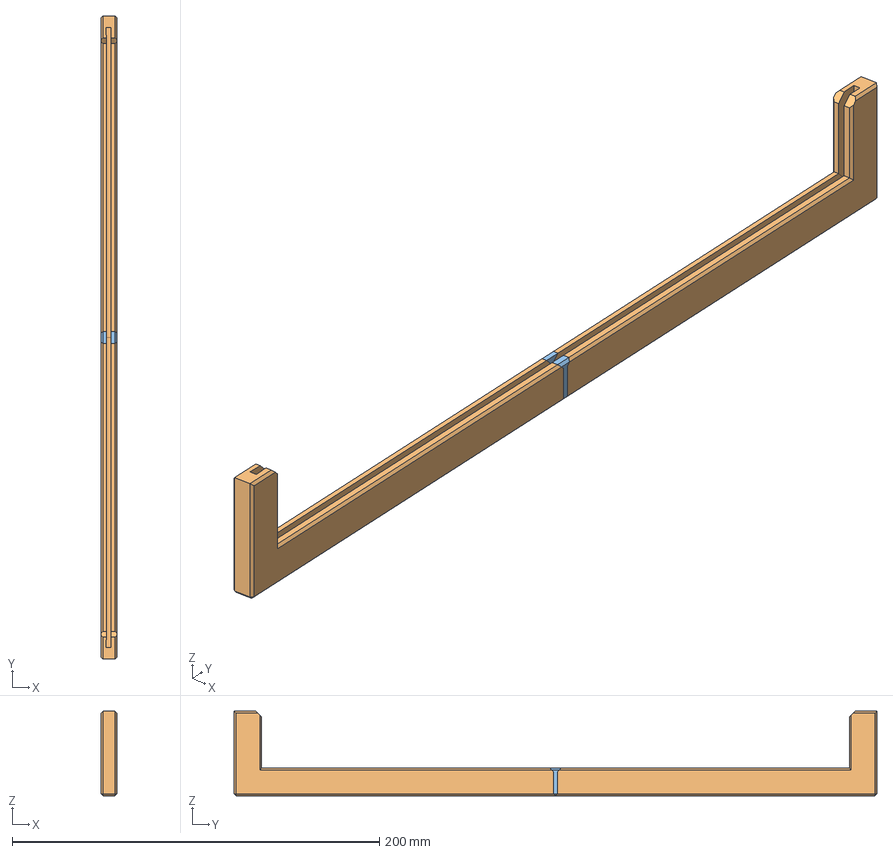
[picture p44: CAD file, 2023-02-24]
custom/mods/Clip-On_Front_Door_Frame /STEPs/Voron_Panel_Trim_250mm.step
8.73 x 350.1 x 46.0 mm
Straight_Section
Angle_Section
Angle_Section(Mirror)
Straight_Section_Long
