cee-wals/Voron-2/custom/mods/Clip-On_Front_Door_Frame /STLs/extended_door_latch_x2.stl

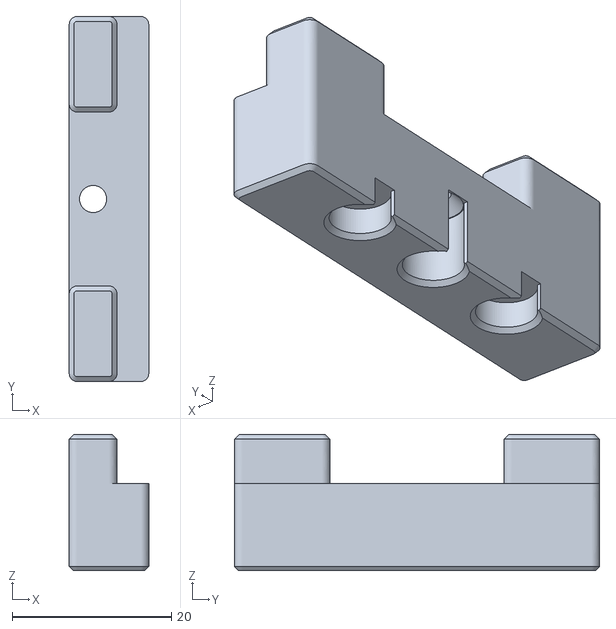
[picture p45: CAD file, 2023-02-24]
custom/mods/Clip-On_Front_Door_Frame /STLs/extended_door_latch_x2.stl
10.0 x 45.9 x 17.1
