cee-wals/Voron-2/custom/mods/Corner_Cable_Cover_with_Drop_Holes /CAD/top_corner_cable_cover_with_drop_holes.step

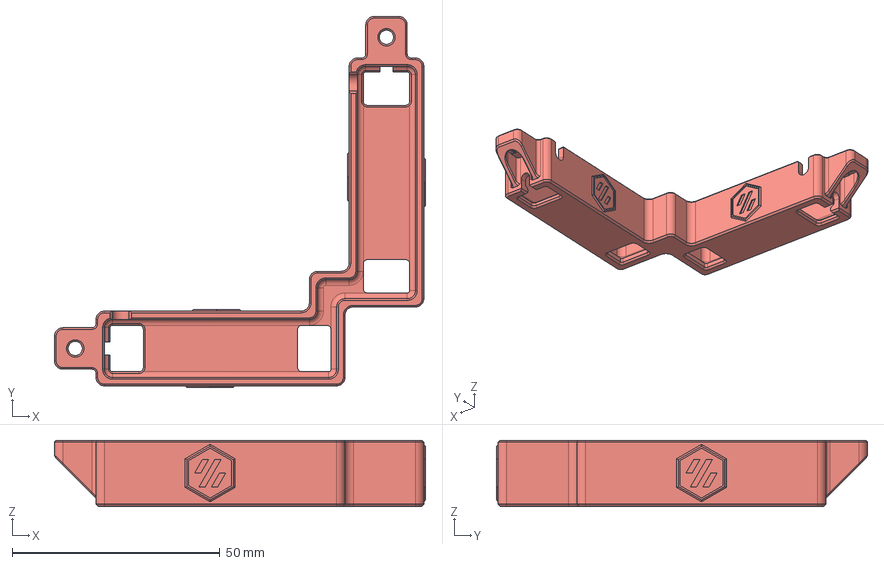
[picture p46: CAD file, 2023-02-24]
custom/mods/Corner_Cable_Cover_with_Drop_Holes /CAD/top_corner_cable_cover_with_drop_holes.step
89.4 x 89.4 x 16.0 mm
