cee-wals/Voron-2/custom/mods/Exhaust_cover_SFS/STLs/Exhaust_cover_SFS_clamp.stl

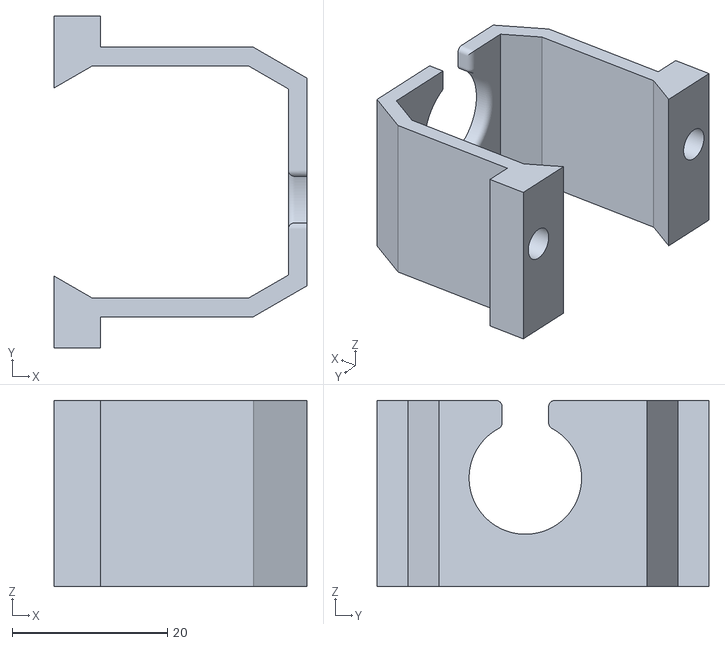
[picture p48: CAD file, 2023-02-24]
custom/mods/Exhaust_cover_SFS/STLs/Exhaust_cover_SFS_clamp.stl
32.6 x 42.8 x 24.0
