cee-wals/Voron-2/custom/mods/Hidden_cable_routing_z_belt_cover /cad/cable_routing_z_belt_cover_a_mod.step

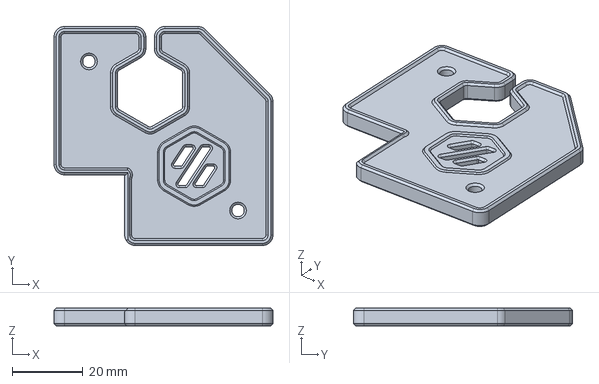
[picture p49: CAD file, 2023-02-24]
custom/mods/Hidden_cable_routing_z_belt_cover /cad/cable_routing_z_belt_cover_a_mod.step
62.0 x 62.0 x 5.00 mm
