cee-wals/Voron-2/custom/mods/microswitch_Z_endstop/z_endstop_pcb_top(new_shorter).3mf

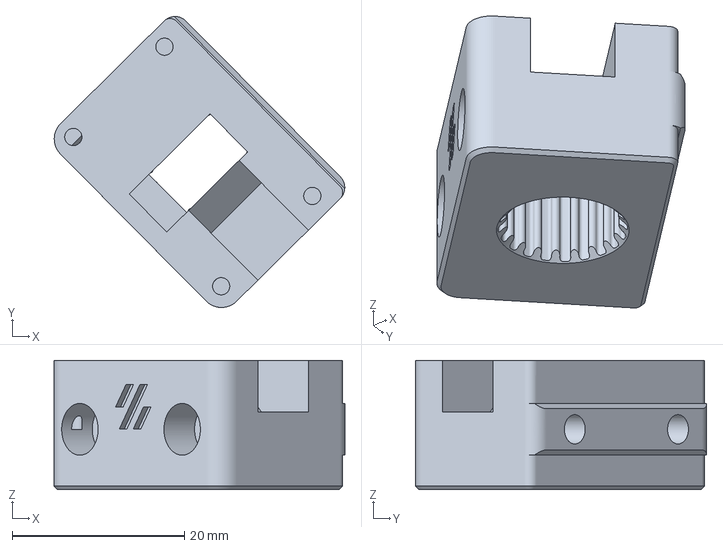
[picture p50: CAD file, 2022-12-27]
custom/mods/microswitch_Z_endstop/z_endstop_pcb_top(new_shorter).3mf
33.7 x 33.7 x 15.0 mm
