cee-wals/Voron-2/custom/mods/RemovableDoors/STL/latch_x2.stl

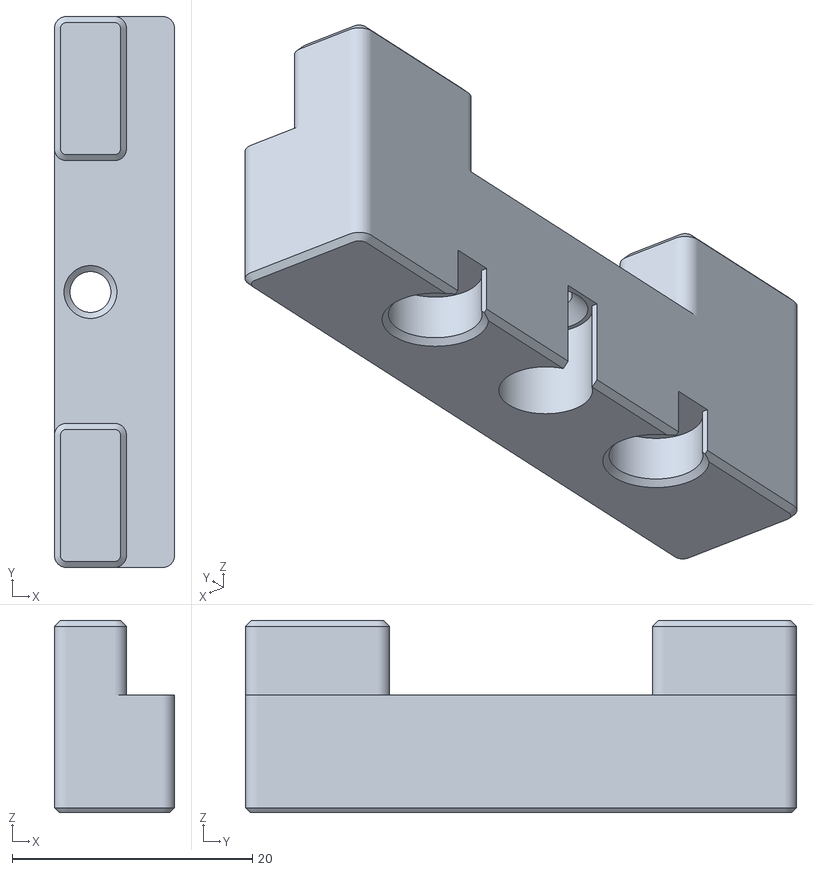
[picture p53: CAD file, 2023-02-24]
custom/mods/RemovableDoors/STL/latch_x2.stl
10.0 x 45.9 x 16.0
