cee-wals/Voron-2/custom/mods/RockNRoll/CAD/rocker_right_brace.stp

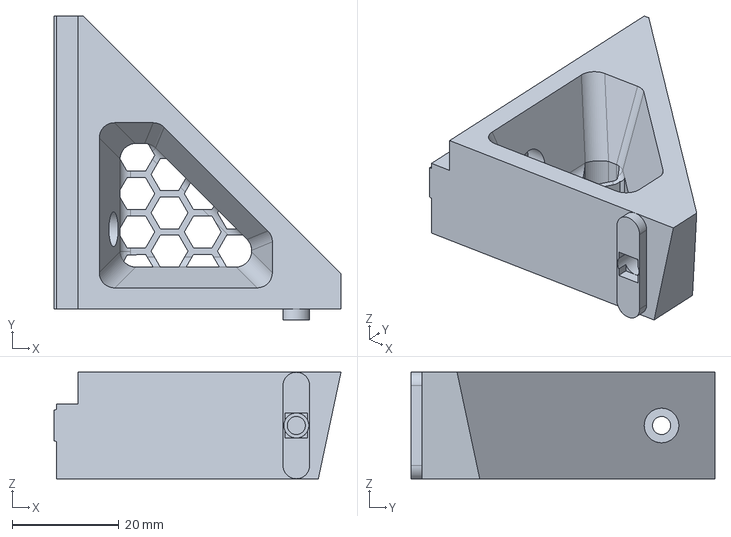
[picture p54: CAD file, 2023-02-24]
custom/mods/RockNRoll/CAD/rocker_right_brace.stp
53.9 x 57.0 x 20.0 mm
