cee-wals/Voron-2/custom/mods/RockNRoll/STLs/[a]_z_drive_baseplate_a_rnl_mod_r1.stl

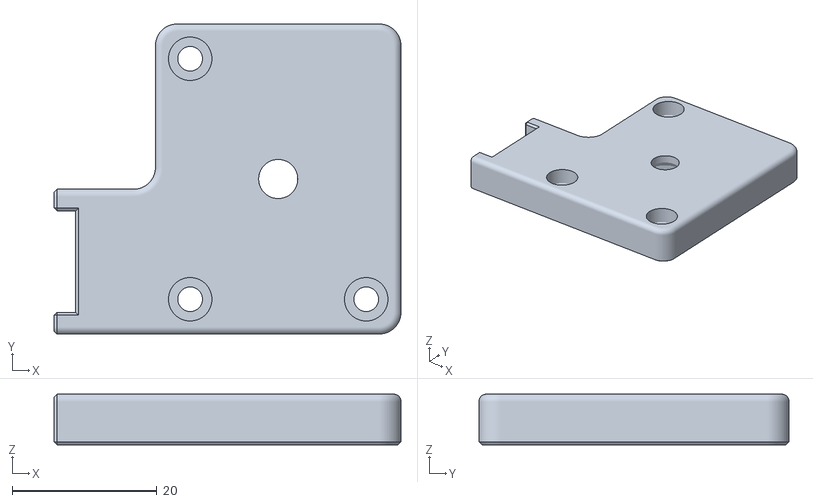
[picture p55: CAD file, 2023-02-24]
custom/mods/RockNRoll/STLs/[a]_z_drive_baseplate_a_rnl_mod_r1.stl
47.9 x 42.8 x 7.00
