cee-wals/Voron-2/custom/mods/Sturdy_Handles/CAD/sturdy_handles.step

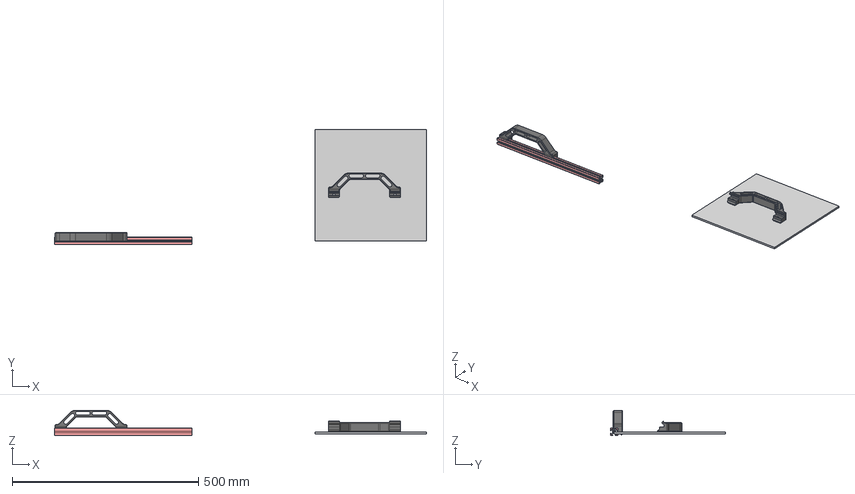
[picture p56: CAD file, 2023-02-24]
custom/mods/Sturdy_Handles/CAD/sturdy_handles.step
1000.0 x 310.0 x 68.0 mm
M5x16 BHCS x 2
Handle
Print Bed
