cee-wals/Voron-2/custom/mods/V2.4_Bed_Wiring_Grommet/grommet_1.stl

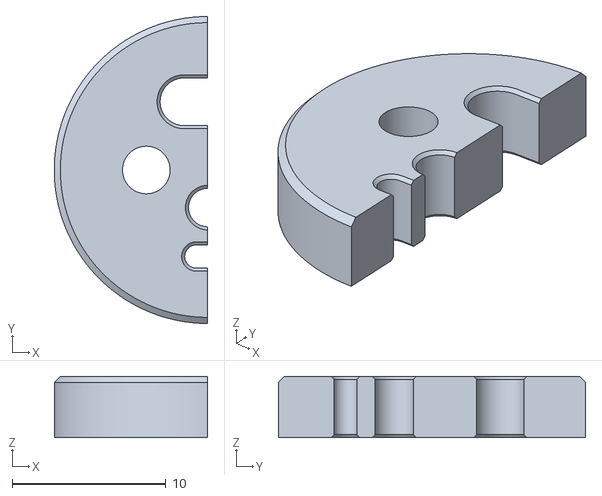
[picture p57: CAD file, 2023-02-24]
custom/mods/V2.4_Bed_Wiring_Grommet/grommet_1.stl
10.00 x 20.0 x 4.00
