cee-wals/Voron-2/custom/mods/V2.4_handle/CAD/handle.step

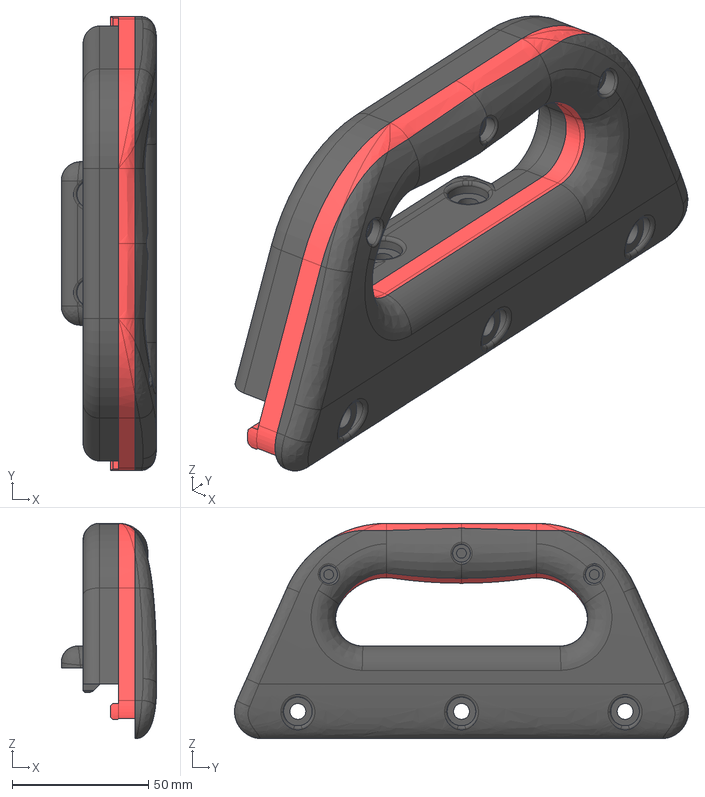
[picture p58: CAD file, 2023-02-24]
custom/mods/V2.4_handle/CAD/handle.step
35.0 x 166.5 x 79.0 mm
inner_part
middle_part
outer_part
