cee-wals/Voron-2/custom/mods/voron-v2-bed-level-camera-model_files/voron-v2-bed-level-cam-mount.3mf

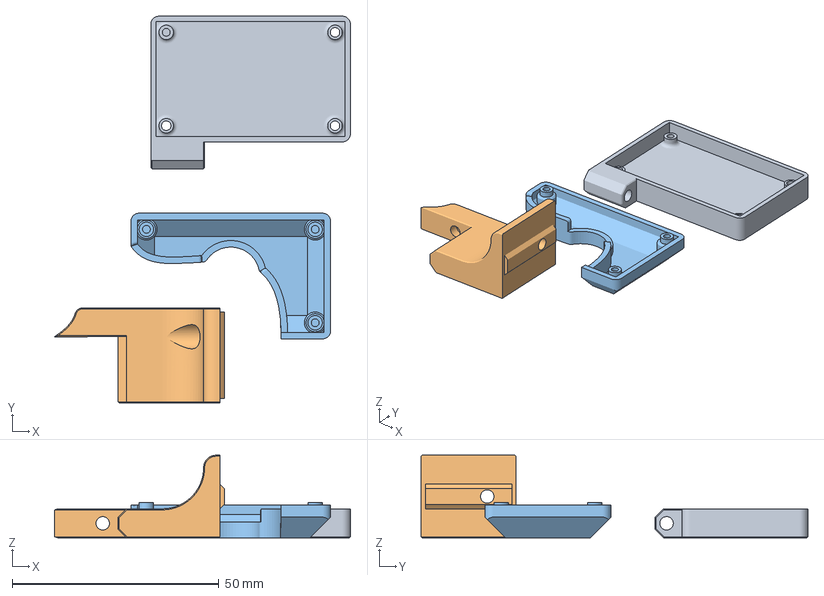
[picture p59: CAD file, 2026-08-27]
custom/mods/voron-v2-bed-level-camera-model_files/voron-v2-bed-level-cam-mount.3mf
71.7 x 93.6 x 20.0 mm
Back Plate.stl
Extrusion Mount - No Kinematics.stl
Front Cover.stl
