cee-wals/Voron-2/custom/mods/voron_sb_cw2_latch_mod_2_types.3mf

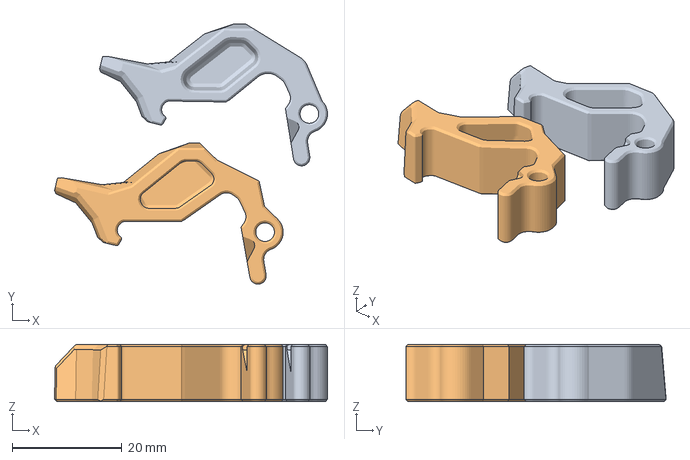
[picture p60: CAD file, 2026-08-27]
custom/mods/voron_sb_cw2_latch_mod_2_types.3mf
49.7 x 47.4 x 10.4 mm
latch_fat_finger.stl
latch.stl
