cee-wals/Voron-2/custom/mods/vz-nocturne-usb-cam-mount-model_files/case-inlay-outer.stl

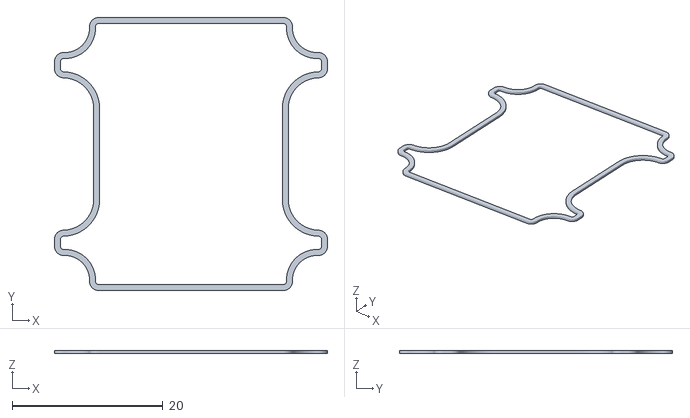
[picture p61: CAD file, 2026-08-27]
custom/mods/vz-nocturne-usb-cam-mount-model_files/case-inlay-outer.stl
36.2 x 36.2 x 0.4
