cee-wals/Voron-2/custom/tools/12mm_Linear_Rail_Alignment_Tool_for_2020___3030_T_Slot/files/Linear_Rail_2020_Alignment_Tool.stl

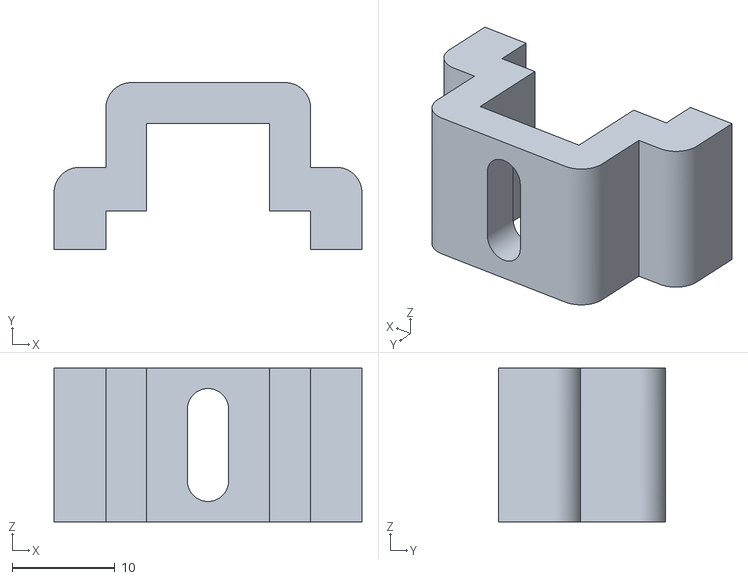
[picture p62: CAD file, 2022-12-27]
custom/tools/12mm_Linear_Rail_Alignment_Tool_for_2020___3030_T_Slot/files/Linear_Rail_2020_Alignment_Tool.stl
30.0 x 16.2 x 15.0
