cee-wals/Voron-2/custom/tools/Alignmenttool_MGN12.stl

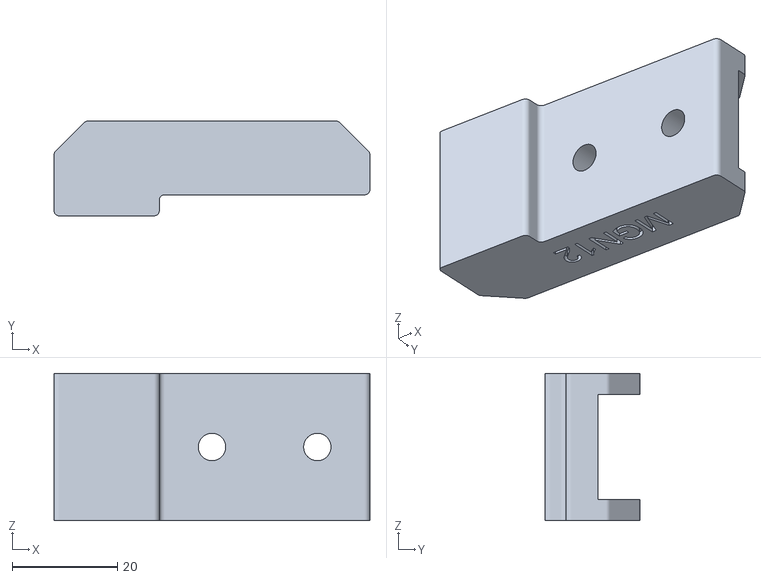
[picture p63: CAD file, 2022-12-27]
custom/tools/Alignmenttool_MGN12.stl
60.0 x 18.0 x 28.0
