cee-wals/Voron-2/custom/tools/belt_tension_guage/rev1-lite-for-9mm.3mf

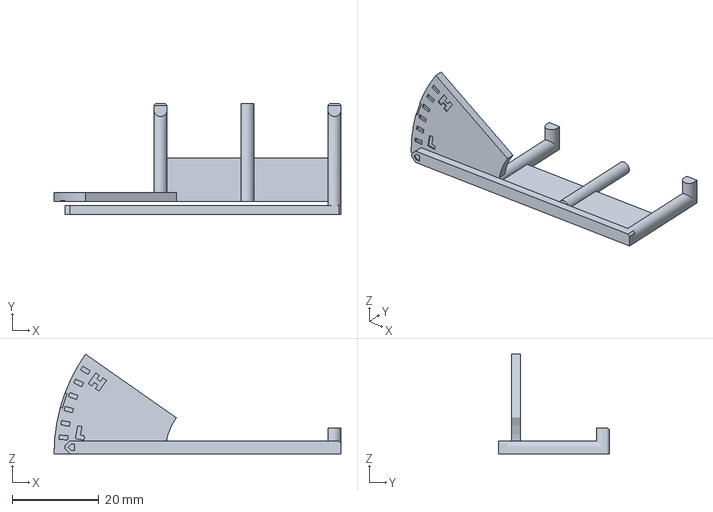
[picture p65: CAD file, 2022-12-21]
custom/tools/belt_tension_guage/rev1-lite-for-9mm.3mf
66.0 x 25.5 x 22.9 mm
