cee-wals/Voron-2/custom/tools/Belt_Tension_Meter/Belt_Tension_Meter_base.3mf

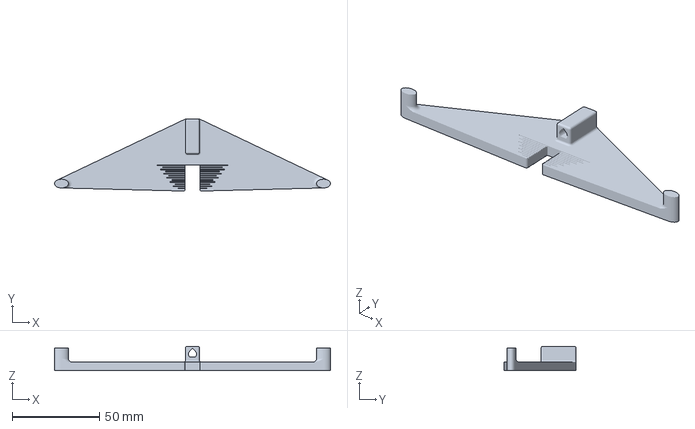
[picture p66: CAD file, 2022-12-21]
custom/tools/Belt_Tension_Meter/Belt_Tension_Meter_base.3mf
158.0 x 41.3 x 14.0 mm
