cee-wals/Voron-2/custom/tools/VoronMods_belt_tension_meter/TensionMeter.stl

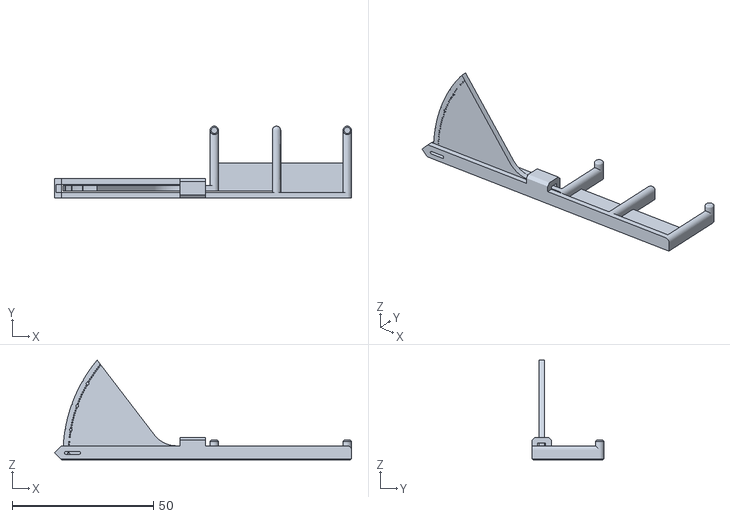
[picture p67: CAD file, 2022-12-27]
custom/tools/VoronMods_belt_tension_meter/TensionMeter.stl
105.0 x 25.4 x 35.3
