cee-wals/Voron-2/custom/tools/VoronMods_misaligned_rail_tools/Dial_indicator_AB_beta.stl

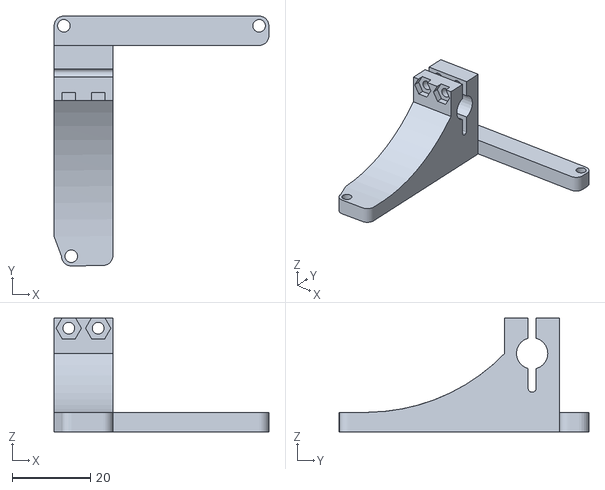
[picture p68: CAD file, 2022-12-27]
custom/tools/VoronMods_misaligned_rail_tools/Dial_indicator_AB_beta.stl
54.8 x 63.7 x 29.0
