cee-wals/Voron-2/custom/voronica/test-prints/ringing_tower.3mf

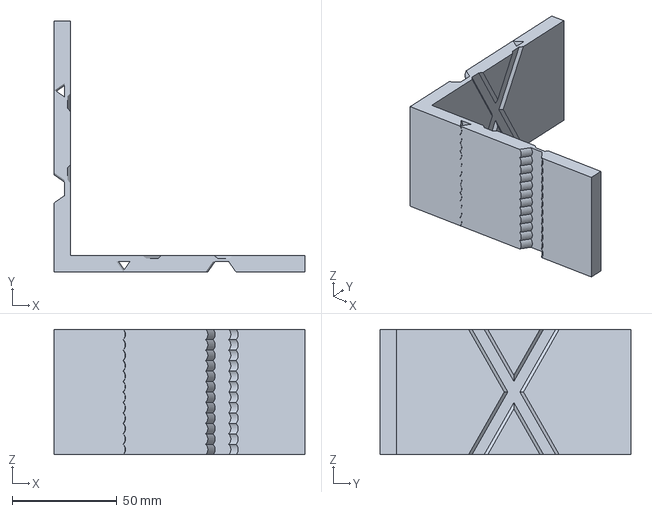
[picture p69: CAD file, 2026-08-27]
custom/voronica/test-prints/ringing_tower.3mf
120.0 x 120.0 x 60.0 mm
