cee-wals/Voron-2/STLs/Electronics_Bay/Controller_Mounts/Manta-M8P_Bracket.stl

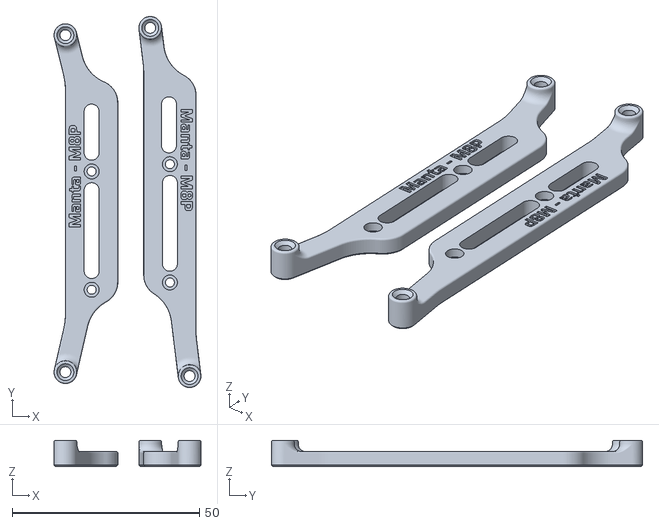
[picture p71: CAD file, 2022-12-12]
STLs/Electronics_Bay/Controller_Mounts/Manta-M8P_Bracket.stl
39.3 x 99.1 x 7.00
