cee-wals/Voron-2/STLs/Exhaust_Filter/exhaust_filter_housing.stl

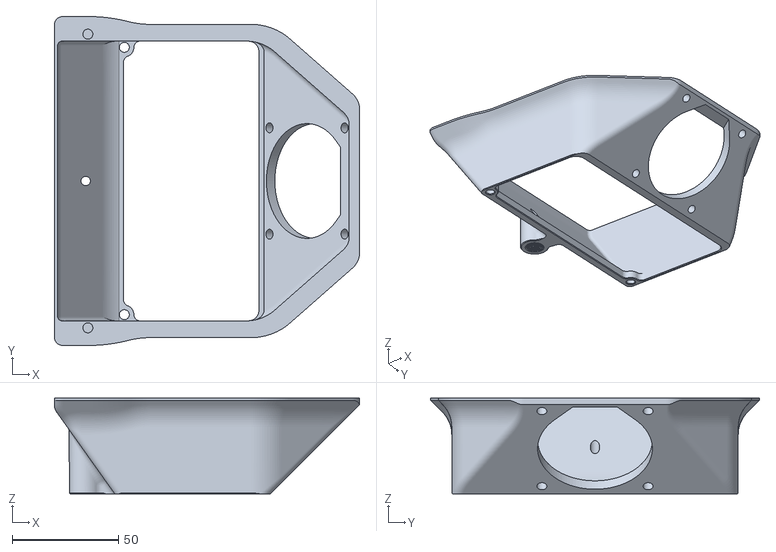
[picture p72: CAD file, 2022-12-27]
STLs/Exhaust_Filter/exhaust_filter_housing.stl
143.7 x 154.8 x 45.0
