cee-wals/Voron-2/STLs/Panel_Mounting/bottom_panel_clip_x4.3mf

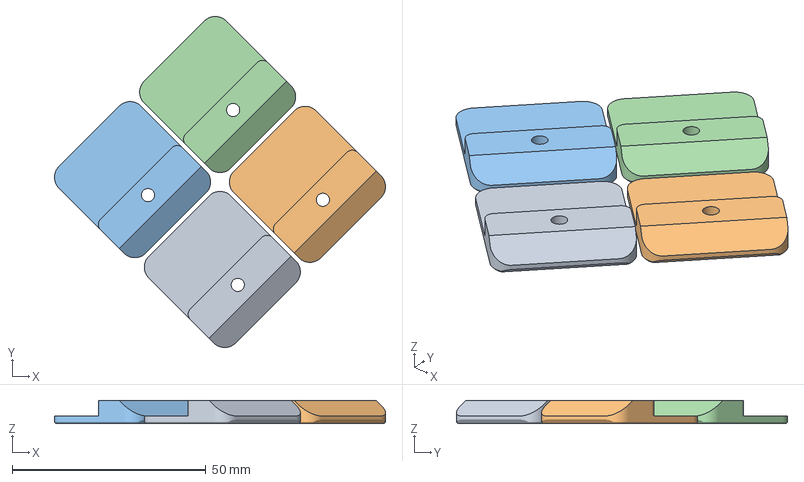
[picture p73: CAD file, 2023-01-05]
STLs/Panel_Mounting/bottom_panel_clip_x4.3mf
85.5 x 85.5 x 6.00 mm
