cee-wals/Voron-2/custom/3mf/in-progress/filter/[a]_exhaust_filter_fan_grill.3mf

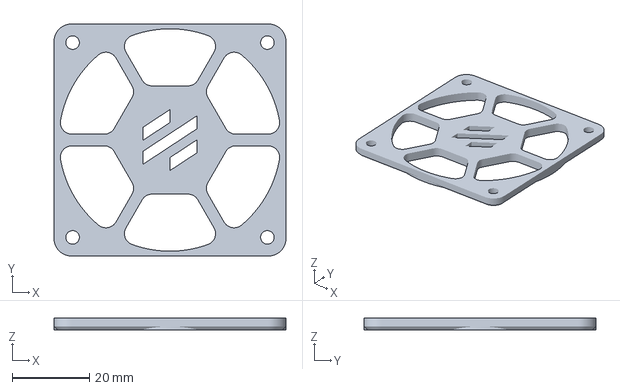
[picture p74: CAD file, 2022-12-27]
custom/3mf/in-progress/filter/[a]_exhaust_filter_fan_grill.3mf
60.0 x 60.0 x 3.20 mm
