cee-wals/Voron-2/custom/3mf/in-progress/lrs_200_psu_bracket_x2.3mf

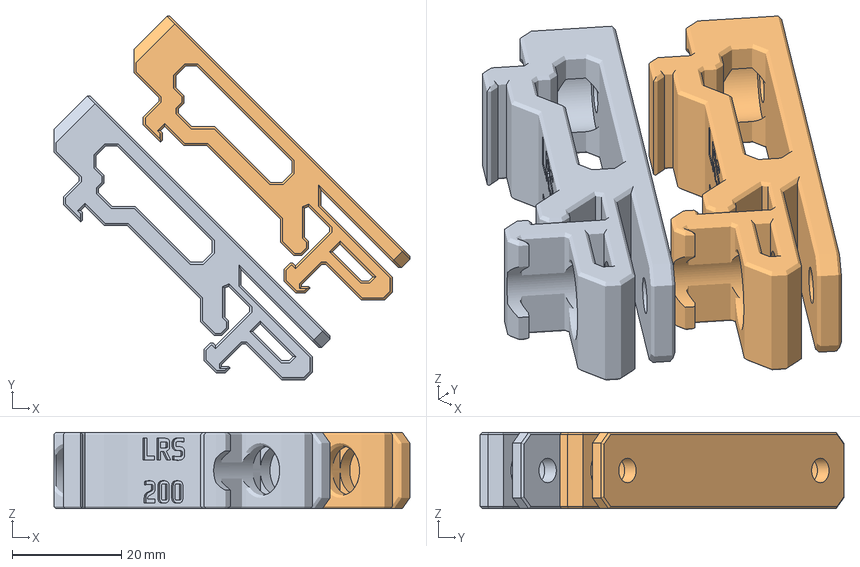
[picture p75: CAD file, 2023-01-05]
custom/3mf/in-progress/lrs_200_psu_bracket_x2.3mf
65.3 x 66.7 x 14.0 mm
