cee-wals/Voron-2/custom/3mf/in-progress/panel/door_hardware.3mf

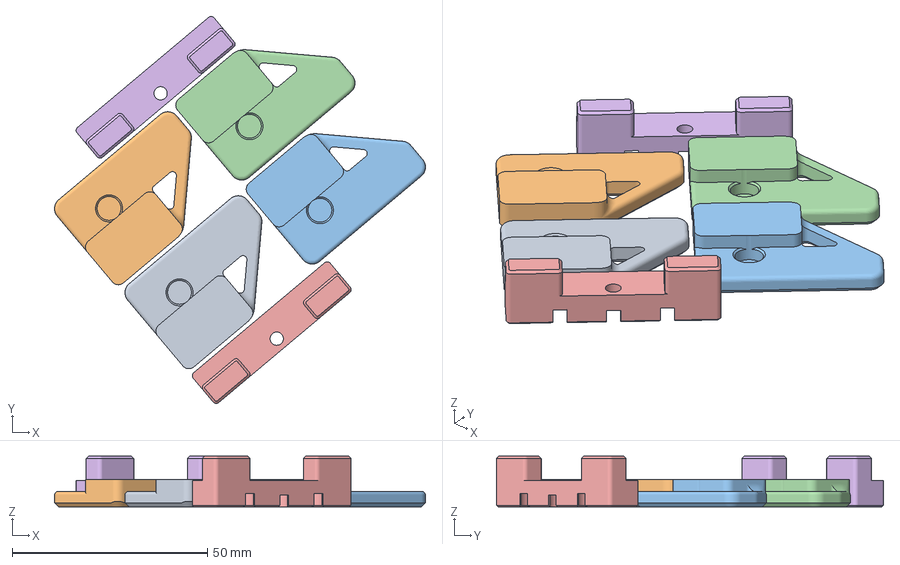
[picture p76: CAD file, 2023-01-05]
custom/3mf/in-progress/panel/door_hardware.3mf
95.1 x 99.2 x 13.0 mm
handle_a_x2.stl
handle_b_x2.stl
latch_x2.stl
