cee-wals/Voron-2/custom/3mf/in-progress/skirt/power_inlet_filtered.3mf

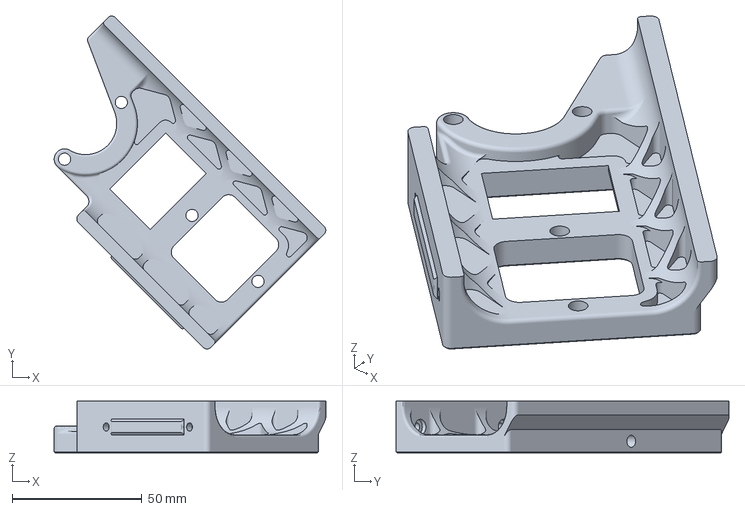
[picture p77: CAD file, 2022-12-27]
custom/3mf/in-progress/skirt/power_inlet_filtered.3mf
104.8 x 128.5 x 20.0 mm
