cee-wals/Voron-2/custom/3mf/in-progress/spool-management/spool_holder.3mf

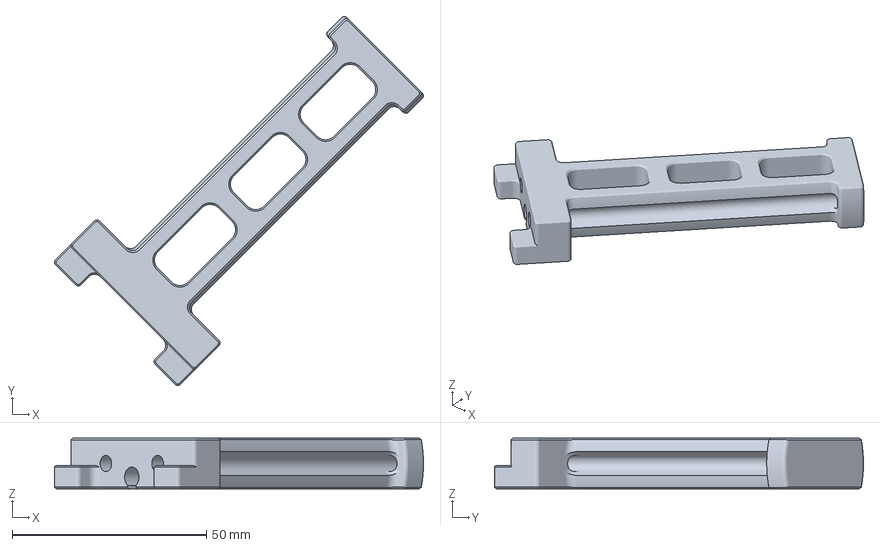
[picture p78: CAD file, 2023-01-05]
custom/3mf/in-progress/spool-management/spool_holder.3mf
94.9 x 94.9 x 13.0 mm
