cee-wals/Voron-2/custom/3mf/mods/Panel_snap_latches/SnapLatch-4.0mm-x1.3mf

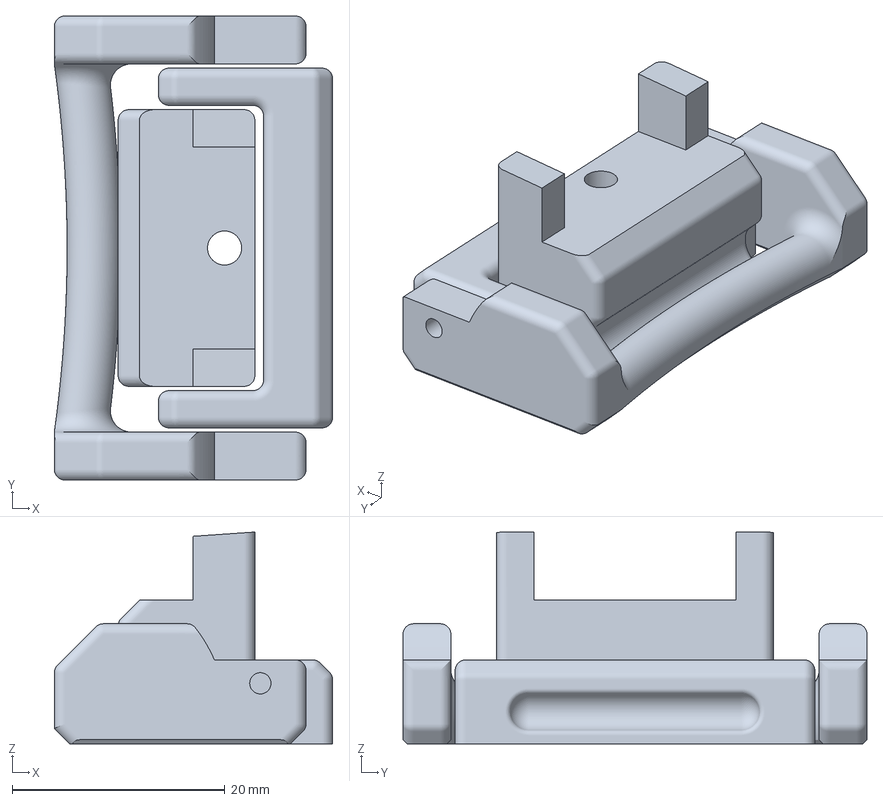
[picture p80: CAD file, 2023-02-24]
custom/3mf/mods/Panel_snap_latches/SnapLatch-4.0mm-x1.3mf
26.2 x 43.6 x 19.9 mm
