cee-wals/Voron-2/custom/3mf/mods/RemovableDoors/Right_n_Left_Leaf_VHB_With_Accent_x2.3mf

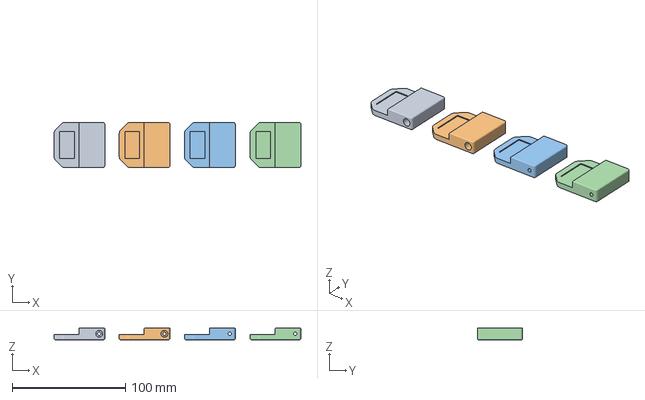
[picture p81: CAD file, 2026-08-27]
custom/3mf/mods/RemovableDoors/Right_n_Left_Leaf_VHB_With_Accent_x2.3mf
218.0 x 40.0 x 10.6 mm
Right_Leaf_VHB_With_Accent_x2.stl
Left_Leaf_VHB_With_Accent_x2.stl
