cee-wals/Voron-2/custom/3mf/mods/sturdy_handles.3mf

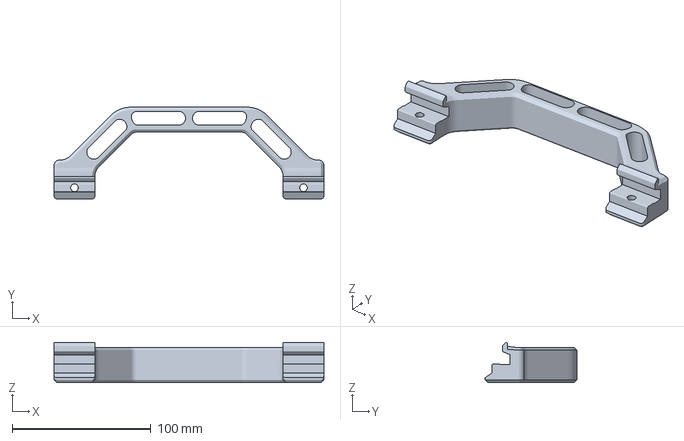
[picture p82: CAD file, 2023-02-24]
custom/3mf/mods/sturdy_handles.3mf
194.3 x 66.0 x 28.9 mm
