cee-wals/Voron-2/custom/3mf/mods/V2.4_handle/[a]_handle_middle_part.3mf

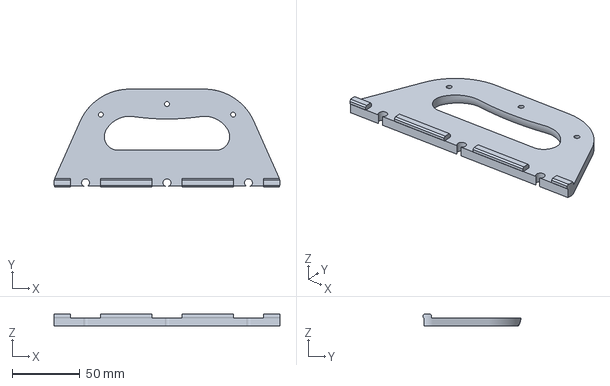
[picture p83: CAD file, 2023-02-24]
custom/3mf/mods/V2.4_handle/[a]_handle_middle_part.3mf
166.5 x 72.0 x 9.00 mm
