cee-wals/Voron-2/custom/3mf/success/gantry-installation-hook.3mf

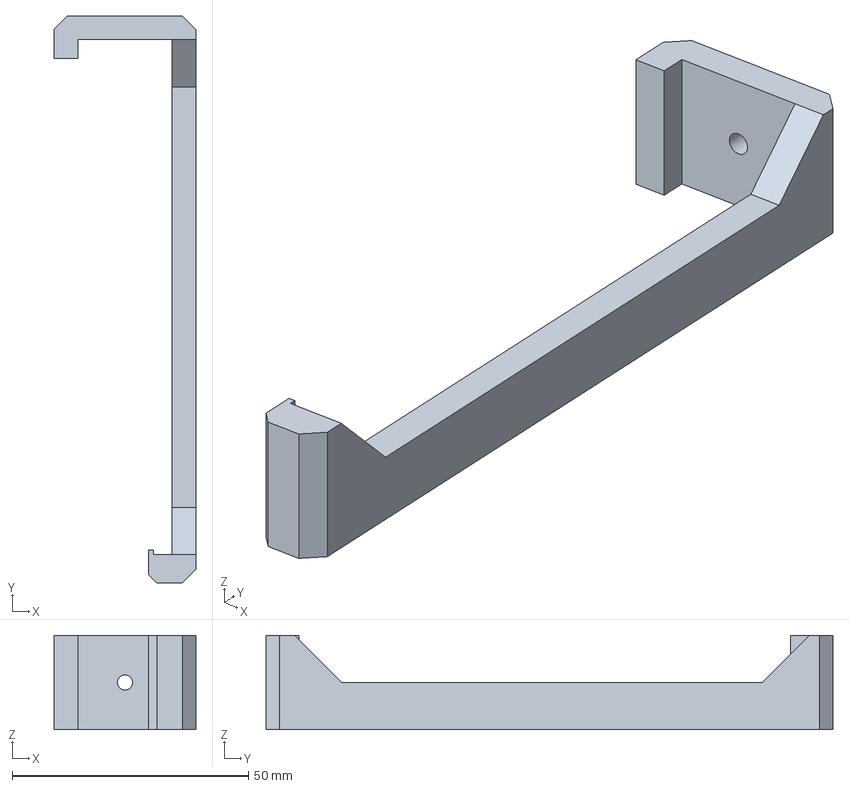
[picture p84: CAD file, 2022-12-21]
custom/3mf/success/gantry-installation-hook.3mf
30.0 x 120.0 x 20.0 mm
