cee-wals/Voron-2/custom/3mf/success/RockNRoll/rocker_right_brace.3mf

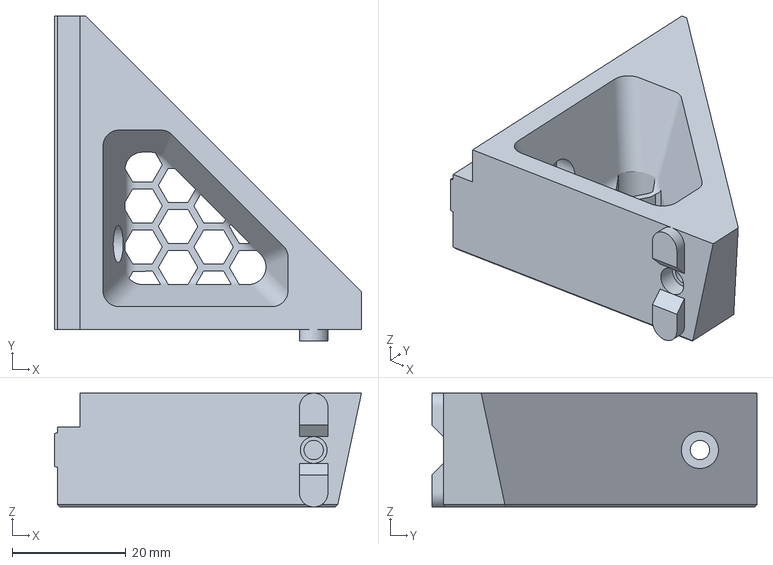
[picture p85: CAD file, 2023-02-24]
custom/3mf/success/RockNRoll/rocker_right_brace.3mf
53.9 x 57.0 x 20.0 mm
