cee-wals/Voron-2/custom/mods/20x20mm_Profile_Covers /CAD/2020_Profile_Cover.step

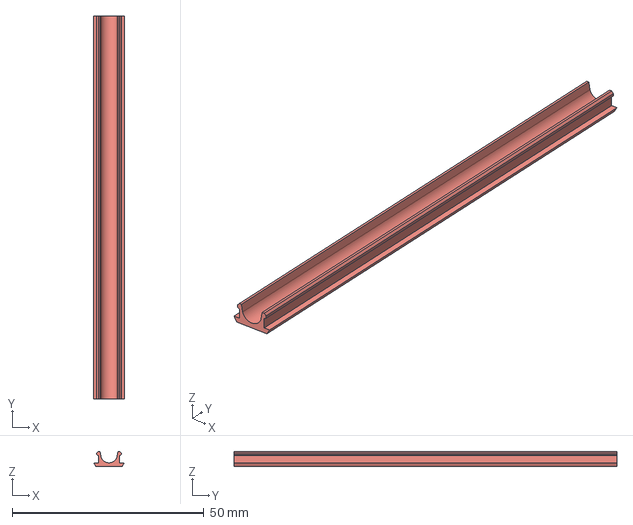
[picture p86: CAD file, 2023-02-24]
custom/mods/20x20mm_Profile_Covers /CAD/2020_Profile_Cover.step
8.00 x 100.0 x 4.00 mm
