cee-wals/Voron-2/custom/mods/CableGator-Cable-Comb /STLs/Voron-CableGator-Upper-Jaw.stl

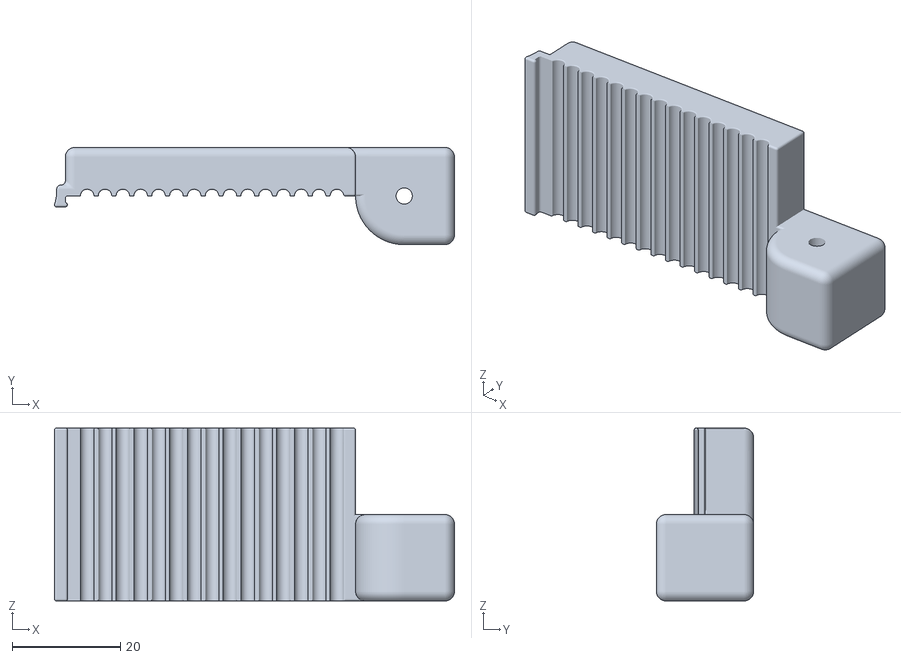
[picture p87: CAD file, 2023-02-24]
custom/mods/CableGator-Cable-Comb /STLs/Voron-CableGator-Upper-Jaw.stl
74.0 x 18.0 x 32.0
