cee-wals/Voron-2/custom/mods/Clip-On_Front_Door_Frame /STEPs/Voron_Panel_Trim_350mm.step

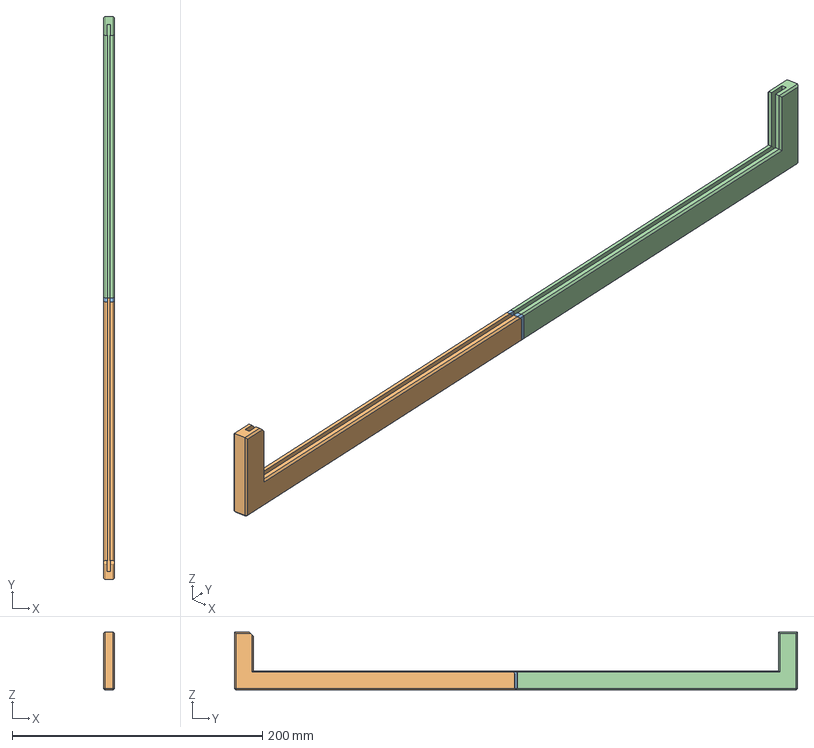
[picture p88: CAD file, 2023-02-24]
custom/mods/Clip-On_Front_Door_Frame /STEPs/Voron_Panel_Trim_350mm.step
8.73 x 450.1 x 46.0 mm
Straight_Section
Angle_Section
Straight_Section_Long
Angle_Section(Mirror)
