cee-wals/Voron-2/custom/mods/Clip-On_Front_Door_Frame /STLs/350mm_straight_frame_short_x4.stl

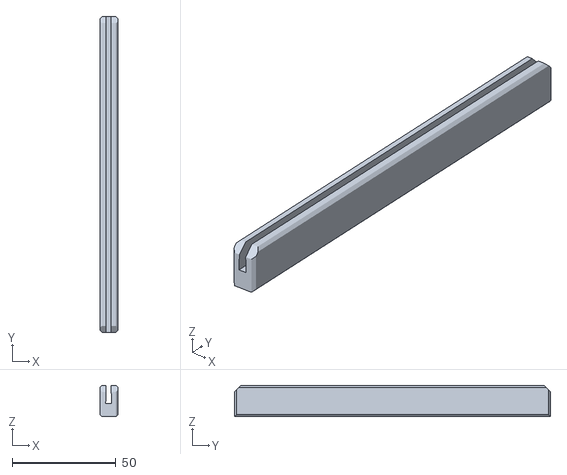
[picture p89: CAD file, 2023-02-24]
custom/mods/Clip-On_Front_Door_Frame /STLs/350mm_straight_frame_short_x4.stl
8.73 x 152.0 x 15.1
