cee-wals/Voron-2/custom/mods/Exhaust_cover_SFS/STLs/Exhaust_cover_SFS_v1.01.stl

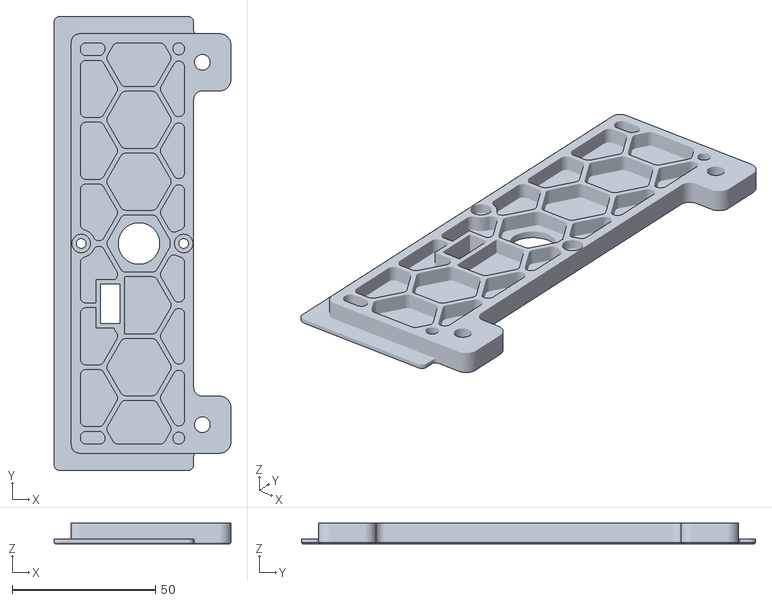
[picture p90: CAD file, 2023-02-24]
custom/mods/Exhaust_cover_SFS/STLs/Exhaust_cover_SFS_v1.01.stl
61.8 x 158.6 x 7.20
