cee-wals/Voron-2/custom/mods/microswitch_Z_endstop/[a]_z_endstop_pcb_bottom.3mf

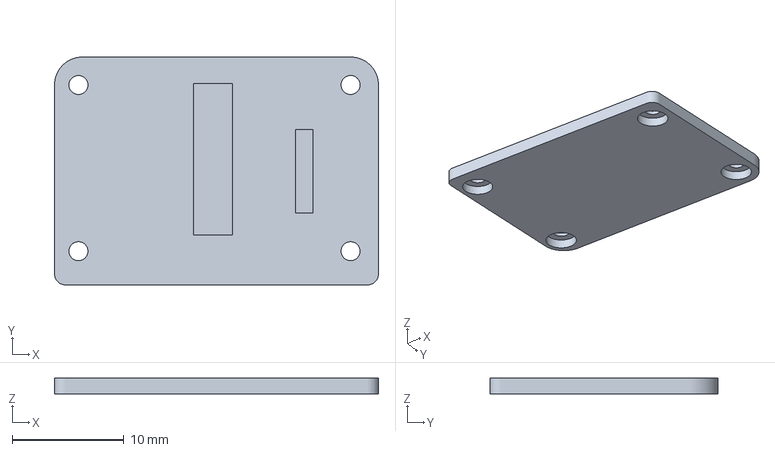
[picture p91: CAD file, 2022-12-27]
custom/mods/microswitch_Z_endstop/[a]_z_endstop_pcb_bottom.3mf
29.0 x 20.4 x 1.40 mm
