cee-wals/Voron-2/custom/mods/Mounts_for_BTT_Filament_Motion_Sensor/BTT_Sensor_Mount_A.stl

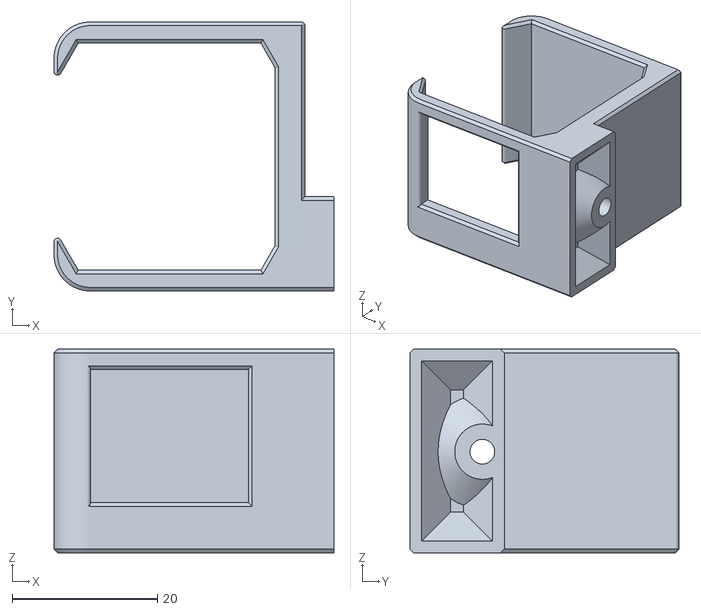
[picture p92: CAD file, 2023-02-24]
custom/mods/Mounts_for_BTT_Filament_Motion_Sensor/BTT_Sensor_Mount_A.stl
38.5 x 37.0 x 28.0
