cee-wals/Voron-2/custom/mods/Printable_snaplatches_for_2020_extrusion/STL/NewLatch-4.5mm.stl

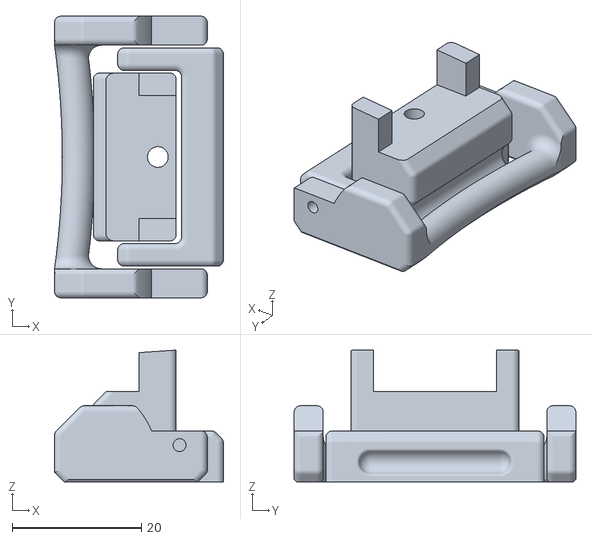
[picture p93: CAD file, 2023-02-24]
custom/mods/Printable_snaplatches_for_2020_extrusion/STL/NewLatch-4.5mm.stl
26.2 x 43.6 x 20.4
