cee-wals/Voron-2/custom/mods/RemovableDoors/STL/mod_5x3_handle_a_small.stl

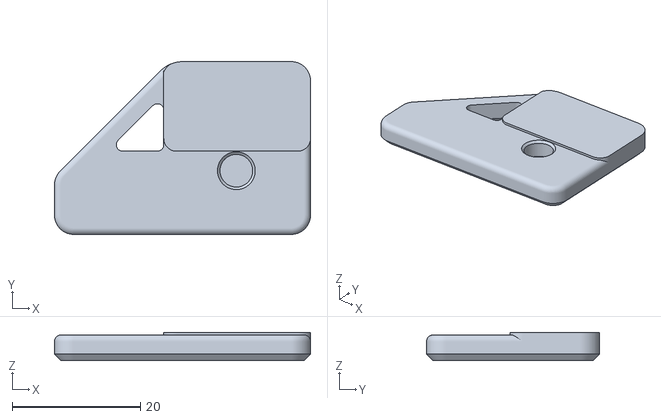
[picture p94: CAD file, 2023-02-24]
custom/mods/RemovableDoors/STL/mod_5x3_handle_a_small.stl
40.0 x 27.0 x 4.40
