cee-wals/Voron-2/custom/mods/RockNRoll/STLs/[a]_z_drive_baseplate_b_rnl_mod_r2.stl

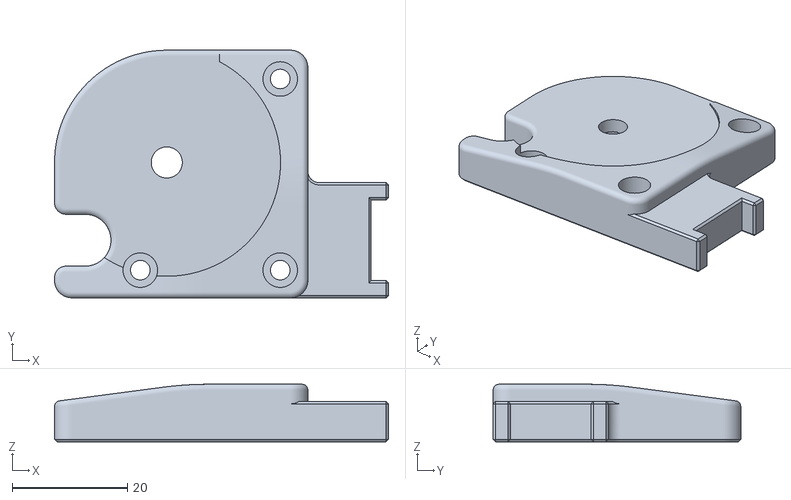
[picture p95: CAD file, 2023-02-24]
custom/mods/RockNRoll/STLs/[a]_z_drive_baseplate_b_rnl_mod_r2.stl
58.0 x 43.0 x 10.0
