cee-wals/Voron-2/custom/mods/voron-v2-bed-level-camera-model_files/Back Plate.stl

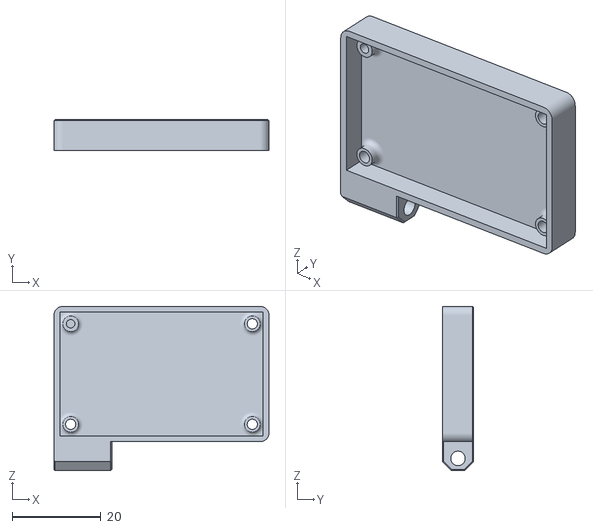
[picture p97: CAD file, 2026-08-27]
custom/mods/voron-v2-bed-level-camera-model_files/Back Plate.stl
48.4 x 7.01 x 36.9
