cee-wals/Voron-2/custom/mods/vz-nocturne-usb-cam-mount-model_files/back-plate-logo-4.stl

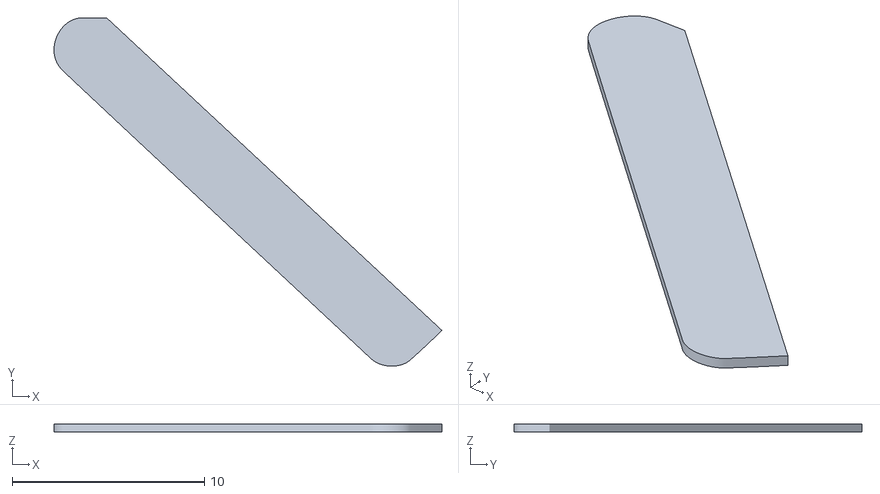
[picture p98: CAD file, 2026-08-27]
custom/mods/vz-nocturne-usb-cam-mount-model_files/back-plate-logo-4.stl
20.2 x 18.1 x 0.4
