cee-wals/Voron-2/custom/tools/12mm_Linear_Rail_Alignment_Tool_for_2020___3030_T_Slot/files/Linear_Rail_3030_Alignment_Tool.stl

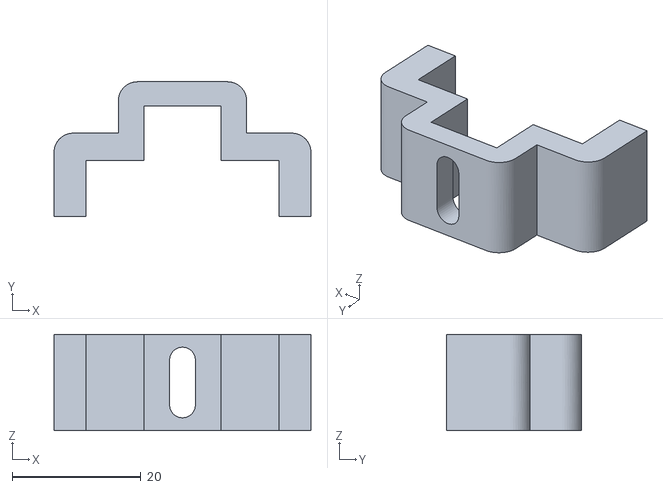
[picture p99: CAD file, 2022-12-27]
custom/tools/12mm_Linear_Rail_Alignment_Tool_for_2020___3030_T_Slot/files/Linear_Rail_3030_Alignment_Tool.stl
40.0 x 20.9 x 15.0
