cee-wals/Voron-2/custom/tools/Bed_Support_Alignment_Tools/Bed_Support_Alignment_Tool_350_Corners_x4.stl

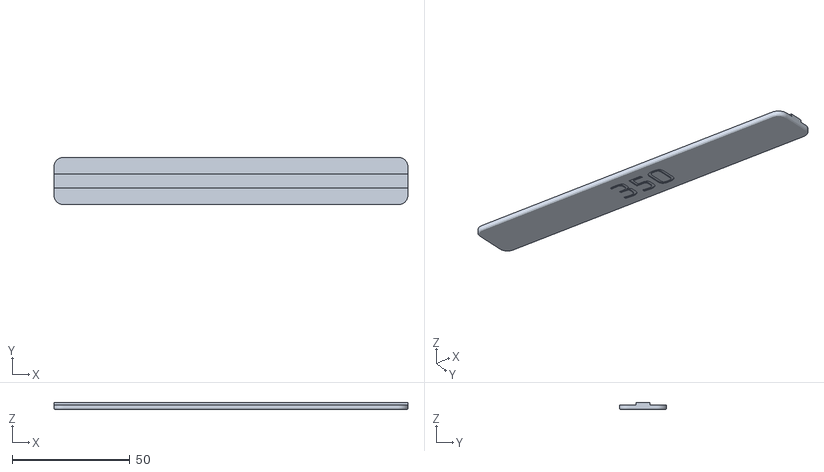
[picture p100: CAD file, 2022-12-27]
custom/tools/Bed_Support_Alignment_Tools/Bed_Support_Alignment_Tool_350_Corners_x4.stl
150.0 x 20.0 x 2.99
