cee-wals/Voron-2/custom/tools/belt_tension_guage/rev1-lite-for-6mm.3mf

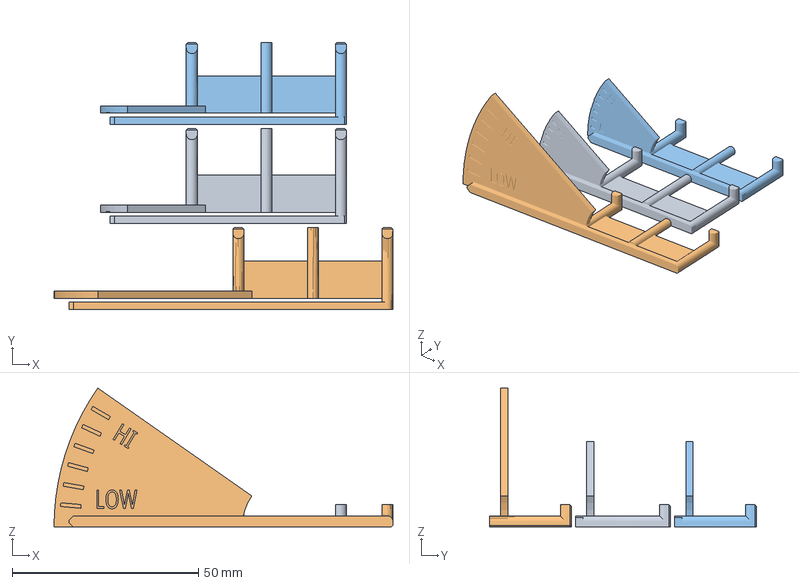
[picture p101: CAD file, 2022-12-21]
custom/tools/belt_tension_guage/rev1-lite-for-6mm.3mf
91.0 x 71.7 x 37.3 mm
rev1-lite-for-9mm.stl
rev1-with-text.stl
rev1-lite-for-6mm.stl
