cee-wals/Voron-2/custom/tools/Belt_Tension_Meter/Belt_Tension_Meter.3mf

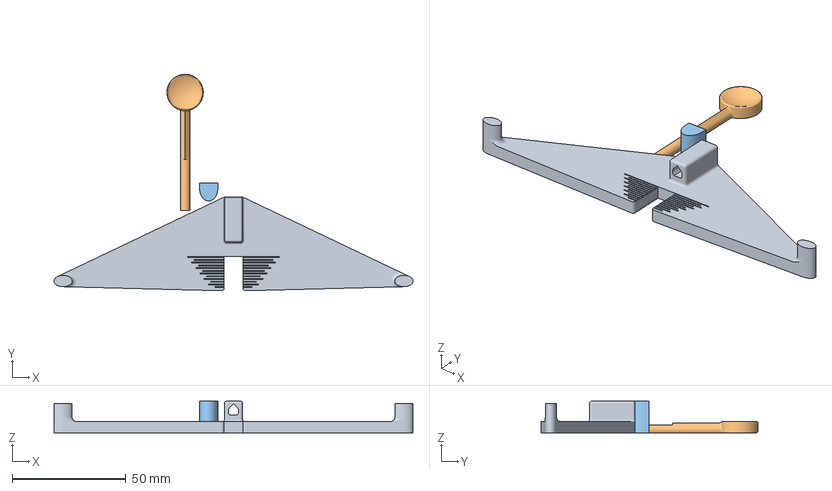
[picture p102: CAD file, 2022-12-21]
custom/tools/Belt_Tension_Meter/Belt_Tension_Meter.3mf
158.0 x 95.3 x 14.0 mm
Belt_Tension_Meter_base.STL
Belt_Tension_Meter_stick.STL
Belt_Tension_Meter_finger.STL
