cee-wals/Voron-2/custom/tools/jig.3mf

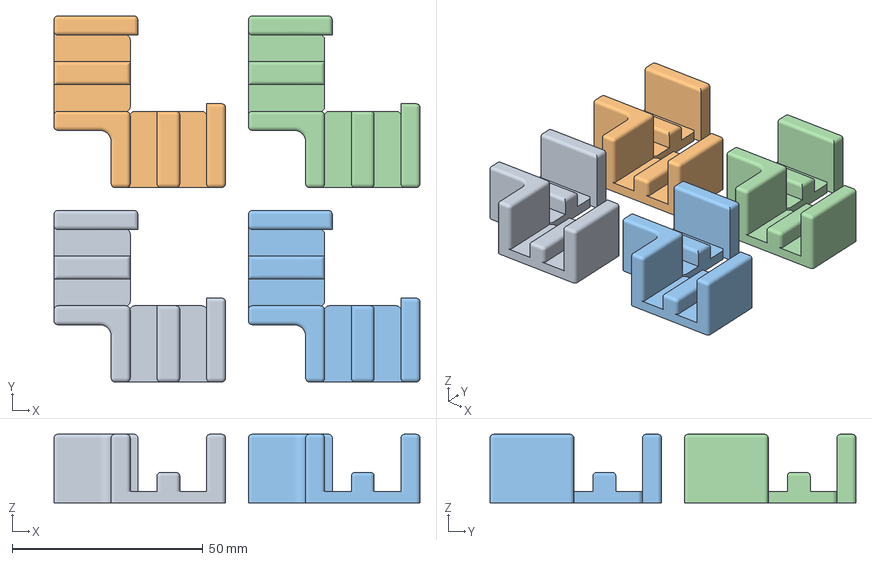
[picture p103: CAD file, 2022-12-01]
custom/tools/jig.3mf
96.0 x 96.0 x 18.0 mm
jig.stl x 4
