cee-wals/Voron-2/custom/tools/VoronMods_misaligned_rail_tools/Rail_adjust_body.stl

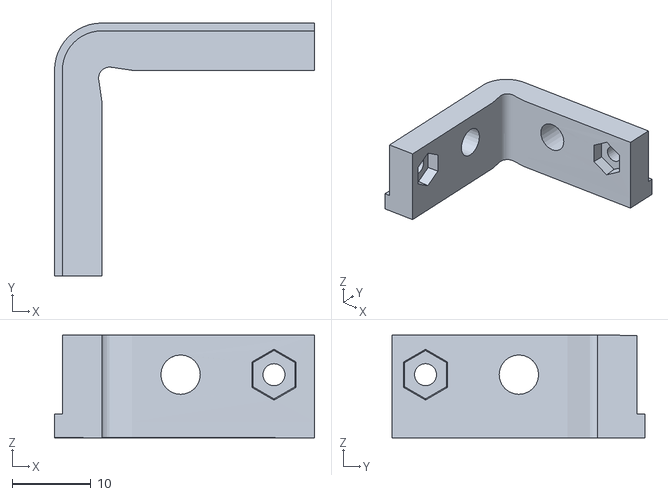
[picture p104: CAD file, 2022-12-27]
custom/tools/VoronMods_misaligned_rail_tools/Rail_adjust_body.stl
33.0 x 32.1 x 13.0
