cee-wals/Voron-2/custom/voronica/test-prints/Thread_Test_3_x1_Rev1.stl

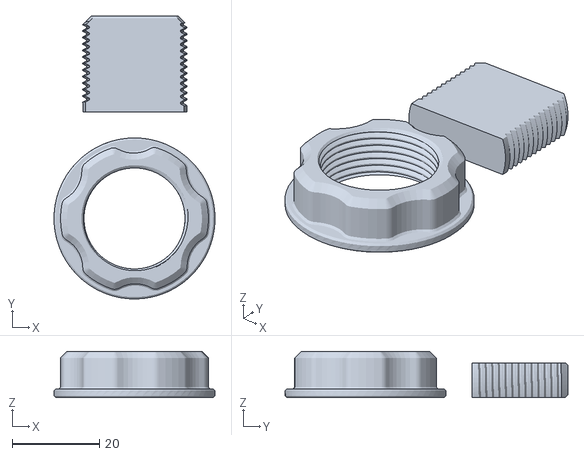
[picture p105: CAD file, 2026-08-27]
custom/voronica/test-prints/Thread_Test_3_x1_Rev1.stl
37.0 x 65.0 x 10.6
