cee-wals/Voron-2/custom/3mf/in-progress/filter/[a]_filter_access_cover.3mf

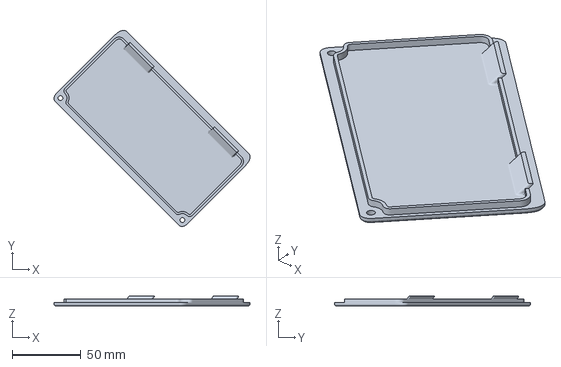
[picture p106: CAD file, 2022-12-27]
custom/3mf/in-progress/filter/[a]_filter_access_cover.3mf
143.0 x 143.0 x 7.20 mm
