cee-wals/Voron-2/custom/3mf/in-progress/panel/corner_panel_clip_6mm_x8.3mf

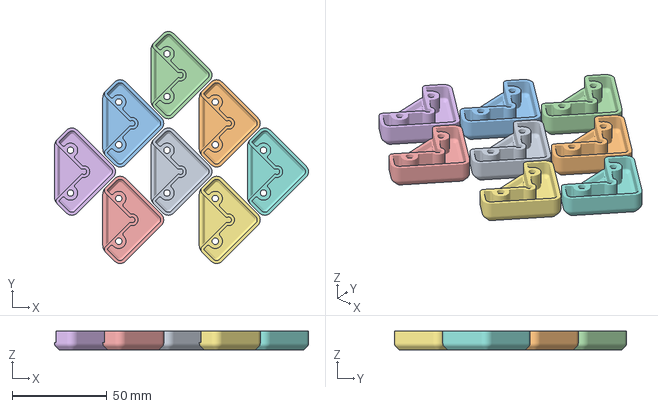
[picture p107: CAD file, 2023-01-05]
custom/3mf/in-progress/panel/corner_panel_clip_6mm_x8.3mf
134.4 x 122.8 x 10.00 mm
