cee-wals/Voron-2/custom/3mf/in-progress/skirt/rear_center_skirt_350.3mf

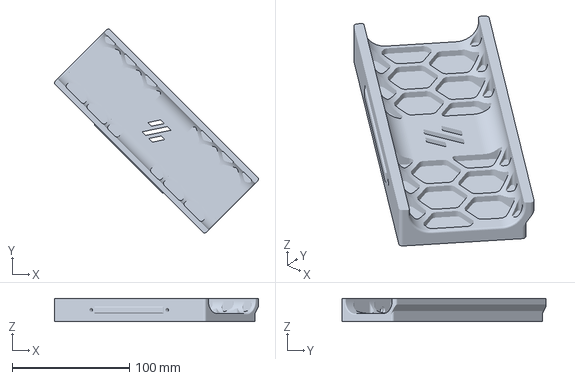
[picture p108: CAD file, 2022-12-27]
custom/3mf/in-progress/skirt/rear_center_skirt_350.3mf
173.7 x 173.7 x 20.0 mm
