cee-wals/Voron-2/custom/3mf/mods/Angry_CAM_USB/Angry_CAM_Front_120_covers.3mf

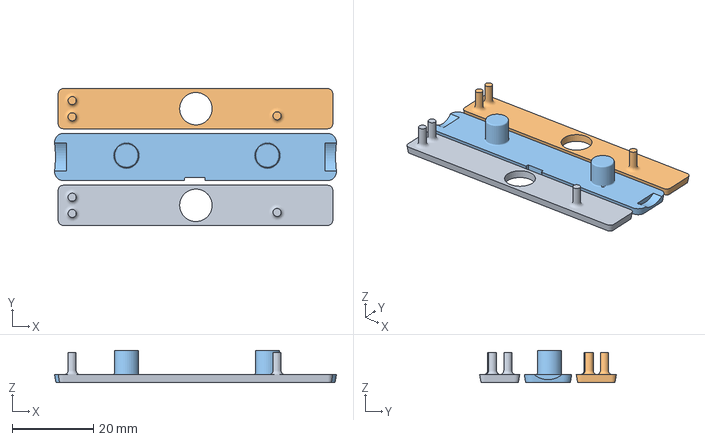
[picture p109: CAD file, 2023-02-24]
custom/3mf/mods/Angry_CAM_USB/Angry_CAM_Front_120_covers.3mf
69.5 x 33.7 x 8.00 mm
Front_Cover_120+.stl
Rear_Cover_120+.stl
