cee-wals/Voron-2/custom/3mf/mods/Panel_snap_latches/SnapLatch-6.0mm-x12.3mf

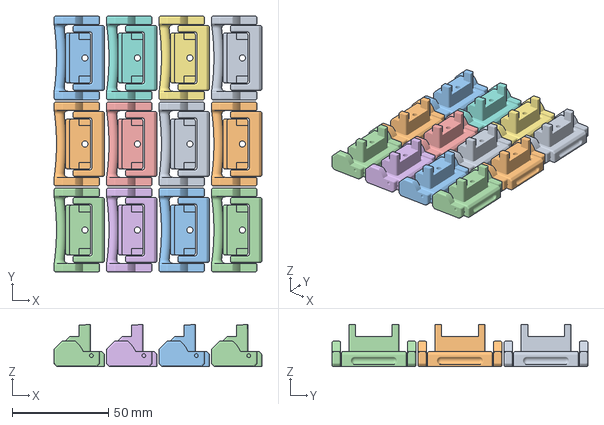
[picture p110: CAD file, 2023-02-24]
custom/3mf/mods/Panel_snap_latches/SnapLatch-6.0mm-x12.3mf
107.9 x 133.0 x 21.9 mm
