cee-wals/Voron-2/custom/3mf/mods/RemovableDoors/RemovableDoors_VHB_Left_Leaf_x1_with_Accent_MMU.3mf

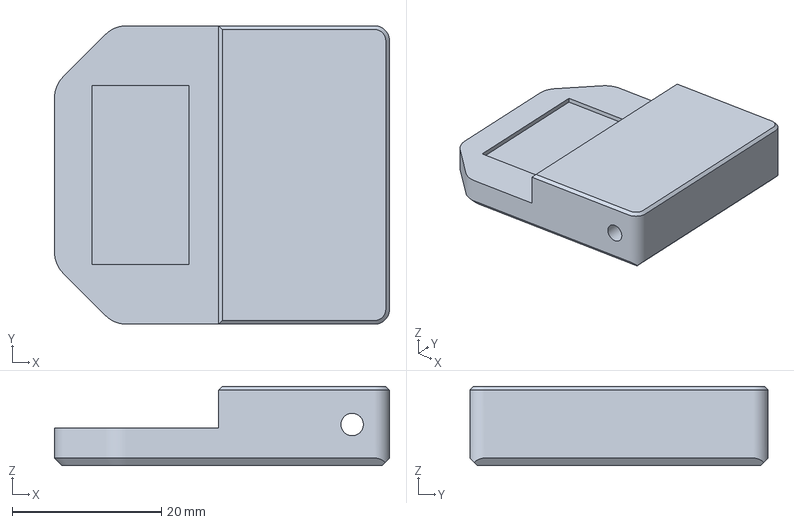
[picture p111: CAD file, 2023-02-24]
custom/3mf/mods/RemovableDoors/RemovableDoors_VHB_Left_Leaf_x1_with_Accent_MMU.3mf
44.9 x 40.0 x 10.6 mm
