cee-wals/Voron-2/custom/3mf/mods/V2.4_Bed_Wiring_Grommet.3mf

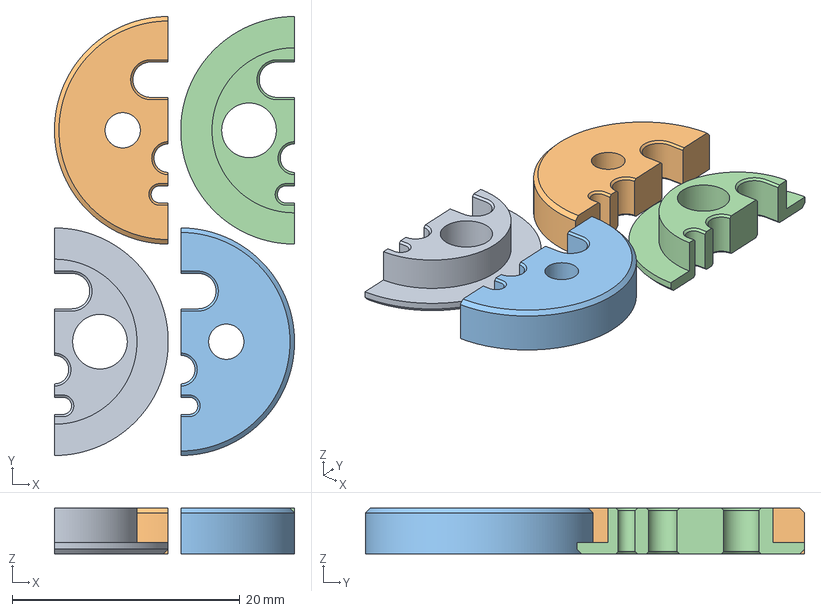
[picture p112: CAD file, 2023-02-24]
custom/3mf/mods/V2.4_Bed_Wiring_Grommet.3mf
21.1 x 38.6 x 4.00 mm
Grommet_4.stl
grommet_1.stl
Grommet_2.stl
Grommet_3.stl
