cee-wals/Voron-2/custom/3mf/success/RockNRoll/[a]_z_drive_baseplate_a_b_rnl_mod_r2.3mf

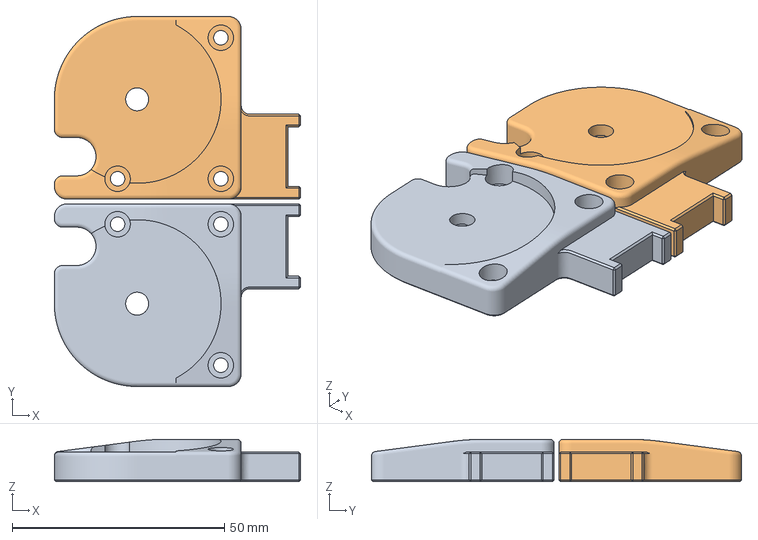
[picture p113: CAD file, 2023-02-24]
custom/3mf/success/RockNRoll/[a]_z_drive_baseplate_a_b_rnl_mod_r2.3mf
58.0 x 87.1 x 10.0 mm
[a]_z_drive_baseplate_a_rnl_mod_r2.stl
[a]_z_drive_baseplate_b_rnl_mod_r2.stl
