cee-wals/Voron-2/custom/3mf/success/z_joint_upper_hall_effect.3mf

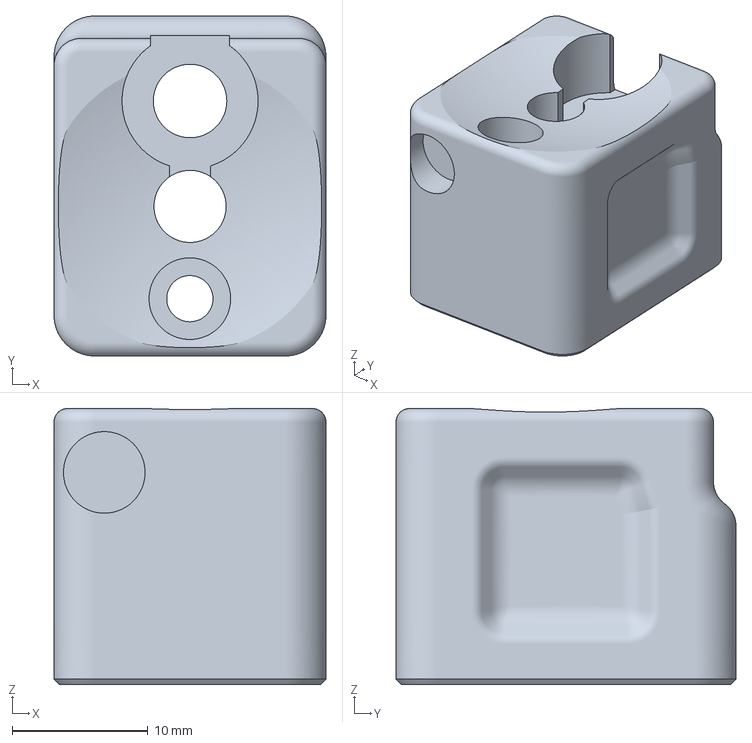
[picture p114: CAD file, 2022-12-21]
custom/3mf/success/z_joint_upper_hall_effect.3mf
20.0 x 25.0 x 20.3 mm
