cee-wals/Voron-2/custom/mods/Angry_CAM_USB /CAD/Front_Cover_120+.step

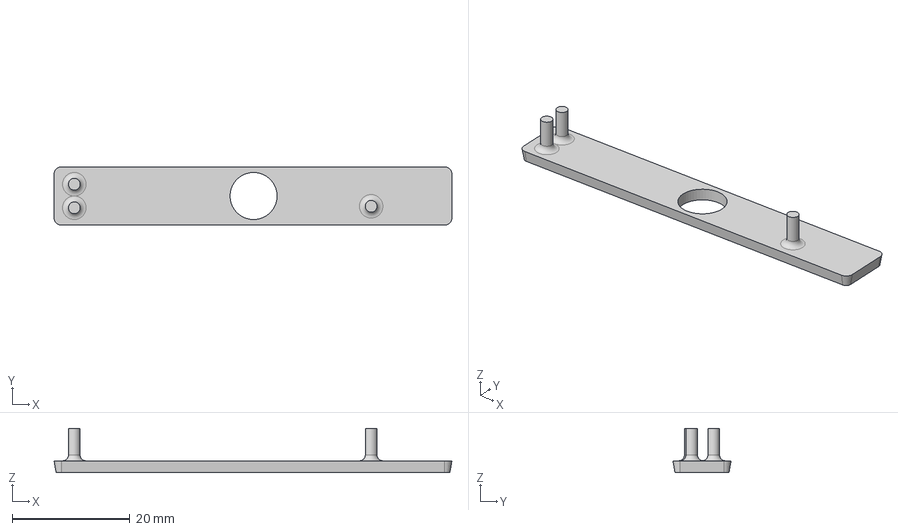
[picture p115: CAD file, 2023-02-24]
custom/mods/Angry_CAM_USB /CAD/Front_Cover_120+.step
67.7 x 9.91 x 7.50 mm
