cee-wals/Voron-2/custom/mods/RemovableDoors/STL/Backplate_x4.stl

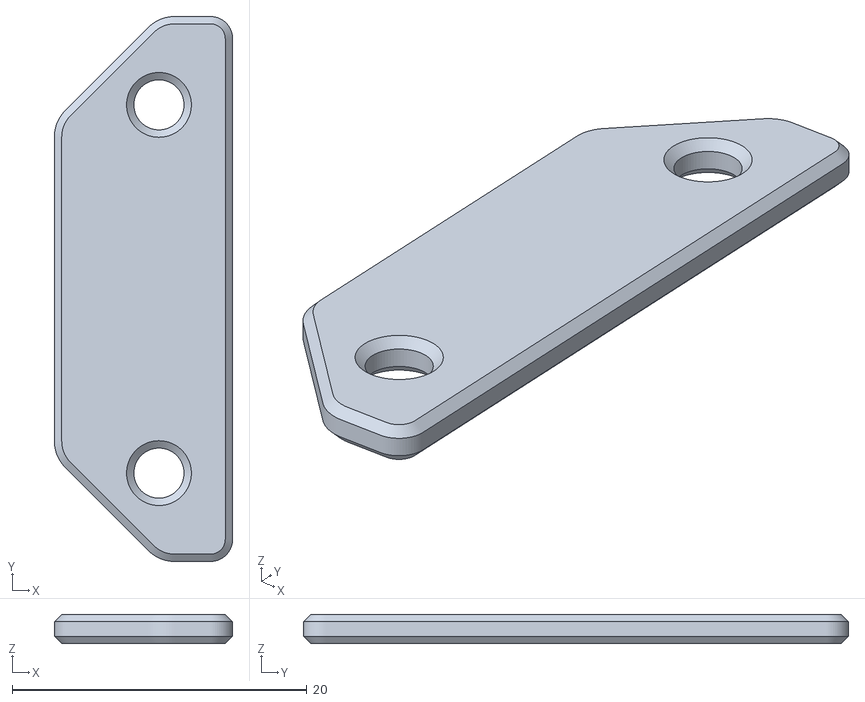
[picture p119: CAD file, 2023-02-24]
custom/mods/RemovableDoors/STL/Backplate_x4.stl
12.1 x 37.0 x 2.00
