cee-wals/Voron-2/custom/mods/voron-v2-bed-level-camera-model_files/Front Cover.stl

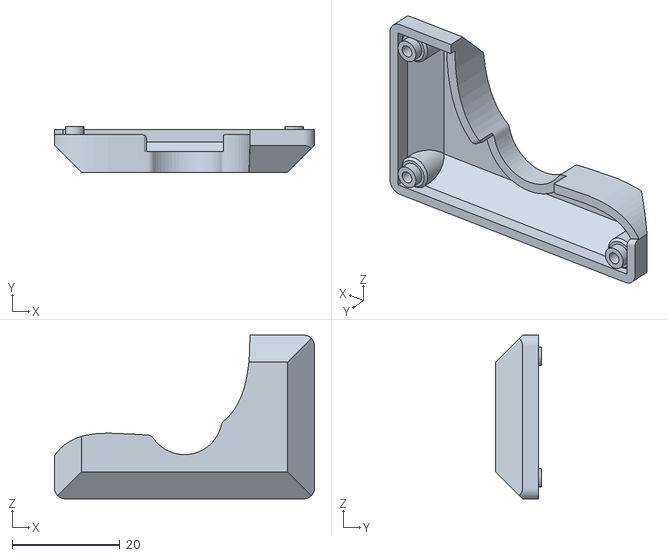
[picture p120: CAD file, 2026-08-27]
custom/mods/voron-v2-bed-level-camera-model_files/Front Cover.stl
48.4 x 8.50 x 30.4
