cee-wals/Voron-2/custom/mods/vz-nocturne-usb-cam-mount-model_files/case-single-body-multicolor.stl

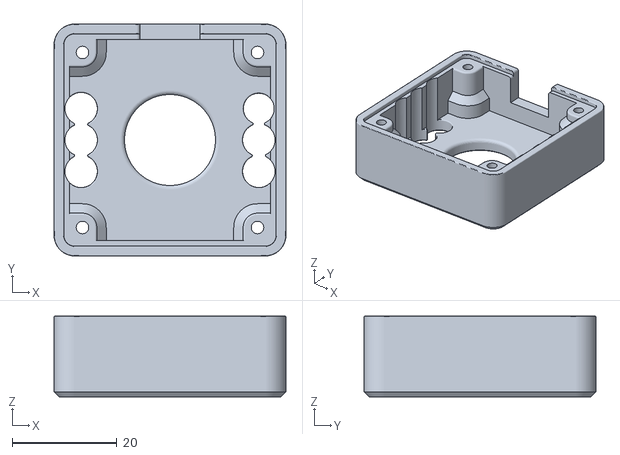
[picture p121: CAD file, 2026-08-27]
custom/mods/vz-nocturne-usb-cam-mount-model_files/case-single-body-multicolor.stl
44.4 x 44.4 x 15.5
