cee-wals/Voron-2/custom/tools/Belt_Tension_Meter/Belt_Tension_Meter_90mm.3mf

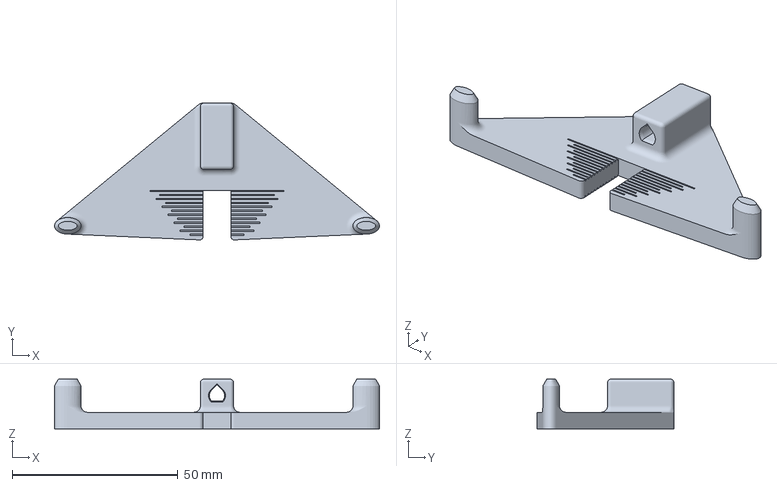
[picture p123: CAD file, 2022-12-21]
custom/tools/Belt_Tension_Meter/Belt_Tension_Meter_90mm.3mf
98.0 x 41.3 x 15.0 mm
