cee-wals/Voron-2/custom/voronica/test-prints/EM_Cubes_x9.3mf

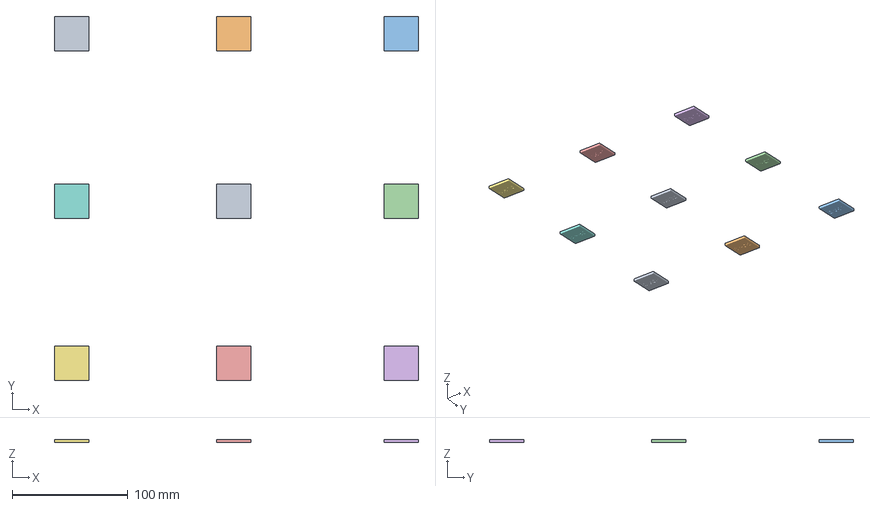
[picture p124: CAD file, 2026-08-27]
custom/voronica/test-prints/EM_Cubes_x9.3mf
315.0 x 315.0 x 3.00 mm
EM_Cube-1.000.stl
EM_Cube-0.995.stl
EM_Cube-0.990.stl
EM_Cube-0.985.stl
EM_Cube-0.980.stl
EM_Cube-0.975.stl
EM_Cube-0.970.stl
EM_Cube-0.965.stl
EM_Cube-0.960.stl
