cee-wals/Voron-2/custom/voronica/vornica-v2.5201-nameplate/V2.5201-NoLogo.stl

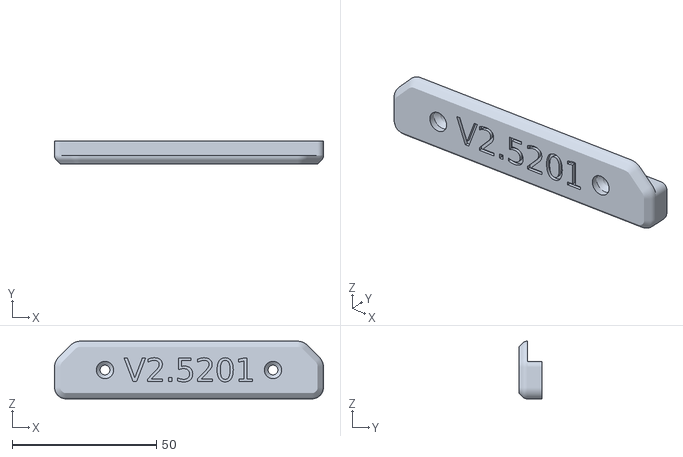
[picture p125: CAD file, 2026-08-27]
custom/voronica/vornica-v2.5201-nameplate/V2.5201-NoLogo.stl
93.2 x 8.00 x 20.0
