cee-wals/Voron-2/custom/3mf/in-progress/filter/[a]_exhaust_filter_mount_x2.3mf

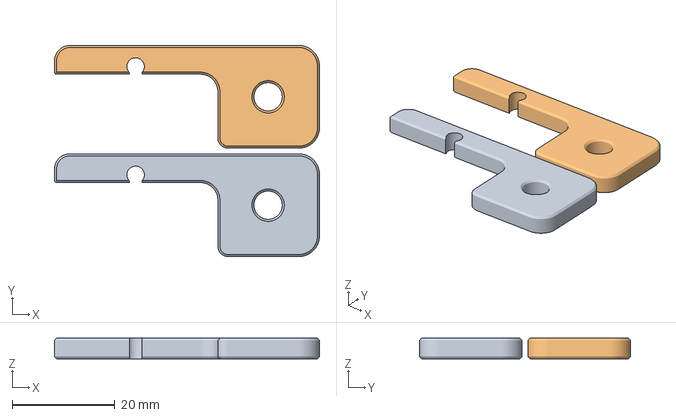
[picture p126: CAD file, 2022-12-27]
custom/3mf/in-progress/filter/[a]_exhaust_filter_mount_x2.3mf
51.6 x 41.1 x 4.00 mm
