cee-wals/Voron-2/custom/3mf/in-progress/panel/probe_retainer_bracket_9mm.3mf

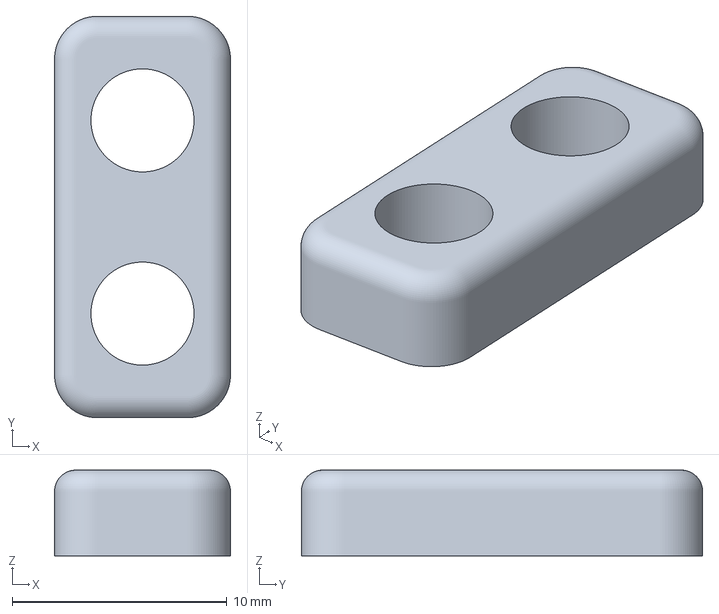
[picture p127: CAD file, 2022-12-13]
custom/3mf/in-progress/panel/probe_retainer_bracket_9mm.3mf
8.20 x 18.7 x 4.00 mm
