cee-wals/Voron-2/custom/3mf/in-progress/skirt/side_skirt_a_350_x2.3mf

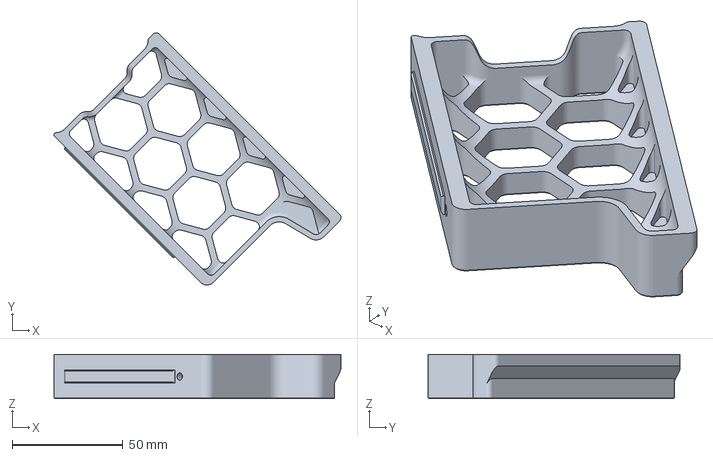
[picture p128: CAD file, 2022-12-27]
custom/3mf/in-progress/skirt/side_skirt_a_350_x2.3mf
129.4 x 113.7 x 20.0 mm
