cee-wals/Voron-2/custom/3mf/mods/Angry_CAM_USB/Angry_CAM_Front_120+_MMU_accented.3mf

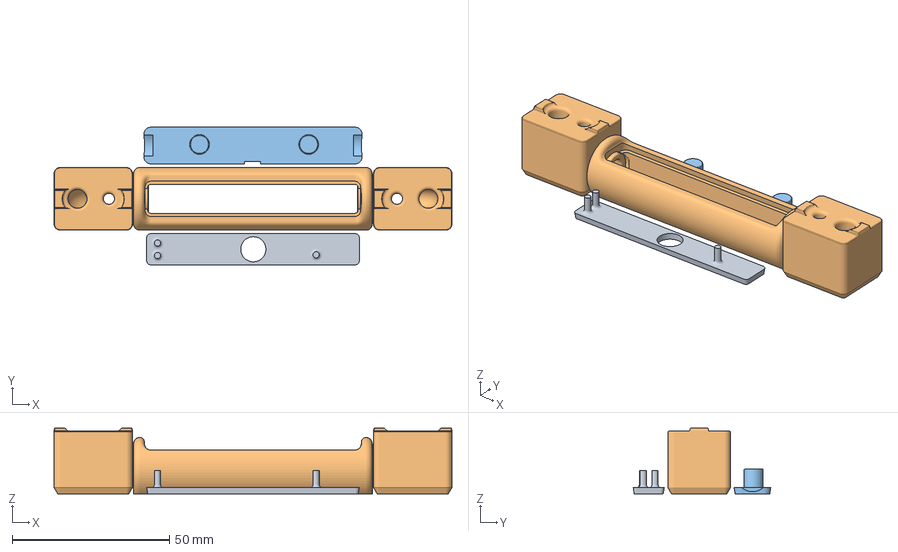
[picture p129: CAD file, 2023-02-24]
custom/3mf/mods/Angry_CAM_USB/Angry_CAM_Front_120+_MMU_accented.3mf
126.7 x 43.8 x 21.0 mm
Front_Cover_120+.stl
Angry_CAM_Front_Mount.stl
Rear_Cover_120+.stl
