cee-wals/Voron-2/custom/3mf/mods/Panel_snap_latches/SnapLatch-4.0mm-x12.3mf

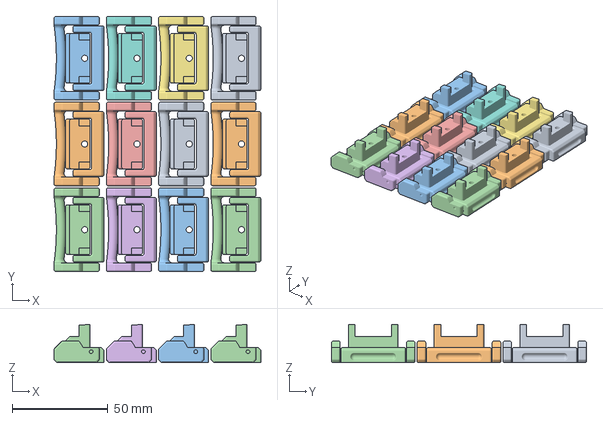
[picture p130: CAD file, 2023-02-24]
custom/3mf/mods/Panel_snap_latches/SnapLatch-4.0mm-x12.3mf
107.9 x 133.0 x 19.9 mm
