cee-wals/Voron-2/custom/3mf/mods/RemovableDoors/RemovableDoors_VHB_With_Accent.3mf

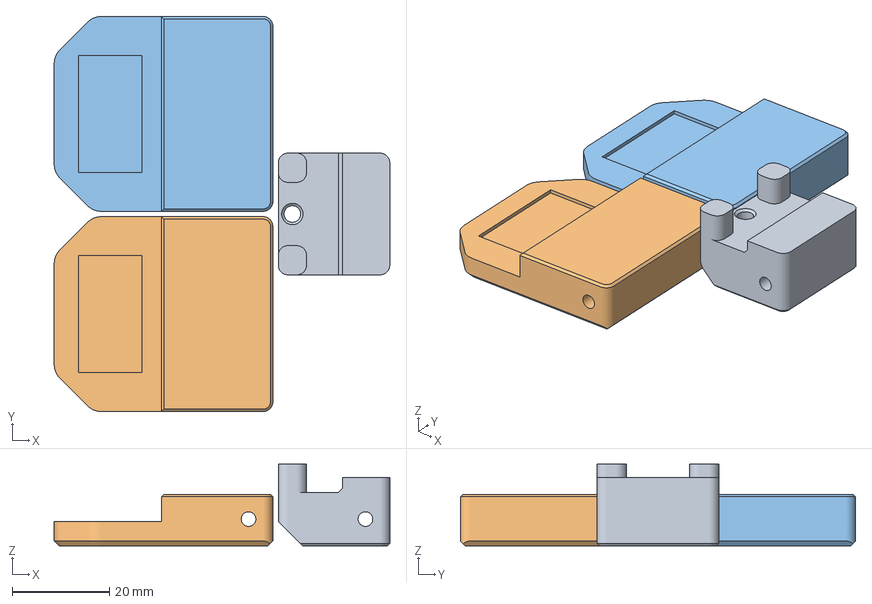
[picture p131: CAD file, 2023-02-24]
custom/3mf/mods/RemovableDoors/RemovableDoors_VHB_With_Accent.3mf
68.9 x 81.1 x 16.8 mm
Hinge_x4.stl
Left_Leaf_VHB_With_Accent_x2.stl
Right_Leaf_VHB_With_Accent_x2.stl
