cee-wals/Voron-2/custom/3mf/success/RockNRoll/rocker_braces_left_right.3mf

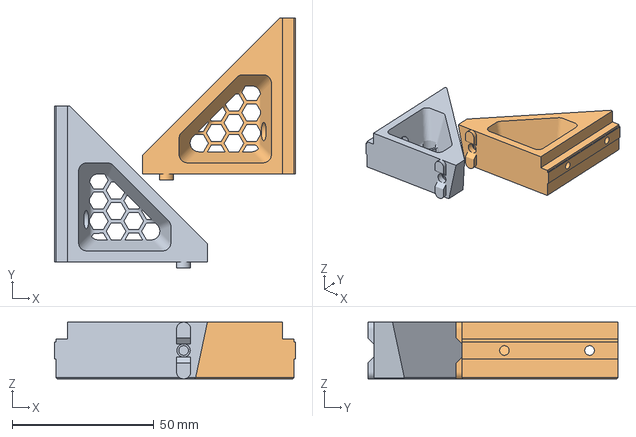
[picture p132: CAD file, 2023-02-24]
custom/3mf/success/RockNRoll/rocker_braces_left_right.3mf
84.9 x 88.0 x 20.0 mm
rocker_right_brace.stl
rocker_left_brace.stl
