cee-wals/Voron-2/custom/3mf/success/tools-pulley_jig.3mf

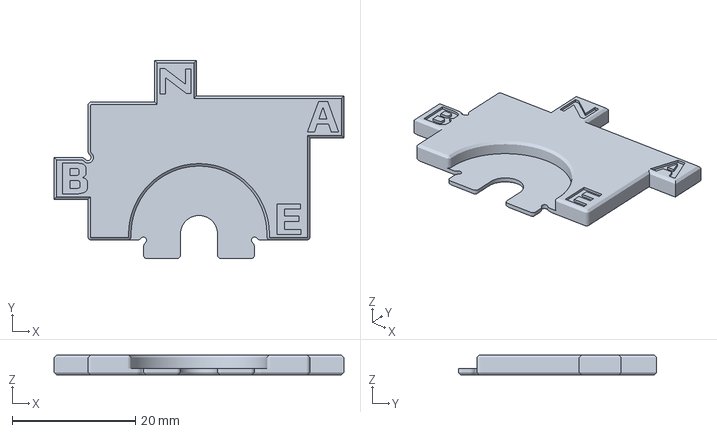
[picture p133: CAD file, 2022-12-21]
custom/3mf/success/tools-pulley_jig.3mf
47.0 x 32.2 x 3.20 mm
