cee-wals/Voron-2/custom/mods/Clip-On_Front_Door_Frame /STLs/250mm_angle_frame_2_x2.stl

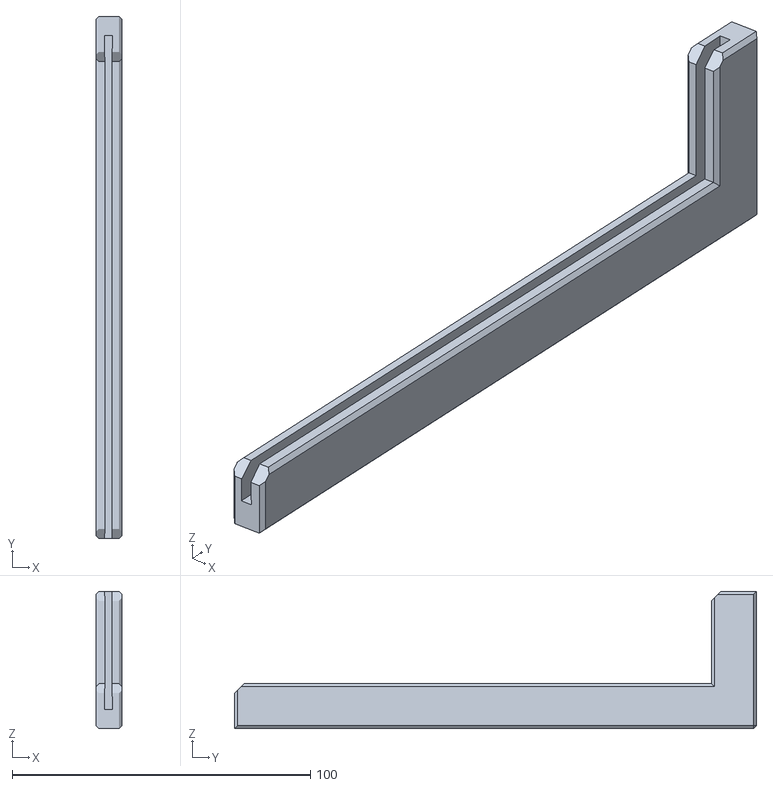
[picture p134: CAD file, 2023-02-24]
custom/mods/Clip-On_Front_Door_Frame /STLs/250mm_angle_frame_2_x2.stl
8.73 x 175.0 x 46.0
