cee-wals/Voron-2/custom/mods/RemovableDoors/STL/Right_Leaf_With_Accent_x2.stl

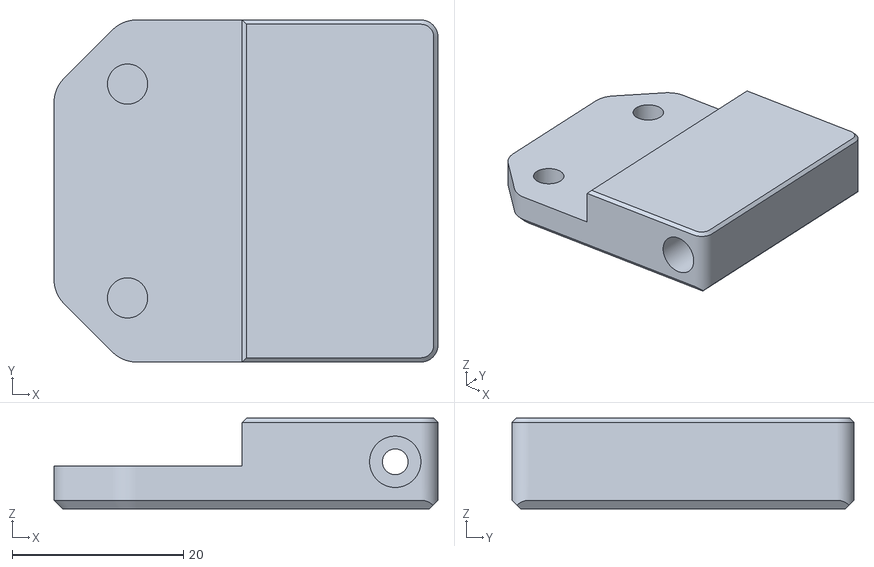
[picture p136: CAD file, 2023-02-24]
custom/mods/RemovableDoors/STL/Right_Leaf_With_Accent_x2.stl
44.9 x 40.0 x 10.6
