cee-wals/Voron-2/custom/mods/voron-v2-bed-level-camera-model_files/Extrusion Mount - No Kinematics.stl

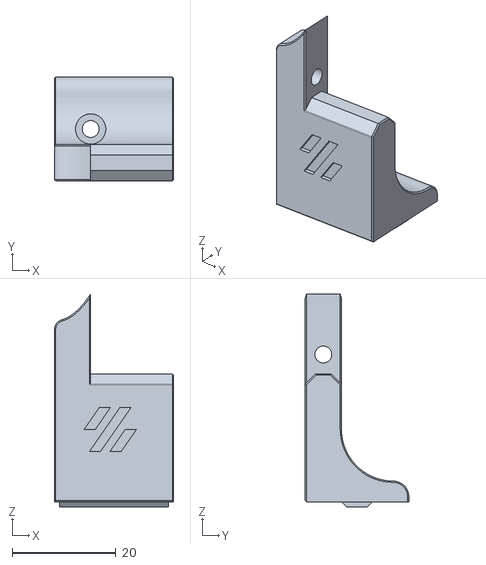
[picture p137: CAD file, 2026-08-27]
custom/mods/voron-v2-bed-level-camera-model_files/Extrusion Mount - No Kinematics.stl
23.0 x 20.0 x 41.1
