cee-wals/Voron-2/custom/mods/vz-nocturne-usb-cam-mount-model_files/case-inlay-inner.stl

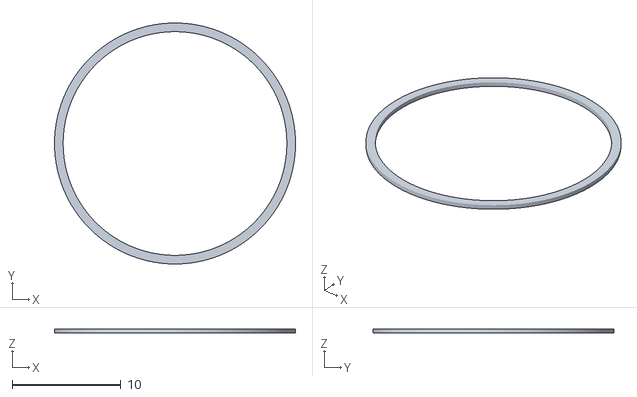
[picture p138: CAD file, 2026-08-27]
custom/mods/vz-nocturne-usb-cam-mount-model_files/case-inlay-inner.stl
22.2 x 22.2 x 0.4
