cee-wals/Voron-2/custom/tools/Bed_Support_Alignment_Tools/Bed_Support_Alignment_Tool_Center_250_300_350_x2.stl

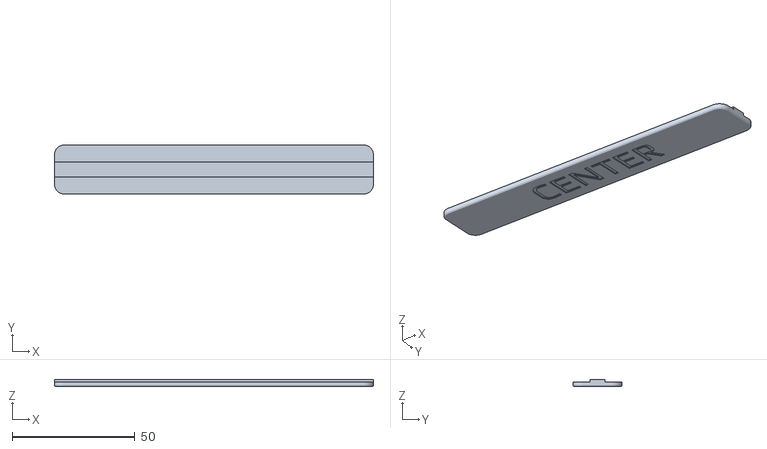
[picture p139: CAD file, 2022-12-27]
custom/tools/Bed_Support_Alignment_Tools/Bed_Support_Alignment_Tool_Center_250_300_350_x2.stl
130.0 x 20.0 x 2.99
