cee-wals/Voron-2/custom/tools/Belt_Tension_Meter/Belt_Tension_Meter_stick_and_finger.3mf

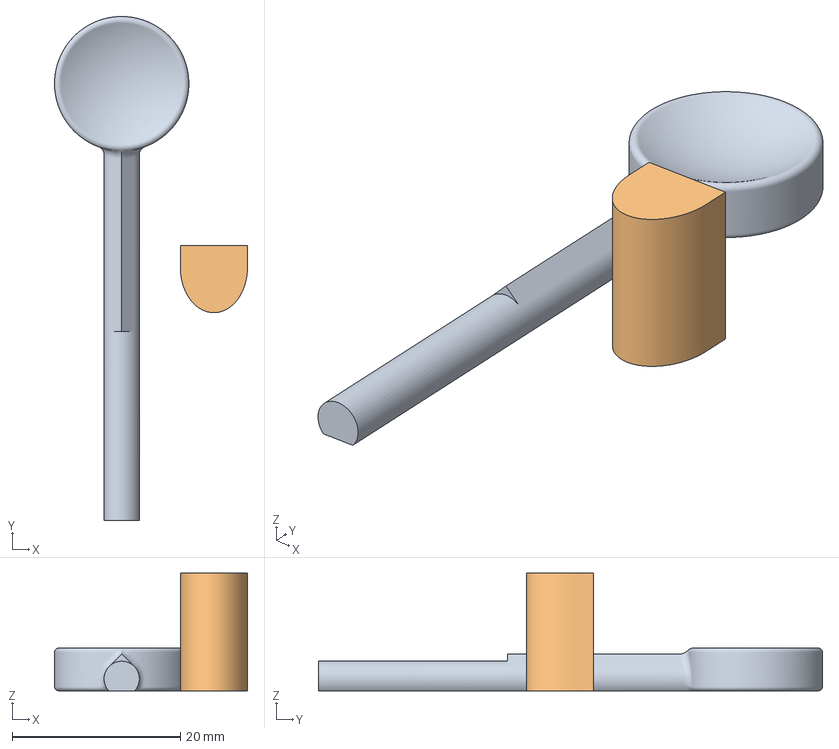
[picture p140: CAD file, 2022-12-21]
custom/tools/Belt_Tension_Meter/Belt_Tension_Meter_stick_and_finger.3mf
23.0 x 60.0 x 14.0 mm
Belt_Tension_Meter_stick.STL
Belt_Tension_Meter_finger.STL
