cee-wals/Voron-2/custom/voronica/test-prints/Filament_Card_PLA.3mf

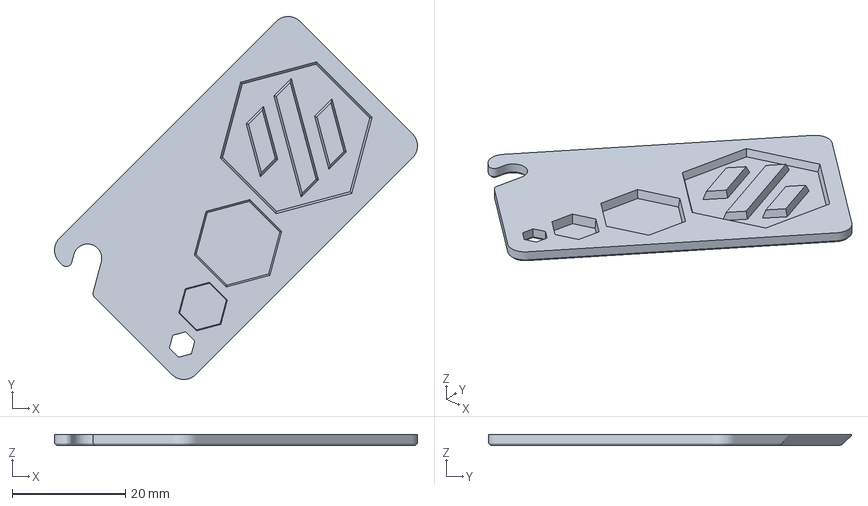
[picture p141: CAD file, 2026-08-27]
custom/voronica/test-prints/Filament_Card_PLA.3mf
64.0 x 64.0 x 2.00 mm
