cee-wals/Voron-2/custom/3mf/in-progress/filter/exhaust_filter_grill.3mf

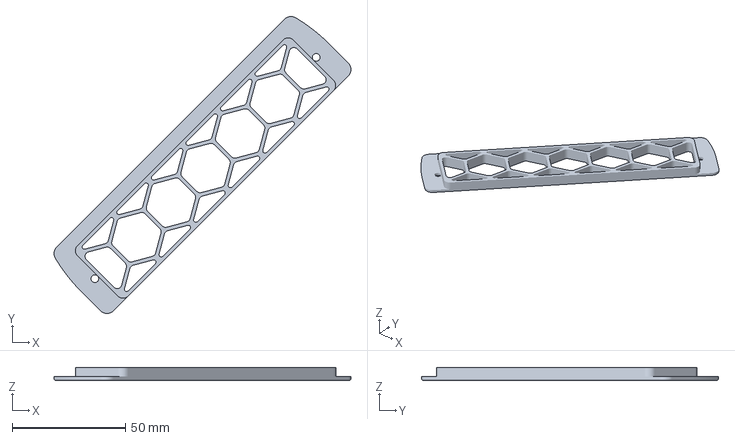
[picture p142: CAD file, 2022-12-27]
custom/3mf/in-progress/filter/exhaust_filter_grill.3mf
131.2 x 131.2 x 5.60 mm
