cee-wals/Voron-2/custom/3mf/in-progress/panel/panel_mounting_doors.3mf

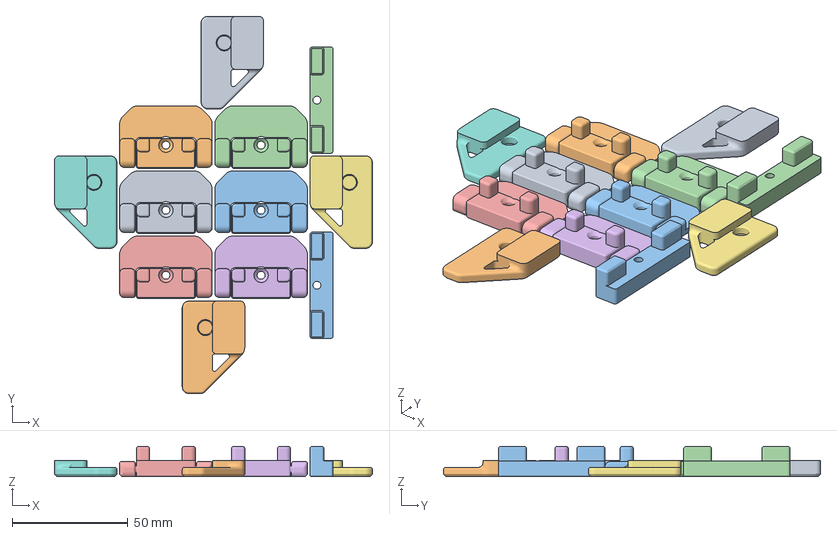
[picture p143: CAD file, 2022-11-11]
custom/3mf/in-progress/panel/panel_mounting_doors.3mf
137.3 x 162.9 x 13.0 mm
door_hinge_x6.stl
handle_a_x2.stl
handle_b_x2.stl
latch_x2.stl
