cee-wals/Voron-2/custom/3mf/mods/2020_Profile_Cover__x4.3mf

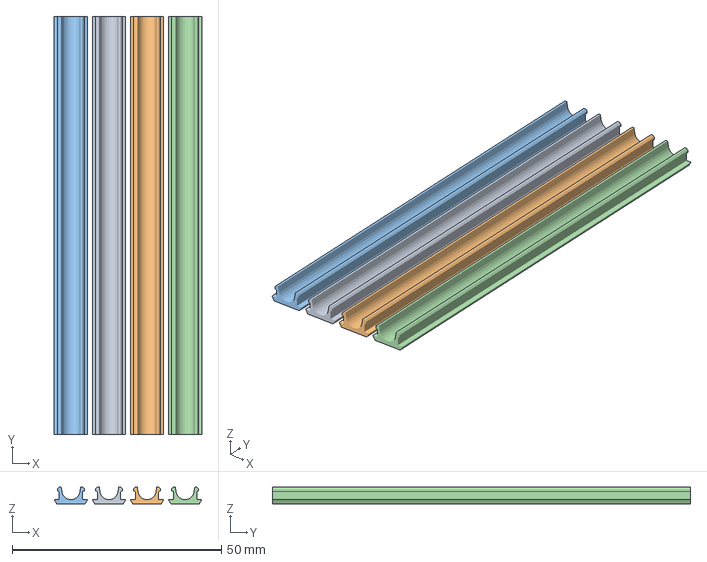
[picture p144: CAD file, 2023-02-24]
custom/3mf/mods/2020_Profile_Cover__x4.3mf
35.3 x 100.0 x 4.00 mm
