cee-wals/Voron-2/custom/mods/Angry_CAM_USB /CAD/Rear_Cover.step

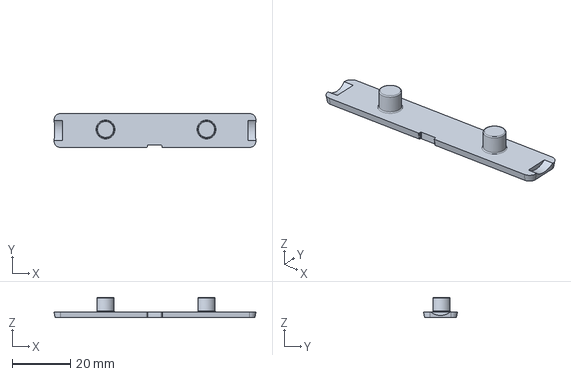
[picture p145: CAD file, 2023-02-24]
custom/mods/Angry_CAM_USB /CAD/Rear_Cover.step
69.5 x 11.7 x 7.00 mm
