cee-wals/Voron-2/custom/mods/Clip-On_Front_Door_Frame /STLs/350mm_angle_frame_1_x2.stl

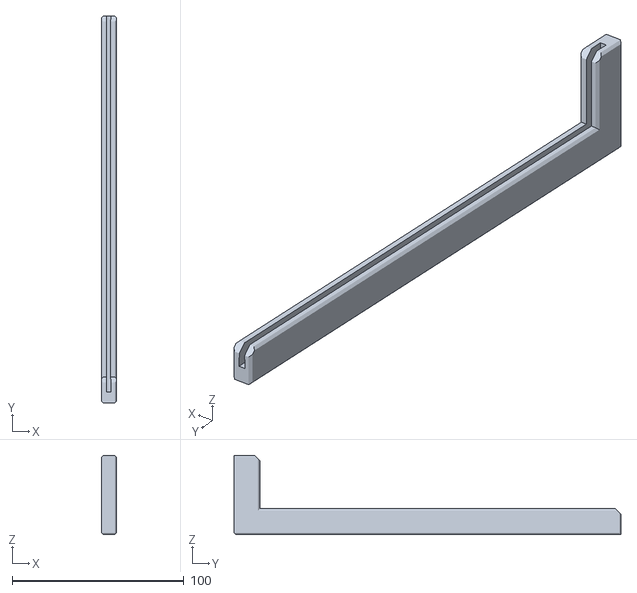
[picture p146: CAD file, 2023-02-24]
custom/mods/Clip-On_Front_Door_Frame /STLs/350mm_angle_frame_1_x2.stl
8.73 x 225.0 x 46.0
