cee-wals/Voron-2/custom/mods/RemovableDoors/STL/Left_Leaf_x2.stl

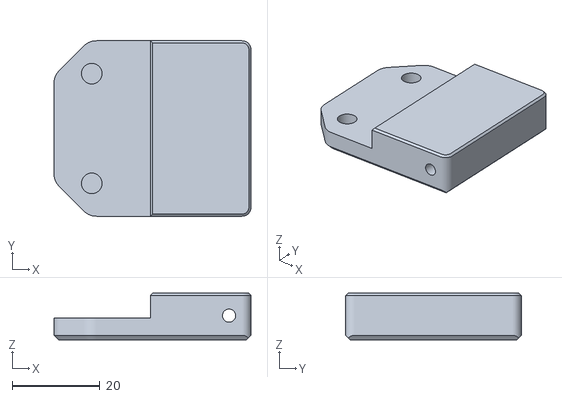
[picture p148: CAD file, 2023-02-24]
custom/mods/RemovableDoors/STL/Left_Leaf_x2.stl
44.9 x 40.0 x 10.6
