cee-wals/Voron-2/custom/mods/vz-nocturne-usb-cam-mount-model_files/back-plate-logo-2.stl

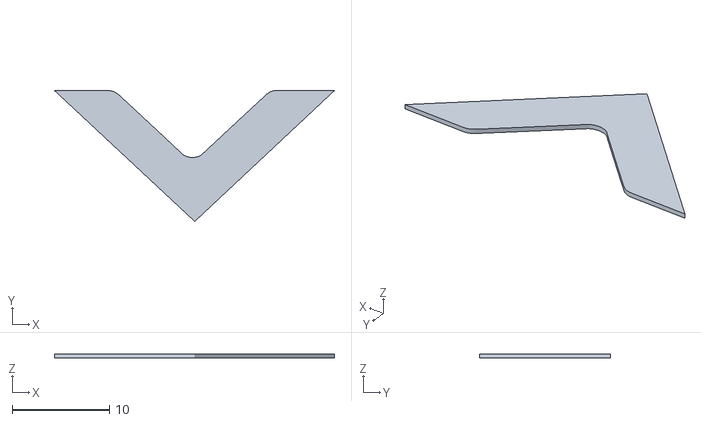
[picture p149: CAD file, 2026-08-27]
custom/mods/vz-nocturne-usb-cam-mount-model_files/back-plate-logo-2.stl
28.8 x 13.5 x 0.4
