cee-wals/Voron-2/custom/voronica/test-prints/Filament_Card_Caddy_25.stl

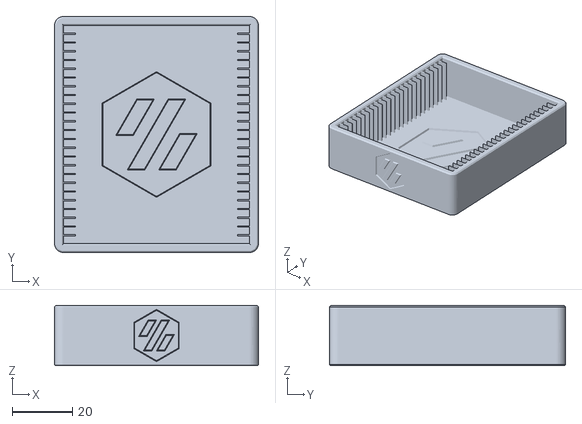
[picture p150: CAD file, 2026-08-27]
custom/voronica/test-prints/Filament_Card_Caddy_25.stl
67.5 x 78.1 x 20.0
