cee-wals/Voron-2/(list of files, cad)

Other CAD files:
custom/3mf/success/z_drive_main_a_x2.3mf
custom/mods/RockNRoll/CAD/6mm_panels/rocker_right_6mm.stp
custom/mods/Angry_CAM_USB /CAD/Angry_CAM_Bottom_Mount.step
custom/mods/Hidden_cable_routing_z_belt_cover /cad/cable_routing_z_belt_cover_b_mod.step
custom/mods/RockNRoll/CAD/6mm_panels/rocker_right_brace_6mm.stp
custom/mods/RockNRoll/CAD/base_plate_left_r1.stp
custom/voronica/vornica-v2.5201-nameplate/V2.5201_multicolor.3mf
custom/mods/gantry-installation-hook.stl
custom/mods/RockNRoll/CAD/6mm_panels/rocker_left_6mm.stp
custom/mods/RockNRoll/CAD/base_plate_right_r1.stp
custom/mods/RockNRoll/STLs/[a]_z_drive_baseplate_b_rnl_mod_r1.stl
custom/mods/V2.4_Bed_Wiring_Grommet/Grommet_3.stl
custom/3mf/mods/top_corner_cable_cover_with_drop_holes.3mf
custom/mods/Angry_CAM_USB /CAD/Angry_CAM_Top_Mount.step
custom/mods/RockNRoll/CAD/6mm_panels/rocker_left_brace_6mm.stp
custom/mods/RockNRoll/CAD/rocker_left.stp
custom/mods/RockNRoll/STLs/[a]_z_drive_baseplate_a_rnl_mod_r2.stl
custom/mods/V2.4_Bed_Wiring_Grommet/Grommet_2.stl
custom/3mf/in-progress/skirt/side_skirt_b_350_x2.3mf
custom/3mf/mods/RemovableDoors/RemovableDoors_VHB_Right_Leaf_x1_with_Accent_MMU.3mf
custom/3mf/success/RockNRoll/rocker_left_brace.3mf
custom/mods/RockNRoll/CAD/base_plate_b_r2.stp
custom/3mf/in-progress/panel/panel_mounting_set1.3mf
custom/3mf/in-progress/panel/panel_mounting_set2.3mf
custom/3mf/in-progress/skirt/front_skirt_b_350.3mf
custom/3mf/in-progress/skirt/side_fan_support_x2.3mf
custom/3mf/in-progress/z-stop-sex-bolts-mods.3mf
custom/3mf/mods/LED_Bar_Clip_Misumi_version2_x2.3mf
custom/3mf/mods/RemovableDoors/RemovableDoors_VHB_Leaf_with_Accent.3mf
custom/3mf/mods/RemovableDoors/RemovableDoors_VHB_Leaf_with_Accent_MMU.3mf
custom/3mf/success/AB-drive-a_drive_frame_lower.3mf
custom/3mf/success/AB-drive-a_drive_frame_upper.3mf
custom/3mf/success/AB-drive-b_drive_frame_lower.3mf
custom/3mf/success/AB-drive-b_drive_frame_upper.3mf
custom/3mf/success/RockNRoll/rocker_right.3mf
custom/3mf/success/[a]_AB-drive-cable_cover.3mf
custom/3mf/success/[a]_AB-drive-z_chain_retainer_bracket_x2.3mf
custom/3mf/success/[a]_endstop_pod_D2F_switch.3mf
custom/3mf/success/[a]_endstop_pod_hall_effect.3mf
custom/3mf/success/[a]_front-idlers-tensioners_left.3mf
custom/3mf/success/[a]_front-idlers-tensioners_right.3mf
custom/3mf/success/[a]_mini12864_case_hinge.3mf
custom/3mf/success/[a]_skirts_belt_guard_a_b.3mf
custom/3mf/success/[a]_skirts_electronics_panel_parts.3mf
custom/3mf/success/[a]_skirts_fan_grill_a_b.3mf
custom/3mf/success/[a]_skirts_fan_grill_open_optional.3mf
custom/3mf/success/[a]_skirts_fan_grill_retainer.3mf
custom/3mf/success/[a]_xy_joint_cable_bridge_2hole.3mf
custom/3mf/success/[a]_xy_joint_cable_bridge_3hole.3mf
custom/3mf/success/[a]_z_drive_baseplate_a_x2.3mf
custom/3mf/success/[a]_z_drive_baseplate_b.3mf
custom/3mf/success/[a]_z_drive_baseplate_b_x2.3mf
custom/3mf/success/[a]_z_drive_belt_tensioner_a_x2.3mf
custom/3mf/success/[a]_z_drive_belt_tensioner_b_x2.3mf
custom/3mf/success/[a]_z_tensioner_x4_9mm.3mf
custom/3mf/success/blower_housing_rear.3mf
custom/3mf/success/front-idler_left.3mf
custom/3mf/success/front-idler_left_lower.3mf
custom/3mf/success/front-idler_left_upper.3mf
custom/3mf/success/front-idler_right.3mf
custom/3mf/success/front-idler_right_lower.3mf
custom/3mf/success/front-idler_right_upper.3mf
custom/3mf/success/hotend_fan_mount.3mf
custom/3mf/success/xy_joint_left_lower_MGN12.3mf
custom/3mf/success/xy_joint_left_upper_MGN12.3mf
custom/3mf/success/xy_joint_right_lower_MGN12.3mf
custom/3mf/success/xy_joint_right_upper_MGN12.3mf
custom/3mf/success/z_drive_motor_mount_a_b.3mf
custom/3mf/success/z_drive_retainer_a_x2.3mf
custom/3mf/success/z_drive_retainer_b_x2.3mf
custom/3mf/success/z_endstop_nozzle_probe.3mf
custom/3mf/success/z_joint_lower_x4.3mf
custom/3mf/success/z_joint_upper_x4.3mf
custom/3mf/success/z_tensioner_bracket_a_x2.3mf
custom/3mf/success/z_tensioner_bracket_b_x2.3mf
custom/mods/20x20mm_Profile_Covers /STL/2020_Profile_Cover.stl
custom/mods/20x20mm_Profile_Covers /STL/2020_Stealth_Profile_Cover.stl
custom/mods/Angry_CAM_USB /CAD/Front_Cover.step
custom/mods/Angry_CAM_USB /CAD/Rear_Cover_120+.step
custom/mods/Angry_CAM_USB /STL/Angry_CAM_Bottom_Mount.stl
custom/mods/Angry_CAM_USB /STL/Angry_CAM_Front_Mount.stl
custom/mods/Angry_CAM_USB /STL/Angry_CAM_Top_Mount.stl
custom/mods/Angry_CAM_USB /STL/Front_Cover.stl
custom/mods/Angry_CAM_USB /STL/Front_Cover_120+.stl
custom/mods/Angry_CAM_USB /STL/Rear_Cover.stl
custom/mods/Angry_CAM_USB /STL/Rear_Cover_120+.stl
custom/mods/CableGator-Cable-Comb /F3D/CableGator.f3d
custom/mods/Clip-On_Front_Door_Frame /STLs/250mm_angle_frame_1_x2.stl
custom/mods/Clip-On_Front_Door_Frame /STLs/250mm_straight_frame_long_x2.stl
custom/mods/Clip-On_Front_Door_Frame /STLs/250mm_straight_frame_short_x4.stl
custom/mods/Clip-On_Front_Door_Frame /STLs/300mm_angle_frame_1_x2.stl
custom/mods/Clip-On_Front_Door_Frame /STLs/300mm_angle_frame_2_x2.stl
custom/mods/Clip-On_Front_Door_Frame /STLs/300mm_straight_frame_long_x2.stl
custom/mods/Clip-On_Front_Door_Frame /STLs/350mm_angle_frame_2_x2.stl
custom/mods/Clip-On_Front_Door_Frame /STLs/350mm_straight_frame_long_x2.stl
custom/mods/Corner_Cable_Cover_with_Drop_Holes /STL/top_corner_cable_cover_with_drop_holes.stl
custom/mods/Exhaust_cover_SFS/CAD/Exhaust_cover_SFS.f3d
custom/mods/Hidden_cable_routing_z_belt_cover /stl/cable_routing_z_belt_cover_a_mod.stl
custom/mods/Hidden_cable_routing_z_belt_cover /stl/cable_routing_z_belt_cover_b_mod.stl
custom/mods/LED_Bar_Clip/LED_Bar_Clip_Misumi_version2.f3d
custom/mods/LED_Bar_Clip/LED_Bar_Clip_Misumi_version2.step
custom/mods/LED_Bar_Clip/LED_Bar_Clip_Misumi_version2.stl
custom/mods/MRW_Kinematic_Sexbolt_Mount/SexboltBodyHexBacker.stl
custom/mods/MRW_Kinematic_Sexbolt_Mount/SexboltBodyHexBrace.stl
custom/mods/Misumi_Cable_Clip.stl
custom/mods/Printable_snaplatches_for_2020_extrusion/CAD/NewLatch v108.f3d
custom/mods/Printable_snaplatches_for_2020_extrusion/STL/NewLatch-3.0mm.stl
custom/mods/Printable_snaplatches_for_2020_extrusion/STL/NewLatch-3.5mm.stl
custom/mods/Printable_snaplatches_for_2020_extrusion/STL/NewLatch-4.0mm.stl
custom/mods/Printable_snaplatches_for_2020_extrusion/STL/NewLatch-6.0mm.stl
custom/mods/Printable_snaplatches_for_2020_extrusion/STL/NewLatch-6.5mm.stl
custom/mods/Printable_snaplatches_for_2020_extrusion/STL/NewLatch-7.5mm.stl
custom/mods/Printable_snaplatches_for_2020_extrusion/STL/NewLatch-8.0mm.stl
custom/mods/RemovableDoors/STL/Hinge_x4.stl
custom/mods/RemovableDoors/STL/Left_Leaf_VHB_With_Accent_x2.stl
custom/mods/RemovableDoors/STL/Left_Leaf_VHB_x2.stl
custom/mods/RemovableDoors/STL/Left_Leaf_With_Accent_x2.stl
custom/mods/RemovableDoors/STL/Right_Leaf_VHB_With_Accent_x2.stl
custom/mods/RemovableDoors/STL/Right_Leaf_VHB_x2.stl
custom/mods/RemovableDoors/STL/Right_Leaf_x2.stl
custom/mods/RemovableDoors/STL/mod_6x3_handle_a_small.stl
custom/mods/RockNRoll/CAD/base_plate_a_r2.stp
custom/mods/RockNRoll/CAD/rocker_left_brace.stp
custom/mods/RockNRoll/CAD/rocker_right.stp
custom/mods/RockNRoll/STLs/6mm_panels/rocker_left_6mm.stl
custom/mods/RockNRoll/STLs/6mm_panels/rocker_left_brace_6mm.stl
custom/mods/RockNRoll/STLs/6mm_panels/rocker_right_6mm.stl
custom/mods/RockNRoll/STLs/6mm_panels/rocker_right_brace_6mm.stl
custom/mods/RockNRoll/STLs/rocker_left.stl
custom/mods/RockNRoll/STLs/rocker_left_brace.stl
custom/mods/RockNRoll/STLs/rocker_right.stl
custom/mods/RockNRoll/STLs/rocker_right_brace.stl
custom/mods/Sturdy_Handles/CAD/sturdy_handles.f3d
custom/mods/Sturdy_Handles/STL/sturdy_handles.stl
custom/mods/V2.4_handle/STL/[a]_handle_middle_part.stl
custom/mods/Voron2.4_SexBolt_ZEndstop/CAD/V2_SexBolt_Z_Endstop.step
custom/mods/Voron2.4_SexBolt_ZEndstop/STLs/EndstopHousingBlank.stl
custom/mods/Voron2.4_SexBolt_ZEndstop/STLs/EndstopHousingPissedOff.stl
custom/mods/Voron2.4_SexBolt_ZEndstop/STLs/EndstopHousingSmile.stl
custom/mods/Voron2.4_SexBolt_ZEndstop/STLs/EndstopHousingVoronLogo.stl
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
