cee-wals/Voron-2/custom/mods/V2.4_Bed_Wiring_Grommet/readme.md

Print 4 pieces. Insert standard heatsets. Use Qty 2 M3x8 SHCS or BHCS.
Wire openings for Keenovo standard wires for the bed heater, bed thermistor, ground wire.

Image of grommet chamber side
Image of grommet elec. side
