cee-wals/Voron-2/custom/voronica/input-shaper/calibration_data_x_20230430_030122.csv

freq | psd_x | psd_y | psd_z | psd_xyz | zv(50.6) | mzv(48.0) | ei(59.8) | 2hump_ei(73.2) | 3hump_ei(89.0)
0.0 | 0.000e+00 | 0.000e+00 | 0.000e+00 | 0.000e+00 | 1.000 | 1.000 | 1.000 | 1.000 | 1.000
1.6 | 0.000e+00 | 0.000e+00 | 0.000e+00 | 0.000e+00 | 0.995 | 0.992 | 0.991 | 0.989 | 0.988
3.1 | 0.000e+00 | 0.000e+00 | 0.000e+00 | 0.000e+00 | 0.987 | 0.980 | 0.979 | 0.975 | 0.972
4.7 | 0.000e+00 | 0.000e+00 | 0.000e+00 | 0.000e+00 | 0.977 | 0.966 | 0.963 | 0.957 | 0.953
6.3 | 1.957e+02 | 5.258e+00 | 4.309e+00 | 2.053e+02 | 0.965 | 0.948 | 0.945 | 0.935 | 0.930
7.8 | 2.459e+02 | 3.758e+00 | 3.526e+00 | 2.532e+02 | 0.951 | 0.927 | 0.923 | 0.911 | 0.904
9.4 | 3.012e+02 | 3.081e+00 | 3.055e+00 | 3.073e+02 | 0.935 | 0.903 | 0.899 | 0.883 | 0.875
11.0 | 3.552e+02 | 2.832e+00 | 2.987e+00 | 3.610e+02 | 0.916 | 0.877 | 0.872 | 0.853 | 0.844
12.5 | 4.147e+02 | 2.508e+00 | 3.201e+00 | 4.205e+02 | 0.896 | 0.849 | 0.843 | 0.820 | 0.810
14.1 | 4.758e+02 | 2.327e+00 | 4.434e+00 | 4.826e+02 | 0.874 | 0.817 | 0.811 | 0.785 | 0.774
15.6 | 5.455e+02 | 2.275e+00 | 4.406e+00 | 5.522e+02 | 0.849 | 0.784 | 0.777 | 0.748 | 0.736
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
