cee-wals/Voron-2/custom/voronica/input-shaper/calibration_data_y_20230430_030122.csv

freq | psd_x | psd_y | psd_z | psd_xyz | zv(62.2) | mzv(38.8) | ei(55.4) | 2hump_ei(48.6) | 3hump_ei(48.4)
0.0 | 0.000e+00 | 0.000e+00 | 0.000e+00 | 0.000e+00 | 1.000 | 1.000 | 1.000 | 1.000 | 1.000
1.6 | 0.000e+00 | 0.000e+00 | 0.000e+00 | 0.000e+00 | 0.996 | 0.989 | 0.990 | 0.982 | 0.975
3.1 | 0.000e+00 | 0.000e+00 | 0.000e+00 | 0.000e+00 | 0.990 | 0.974 | 0.977 | 0.956 | 0.938
4.7 | 0.000e+00 | 0.000e+00 | 0.000e+00 | 0.000e+00 | 0.983 | 0.953 | 0.959 | 0.923 | 0.890
6.3 | 6.263e+00 | 1.731e+02 | 2.068e+00 | 1.814e+02 | 0.974 | 0.928 | 0.938 | 0.882 | 0.832
7.8 | 3.746e+00 | 2.306e+02 | 1.754e+00 | 2.361e+02 | 0.964 | 0.899 | 0.914 | 0.836 | 0.766
9.4 | 2.814e+00 | 2.831e+02 | 1.725e+00 | 2.876e+02 | 0.953 | 0.865 | 0.887 | 0.784 | 0.695
11.0 | 2.467e+00 | 3.543e+02 | 1.786e+00 | 3.586e+02 | 0.940 | 0.828 | 0.856 | 0.727 | 0.620
12.5 | 2.089e+00 | 4.522e+02 | 2.934e+00 | 4.572e+02 | 0.926 | 0.788 | 0.823 | 0.668 | 0.542
14.1 | 1.979e+00 | 5.446e+02 | 6.518e+00 | 5.531e+02 | 0.910 | 0.744 | 0.787 | 0.606 | 0.465
15.6 | 1.956e+00 | 6.308e+02 | 6.329e+00 | 6.391e+02 | 0.893 | 0.698 | 0.749 | 0.543 | 0.390
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
