cee-wals/Voron-2/custom/voronica/input-shaper/shaper_calibrate_x__20230302_091946.png

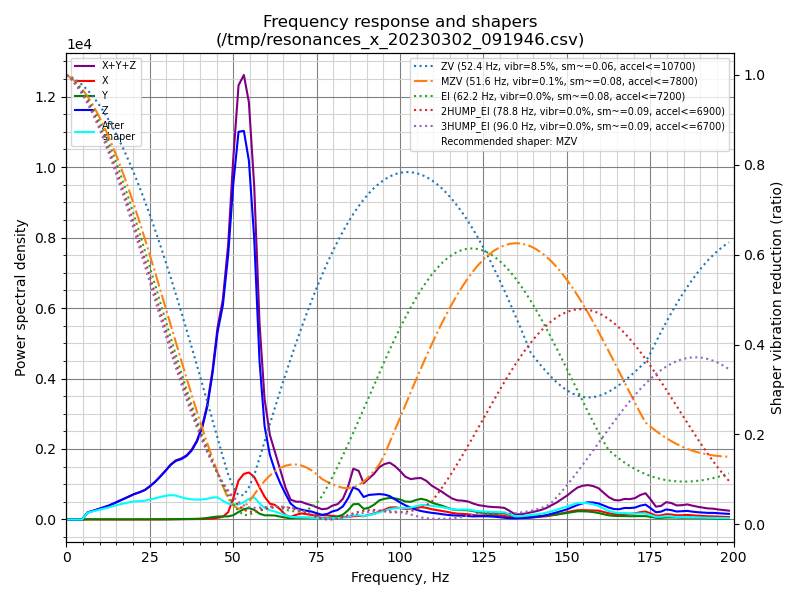
custom/voronica/input-shaper/shaper_calibrate_x__20230302_091946.png
