cee-wals/Voron-2/custom/voronica/input-shaper/shaper_calibrate_y_2023-04-30__03:25:32.png

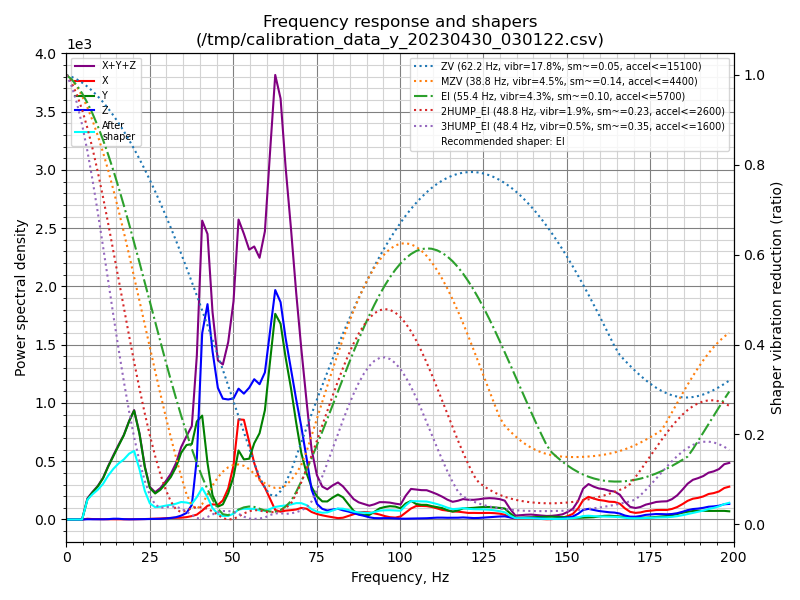
custom/voronica/input-shaper/shaper_calibrate_y_2023-04-30__03:25:32.png
