cee-wals/Voron-2/custom/voronica/input-shaper/shaper_calibrate_y__20230302_0923586.png

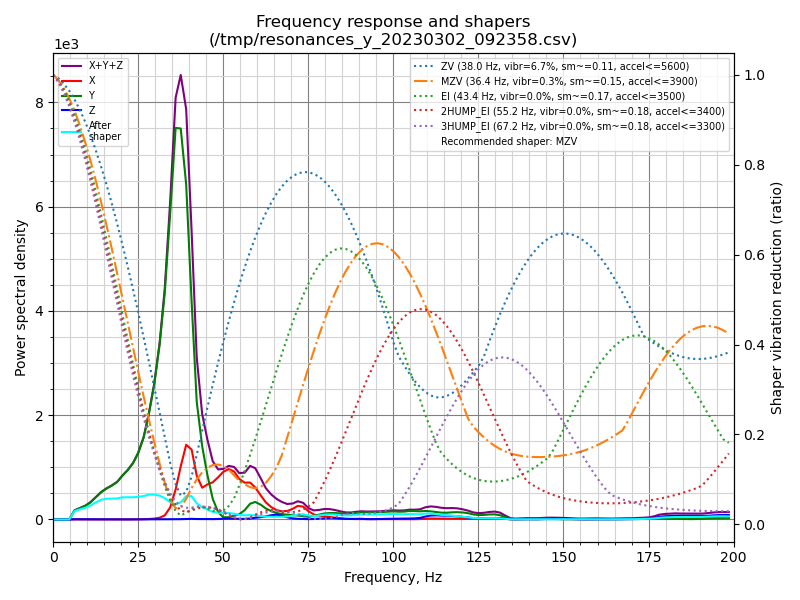
custom/voronica/input-shaper/shaper_calibrate_y__20230302_0923586.png
