cee-wals/Voron-2/custom/voronica/elis_generic_bigtreetech-manta-m8p-voron2.cfg

# This file contains common pin mappings for the BIGTREETECH Manta M8P
# To use this config, the firmware should be compiled for the
# STM32G0B1 with a "8KiB bootloader" and USB communication.

# See docs/Config_Reference.md for a description of parameters.


# -------------------------------------------
# voronica configuration notes
# -------------------------------------------
# 
# stepper drivers: tmc2226 (klipper equiv. tmc2209)
# 
# X/Y rotational distance:
#   - Setting to '40' only moved 1/2 the distance expected
#     - moving (x, y) from (350, 350) to (175,175) but the toolhead half the distance between XY Home and the bed center
#     - Moving to center would be (0,0)
#   - Setting to '20' seemed to fix this 1/2 distance movement
#     - moving (x, y) from (350, 350) to (175,175) put the toolhead in the middle of the bed
#   - SOLUTION: Setting the `full_steps_per_rotation: 400` fixed it
#   - Specs and Variables:
#     - Core XY
#     - 0.9 deg pitch Stepper
#     - full_steps_per_rotation: 400
#     - Belt pitch: 2mm
#     - pully(s): (2 x 20 toothed pully) * 2 mm belt tooth pitch -> 40 mm per rotation
#       - 2 x 20 toothed pulley => 20:1 ratio (b/c the pulleys are the same size)
#     - microsteps: 32
#     - steps_per_mm: 2560  --> ((400 step/rot.) * 256 um steps/step) / (40 mm/rot) => (102400 steps/rot) / (40 mm/rot) => 102400/40 steps/mm
#     - rotation_distance: 40 --> (102400 steps/rot) / (2560 steps/mm) => (102400/2560 rot/mm)
# Z-axis rotational distance:
#  - 1.8 deg pitch stepper
#  - Full_steps_per_rotation: 200
#  - Belt pitch: 2mm
#  - Pulley gear ratio (R = N2/N1, where N1 is the input gear): 16:1, 80:16, 20:80
#    - Reduction: 16:1, 5:1, 1:4
#    - computation (includes belt pitch): (2 * 16 * 5 * .25) = 40
#  - microsteps: 32
#  - steps_per_mm: 1280  --> ((200 step/rot.) * 256 um steps/step) / (40 mm/rot) => (51200 steps/rot) / (40 mm/rot) => 51200/40 steps/mm
#  - rotation_distance: 40 --> (51200 steps/rot) / (1280 steps/mm) => (51200/1280 rot/mm)
#
# TODO: See TODOs in this config
# TODO: Add bed_mesh section
# 
# -------------------------------------------
# END voronica notes
# -------------------------------------------
[mcu]
##	[X in MOTOR0] - B Motor
##	[Y in MOTOR1] - A Motor
##	[E in MOTOR6] - Extruder
##	Obtain definition by "ls -l /dev/serial/by-id/" then unplug to verify
##--------------------------------------------------------------------
serial: /dev/serial/by-id/usb-Klipper_stm32g0b1xx_3500330011504B4633373520-if00
#restart_method: command
##--------------------------------------------------------------------

[printer]
kinematics: corexy
max_velocity: 300  
max_accel: 3000    			#Max 4000
max_z_velocity: 15 			#Max 15 for 12V TMC Drivers, can increase for 24V
max_z_accel: 350
square_corner_velocity: 5.0

[temperature_sensor MCU]
sensor_type: temperature_mcu

[temperature_sensor SoC]
sensor_type: temperature_host

#####################################################################
# 	X/Y Stepper Settings
#####################################################################

## X Stepper on Motor1(B Motor)
[stepper_x]
step_pin: PE2
dir_pin: PB4
enable_pin: !PC11
microsteps: 32
rotation_distance: 40
full_steps_per_rotation: 400
endstop_pin: ^PF3
position_min: 0
# for 350mm build (TODO: Verify position w.r.t. mods)
position_endstop: 350
position_max: 350
#-----------------------------
homing_speed: 25   #Max 100
homing_retract_dist: 5
homing_positive_dir: true

##	Y Stepper driver (actual. TMC2226 UART Mode)
[tmc2209 stepper_x]
uart_pin: PC10
interpolate: False
run_current: 0.8
sense_resistor: 0.110
stealthchop_threshold: 0

## Y Stepper on Motor2 (A Motor)
[stepper_y]
step_pin: PF12
dir_pin: PF11
enable_pin: !PB3
microsteps: 32
rotation_distance: 40
full_steps_per_rotation: 400
endstop_pin: ^PF4
position_min: -5
# for 350mm build (TODO: Verify a w.r.t. mods)
position_endstop: 350
position_max: 350
#-----------------------------
homing_speed: 25  #Max 100
homing_retract_dist: 5
homing_positive_dir: true

##	Y Stepper driver (actual. TMC2226 UART Mode)
[tmc2209 stepper_y]
uart_pin: PF13
interpolate: False
run_current: 0.8
sense_resistor: 0.110
stealthchop_threshold: 0

#####################################################################
# 	Z Stepper Settings
#####################################################################

## Z0 Stepper - Front Left on MOTOR4
[stepper_z]
step_pin: PD3
dir_pin: PD2
enable_pin: !PD5
rotation_distance: 40
gear_ratio: 80:16
microsteps: 32
# TODO: Configure endstop_pin for Voron Tap
#endstop_pin: ^PF5
##  Z-position of nozzle (in mm) to z-endstop trigger point relative to print surface (Z0)
##  (+) value = endstop above Z0, (-) value = endstop below
##	Increasing position_endstop brings nozzle closer to the bed
##  After you run Z_ENDSTOP_CALIBRATE, position_endstop will be stored at the very end of your config
#position_endstop: -0.5
endstop_pin: probe:z_virtual_endstop
#-----------------------------

# for 350mm build (TODO: Verify position w.r.t. mods)
position_max: 340
#-----------------------------
position_min: -5
homing_speed: 8
second_homing_speed: 3
homing_retract_dist: 3

##	Make sure to update below for your relevant driver (2208 or 2209)
[tmc2209 stepper_z]
uart_pin: PD4
interpolate: False
run_current: 0.8
sense_resistor: 0.110
stealthchop_threshold: 99999999

##	Z1 Stepper - Rear Left on Motor5
[stepper_z1]
step_pin: PC9
dir_pin: !PC8
enable_pin: !PD1
rotation_distance: 40
gear_ratio: 80:16
microsteps: 32

##	Make sure to update below for your relevant driver (2208 or 2209)
[tmc2209 stepper_z1]
uart_pin: PD0
interpolate: False
run_current: 0.8
sense_resistor: 0.110
stealthchop_threshold: 99999999

##	Z2 Stepper - Rear Right on Motor6
[stepper_z2]
step_pin: PA10
dir_pin: PD15
enable_pin: !PA15
rotation_distance: 40
gear_ratio: 80:16
microsteps: 16

##	Make sure to update below for your relevant driver (2208 or 2209)
[tmc2209 stepper_z2]
uart_pin: PF8
interpolate: False
run_current: 0.8
sense_resistor: 0.110
stealthchop_threshold: 99999999

##	Z3 Stepper - Front Right on Motor7
[stepper_z3]
step_pin: PD12
dir_pin: !PD11
enable_pin: !PD14
rotation_distance: 40
gear_ratio: 80:16
microsteps: 32

##	Make sure to update below for your relevant driver (2208 or 2209)
[tmc2209 stepper_z3]
uart_pin: PD13
interpolate: False
run_current: 0.8
sense_resistor: 0.110
stealthchop_threshold: 99999999

#####################################################################
# 	Extruder
#####################################################################

##  E0 on Motor3A
##  Toolhead: 
##    - StealthBurner CW2
##    - Phateus Rapido UHF hotend w/ PT1000 hotend
##    - NEMA14 36mm pancake motor: LDO-36STH20-1004AHG(XH)
[extruder]
step_pin: PD7
dir_pin: PD6
enable_pin: !PF10
##	Update value below when you perform extruder calibration
##	If you ask for 100mm of filament, but in reality it is 98mm:
##	rotation_distance = <previous_rotation_distance> * <actual_extrude_distance> / 100
##  22.6789511 is a good starting point
rotation_distance: 22.21346563	#Bondtech 5mm Drive Gears
##	Update Gear Ratio depending on your Extruder Type
##	Use 50:17 for Afterburner/Clockwork (BMG Gear Ratio)
##	Use 80:20 for M4, M3.1
gear_ratio: 50:10        # Old motor = 50:17				#BMG Gear Ratio
microsteps: 32
full_steps_per_rotation: 200
nozzle_diameter: 0.400
filament_diameter: 1.75
heater_pin: PE3
control: pid
pid_Kp: 20.359
pid_Ki: 1.635
pid_Kd: 63.366
# TODO: Get the actual pull-up resistor's reading
pullup_resistor: 2200
sensor_type: PT1000
sensor_pin: PA1
min_temp: 10
max_temp: 290           # TODO: Increase to 300C but with caution. 270C is too conservative. Is 290 too high?
max_power: 1.0
min_extrude_temp: 170
##	Try to keep pressure_advance below 1.0
pressure_advance: 0.05
##	Default is 0.040, leave stock
pressure_advance_smooth_time: 0.040

##	E0 on Motor3A
##	Make sure to update below for your relevant driver (2208 or 2209)
[tmc2209 extruder]
uart_pin: PF9
interpolate: false
run_current: 0.7
sense_resistor: 0.110
stealthchop_threshold: 0

[filament_motion_sensor SFS_T0]
detection_length: 10.00 # This can be adjusted to your desired level of sensitivity. 10 is a recomended value to prevent flow dropoff false triggers.
extruder: extruder
switch_pin: PC5
pause_on_runout: True # This can be set to false to debug false positives putting the sensor in "monitor mode". The printer will not pause but it will run the runout_gcode below. 
event_delay: 3.0
pause_delay: 0.5
runout_gcode:
    #LCDRGB R=1 G=0 B=0  ; Turn LCD red
    M117 Runout Detected!
    PAUSE                ; Pause
    BEEP I=12           ; Beep 12 times
#####################################################################
# 	Bed Heater
#####################################################################

[heater_bed]
##	SSR Pin - BED_OUT
heater_pin: PB5
# "NTC 100K MGB18-104F39050L32" (Keenovo Heater Pad)
sensor_type: NTC 100K MGB18-104F39050L32
sensor_pin: PA0
##	Adjust Max Power so your heater doesn't warp your bed
max_power: 0.9
min_temp: 0
max_temp: 120
control: pid
pid_Kp: 48.140
pid_Ki: 1.207
pid_Kd: 480.198

#####################################################################
# 	Probe
#####################################################################

[probe]
##	Voron-Tap
##  See https://github.com/VoronDesign/Voron-Tap/blob/main/config/tap_klipper_instructions.md
##	The nozzle is the Probe!
# TODO: Manually calibrate the probe's Z offset by using PROBE_CALIBRATE
pin: PF5
x_offset: 0
y_offset: 0
#z_offset: 0
#z_offset: -0.498          # Attempt 1
#z_offset: -0.485          # Attempt 2 (tested w/ printer paper: 0.1mm)
#z_offset: -0.464          # Attempt 3 (voron-tap accuracy Macro @ 50C bed & 100 samples)
speed: 10.0
samples: 3
samples_result: median
sample_retract_dist: 3.0
samples_tolerance: 0.006
samples_tolerance_retries: 3
## Tap's activate_gcode:
##   This G-code will allow you to probe cold, but will also prevent you from probing 
##   with a nozzle at printing temperature (to try to preserve your build surface). 
activate_gcode:
    {% set PROBE_TEMP = 150 %}
    {% set MAX_TEMP = PROBE_TEMP + 5 %}
    {% set ACTUAL_TEMP = printer.extruder.temperature %}
    {% set TARGET_TEMP = printer.extruder.target %}

    {% if TARGET_TEMP > PROBE_TEMP %}
        { action_respond_info('Extruder temperature target of %.1fC is too high, lowering to %.1fC' % (TARGET_TEMP, PROBE_TEMP)) }
        M109 S{ PROBE_TEMP }
    {% else %}
        # Temperature target is already low enough, but nozzle may still be too hot.
        {% if ACTUAL_TEMP > MAX_TEMP %}
            { action_respond_info('Extruder temperature %.1fC is still too high, waiting until below %.1fC' % (ACTUAL_TEMP, MAX_TEMP)) }
            TEMPERATURE_WAIT SENSOR=extruder MAXIMUM={ MAX_TEMP }
        {% endif %}
    {% endif %}
    

#####################################################################
# 	Fan Control
#####################################################################

[fan]
##	Print Cooling Fan - CNC_FAN0
pin: PE6
kick_start_time: 0.5
##	Depending on your fan, you may need to increase this value
##	if your fan will not start. Can change cycle_time (increase)
##	if your fan is not able to slow down effectively
off_below: 0.10

[heater_fan hotend_fan]
##	Hotend Fan - CNC_FAN1
pin: PE0
max_power: 1.0
kick_start_time: 0.5
heater: extruder
heater_temp: 50.0
##	If you are experiencing back flow, you can reduce fan_speed
#fan_speed: 1.0

[heater_fan controller_fan]
##	Controller fan - CNC_FAN2
pin: PC12
max_power: 1.0
fan_speed: 0.3
shutdown_speed: 1.0
kick_start_time: 0.5
heater: heater_bed
heater_temp: 45.0

# TODO: Configure the exhaust fan and evermore fan
# TODO: Exhaust fan still needs to connected
#[heater_fan exhaust_fan]
##	Exhaust fan - CNC_FAN3
#pin: PE5
#max_power: 1.0
#shutdown_speed: 0.0
#kick_start_time: 5.0
#heater: heater_bed
#heater_temp: 60
#fan_speed: 1.0

# TODO: Configure. Connected to fan4 
#[heater_fan evermore_filter_fan4]
## Evermore Filter Micro fan
#pin: PE4
#tachometer_pin: PC13


#####################################################################
# 	LED Control
#####################################################################

# TODO: Install LED bars and configure LEDs. These will be neopixel types
#[output_pin caselight]
# Chamber Lighting - HE1 Connector (Optional)
#pin: PB5
#pwm:true
#shutdown_value: 0
#value:1
#cycle_time: 0.01

[neopixel toolhead_leds]
pin: PC6
chain_count: 3
#   The number of Neopixel chips that are "daisy chained" to the
#   provided pin. The default is 1 (which indicates only a single
#   Neopixel is connected to the pin).
color_order: GRBW
#   Set the pixel order required by the LED hardware (using a string
#   containing the letters R, G, B, W with W optional). Alternatively,
#   this may be a comma separated list of pixel orders - one for each
#   LED in the chain. The default is GRB.
initial_RED: 1.0
initial_GREEN: 0.0
initial_BLUE: 0.0
initial_WHITE: 0.0
#   See the "led" section for information on these parameters.

# Custom LED config
# TODO: Figure out how to make this work
#NEOPIXEL_DISPLAY LED="toolhead_leds" TYPE=print_speed MODE=progress
#####################################################################
# 	Homing and Gantry Adjustment Routines
#####################################################################

[idle_timeout]
timeout: 1800

[safe_z_home]
##	XY Location of the Z Endstop Switch
##	Voron-Tap, set to center of the bed.
home_xy_position:175,175
speed:100
z_hop:10

# TODO: Do we need this
#[homing_override]
#axes: xy
#set_position_x: 
#set_position_y: 
#set_position_z: 

[quad_gantry_level]
##	Use QUAD_GANTRY_LEVEL to level a gantry.
##	Min & Max gantry corners - measure from nozzle at MIN (0,0) and 
##	MAX (250, 250), (300,300), or (350,350) depending on your printer size
##	to respective belt positions

#-----------------------------
##	Gantry Corners for 350mm Build
# TODO: Check gantry corners
# TODO: Update proble points for voron-tap
gantry_corners:
	-60,-10
	410,420
#	Probe points
points:
	50,25
	50,275
	300,275
	300,25

#-----------------------------
speed: 100
horizontal_move_z: 10
retries: 5
retry_tolerance: 0.0075
max_adjust: 10

# TODO: Better calibrate
[bed_mesh]
mesh_min: 25,10
mesh_max: 335,335
probe_count: 6,6
relative_reference_index: 24
algorithm: bicubic

########################################
# MCU pin headers for external displays
########################################

[board_pins]
aliases:
    # EXP1 header
    EXP1_1=PE9, EXP1_2=PE10,
    EXP1_3=PE11, EXP1_4=PE12,
    EXP1_5=PE13, EXP1_6=PE14,    # Slot in the socket on this side
    EXP1_7=PE15, EXP1_8=PB10,
    EXP1_9=<GND>, EXP1_10=<5V>,

    # EXP2 header
    EXP2_1=PB14, EXP2_2=PB13,
    EXP2_3=PF7, EXP2_4=PB12,
    EXP2_5=PE7, EXP2_6=PB11,      # Slot in the socket on this side
    EXP2_7=PE8, EXP2_8=<RST>,
    EXP2_9=<GND>, EXP2_10=PC5

# See the sample-lcd.cfg file for definitions of common LCD displays.

#####################################################################
# 	Displays
#####################################################################
[display]
#	mini12864 LCD Display
lcd_type: uc1701
cs_pin: EXP1_3
a0_pin: EXP1_4
rst_pin: EXP1_5
encoder_pins: ^EXP2_5, ^EXP2_3
click_pin: ^!EXP1_2
contrast: 63
spi_software_miso_pin: EXP2_1
spi_software_mosi_pin: EXP2_6
spi_software_sclk_pin: EXP2_2

[neopixel btt_mini12864]
#	To control Neopixel RGB in mini12864 display
pin: EXP1_6
chain_count: 3
initial_RED: 0.1
initial_GREEN: 0.5
initial_BLUE: 0.0
color_order: RGB

##	Set RGB values on boot up for each Neopixel. 
##	Index 1 = display, Index 2 and 3 = Knob
[delayed_gcode setdisplayneopixel]
initial_duration: 1
gcode:
       SET_LED LED=btt_mini12864 RED=1 GREEN=1 BLUE=1 INDEX=1 TRANSMIT=0
       SET_LED LED=btt_mini12864 RED=1 GREEN=0 BLUE=0 INDEX=2 TRANSMIT=0
       SET_LED LED=btt_mini12864 RED=1 GREEN=0 BLUE=0 INDEX=3 

[delayed_gcode DISABLEFILAMENTSENSOR] # This will disable the SFS 1 second after klipper starts
initial_duration: 1
gcode:
    SET_FILAMENT_SENSOR SENSOR=SFS_T0 ENABLE=0 ; Put your filament sensor's name after SENSOR=

[output_pin beeper]
pin: EXP1_1
value: 0
shutdown_value: 0
pwm: True
cycle_time: 0.0005 ; Default beeper tone in kHz. 1 / 0.0005 = 2000Hz (2kHz)
#--------------------------------------------------------------------


#####################################################################
# 	Macros
#####################################################################

[gcode_macro G32]
gcode:
    BED_MESH_CLEAR
    G28
    QUAD_GANTRY_LEVEL
    G28
    # for 350mm build
    G0 X175 Y175 Z30 F3600
    #--------------------------------------------------------------------

[gcode_macro SFS_ENABLE] ; Add this to PRINT_START
description: Enable smart filament sensor
gcode:
    M117 ENABLING the SFS
    G92 E0
    SET_FILAMENT_SENSOR SENSOR=SFS_T0 ENABLE=1 ; Put your filament sensor's name after SENSOR=

[gcode_macro SFS_DISABLE] ; Add this to PRINT_END and PRINT_CANCEL
description: Disable smart filament sensor 
gcode:
    M117 DISABLING the SFS
    G92 E0
    SET_FILAMENT_SENSOR SENSOR=SFS_T0 ENABLE=0 ; Put your filament sensor's name after SENSOR=

[gcode_macro PRINT_START]
#   Use PRINT_START for the slicer starting script - please customise for your slicer of choice
gcode:
    G32                            ; home all axes
    G1 Z20 F3000                   ; move nozzle away from bed
    SFS_ENABLE
    BED_MESH_CALIBRATE
    ADAPTIVE_PURGE
[gcode_macro PRINT_END]
#   Use PRINT_END for the slicer ending script - please customise for your slicer of choice
gcode:
    M400                           ; wait for buffer to clear
    G92 E0                         ; zero the extruder
    G1 E-10.0 F3600                ; retract filament
    G91                            ; relative positioning
    G0 Z1.00 X20.0 Y20.0 F20000    ; move nozzle to remove stringing
    TURN_OFF_HEATERS
    M107                           ; turn off fan
    G1 Z2 F3000                    ; move nozzle up 2mm
    G90                            ; absolute positioning
    G0  X125 Y250 F3600            ; park nozzle at rear
    BED_MESH_CLEAR
    SFS_DISABLE

[gcode_macro BEEP]
gcode:
    # Parameters
    {% set i = params.I|default(1)|int %}           ; Iterations (number of times to beep).
    {% set dur = params.DUR|default(100)|int %}     ; Duration/wait of each beep in ms. Default 100ms.
    {% set freq = params.FREQ|default(2000)|int %}  ; Frequency in Hz. Default 2kHz.

    {% for iteration in range(i|int) %}
        SET_PIN PIN=beeper VALUE=0.8 CYCLE_TIME={ 1.0/freq if freq > 0 else 1 }
        G4 P{dur}
        SET_PIN PIN=beeper VALUE=0
        G4 P{dur}
    {% endfor %}

[gcode_macro DUMP_PARAMETERS]
gcode:
   {% for name1 in printer %}
      {% for name2 in printer[name1] %}
         { action_respond_info("printer['%s'].%s = %s" % (name1, name2, printer[name1][name2])) }
      {% else %}
         { action_respond_info("printer['%s'] = %s" % (name1, printer[name1])) }
      {% endfor %}
   {% endfor %}

# Park front center
[gcode_macro PARKFRONT]
gcode:
    CG28                              ; home if not already homed
    SAVE_GCODE_STATE NAME=PARKFRONT
    G90                               ; absolute positioning
    G0 X{printer.toolhead.axis_maximum.x/2} Y{printer.toolhead.axis_minimum.y+5} Z{printer.toolhead.axis_maximum.z/2} F6000        
    RESTORE_GCODE_STATE NAME=PARKFRONT

# Park front center, but low down.
[gcode_macro PARKFRONTLOW]
gcode:
    CG28                             ; home if not already homed
    SAVE_GCODE_STATE NAME=PARKFRONT
    G90                              ; absolute positioning
    G0 X{printer.toolhead.axis_maximum.x/2} Y{printer.toolhead.axis_minimum.y+5} Z20 F6000                                     
    RESTORE_GCODE_STATE NAME=PARKFRONT

# Park top rear left
[gcode_macro PARKREAR]
gcode:
    CG28                             ; home if not already homed
    SAVE_GCODE_STATE NAME=PARKREAR
    G90                              ; absolute positioning
    G0 X{printer.toolhead.axis_minimum.x+10} Y{printer.toolhead.axis_maximum.y-10} Z{printer.toolhead.axis_maximum.z-50} F6000     
    RESTORE_GCODE_STATE NAME=PARKREAR

# Park at center of build volume
[gcode_macro PARKCENTER]
gcode:
    CG28                              ; home if not already homed
    SAVE_GCODE_STATE NAME=PARKCENTER
    G90                               ; absolute positioning
    G0 X{printer.toolhead.axis_maximum.x/2} Y{printer.toolhead.axis_maximum.y/2} Z{printer.toolhead.axis_maximum.z/2} F6000    
    RESTORE_GCODE_STATE NAME=PARKCENTER

# Park 15mm above center of bed
[gcode_macro PARKBED]
gcode:
    CG28                               ; home if not already homed
    SAVE_GCODE_STATE NAME=PARKBED
    G90                                ; absolute positioning
    G0 X{printer.toolhead.axis_maximum.x/2} Y{printer.toolhead.axis_maximum.y/2} Z15 F6000                                     
    RESTORE_GCODE_STATE NAME=PARKBED

[gcode_macro CANCEL_PRINT]
rename_existing: BASE_CANCEL_PRINT
gcode:
    SET_IDLE_TIMEOUT TIMEOUT={printer.configfile.settings.idle_timeout.timeout} ; set timeout back to configured value
    CLEAR_PAUSE
    SDCARD_RESET_FILE
    PRINT_END
    BASE_CANCEL_PRINT

[gcode_macro RESUME]
rename_existing: BASE_RESUME
variable_zhop: 0
variable_etemp: 0
gcode:
    # Parameters
    {% set e = params.E|default(2.5)|int %}
    
    {% if printer['pause_resume'].is_paused|int == 1 %}
        SET_FILAMENT_SENSOR SENSOR=SFS_T0 ENABLE=1                          ; enable filament sensor
        #RESETRGB                                                                    ; reset LCD color
        SET_IDLE_TIMEOUT TIMEOUT={printer.configfile.settings.idle_timeout.timeout}  ; set timeout back to configured value
        {% if etemp > 0 %}
            M109 S{etemp|int}                                                        ; wait for hotend to heat back up
        {% endif %}
        RESTORE_GCODE_STATE NAME=PAUSEPARK MOVE=1 MOVE_SPEED=100                     ; go back to parked position in case toolhead was moved during pause (otherwise the return zhop can error)  
        G91                                                                          ; relative positioning
        M83                                                                          ; relative extruder positioning
        {% if printer[printer.toolhead.extruder].temperature >= printer.configfile.settings.extruder.min_extrude_temp %}                                                
            G1 Z{zhop * -1} E{e} F900                                                ; prime nozzle by E, lower Z back down
        {% else %}                      
            G1 Z{zhop * -1} F900                                                     ; lower Z back down without priming (just in case we are testing the macro with cold hotend)
        {% endif %}                             
        RESTORE_GCODE_STATE NAME=PAUSE MOVE=1 MOVE_SPEED=60                          ; restore position
        BASE_RESUME                                                                  ; resume print
    {% endif %}

[gcode_macro PAUSE]
rename_existing: BASE_PAUSE
gcode:
    # Parameters
    {% set z = params.Z|default(10)|int %}                                                   ; z hop amount
    
    {% if printer['pause_resume'].is_paused|int == 0 %}     
        SET_GCODE_VARIABLE MACRO=RESUME VARIABLE=zhop VALUE={z}                              ; set z hop variable for reference in resume macro
        SET_GCODE_VARIABLE MACRO=RESUME VARIABLE=etemp VALUE={printer['extruder'].target}    ; set hotend temp variable for reference in resume macro
                                
        SET_FILAMENT_SENSOR SENSOR=SFS_T0 ENABLE=0                                  ; disable filament sensor       
        SAVE_GCODE_STATE NAME=PAUSE                                                          ; save current print position for resume                
        BASE_PAUSE                                                                           ; pause print
        {% if (printer.gcode_move.position.z + z) < printer.toolhead.axis_maximum.z %}       ; check that zhop doesn't exceed z max
            G91                                                                              ; relative positioning
            G1 Z{z} F900                                                                     ; raise Z up by z hop amount
        {% else %}
            { action_respond_info("Pause zhop exceeds maximum Z height.") }                  ; if z max is exceeded, show message and set zhop value for resume to 0
            SET_GCODE_VARIABLE MACRO=RESUME VARIABLE=zhop VALUE=0
        {% endif %}
        G90                                                                                  ; absolute positioning
        G1 X{printer.toolhead.axis_maximum.x/2} Y{printer.toolhead.axis_minimum.y+5} F6000   ; park toolhead at front center
        SAVE_GCODE_STATE NAME=PAUSEPARK                                                      ; save parked position in case toolhead is moved during the pause (otherwise the return zhop can error) 
        M104 S0                                                                              ; turn off hotend
        SET_IDLE_TIMEOUT TIMEOUT=43200                                                       ; set timeout to 12 hours
    {% endif %}

# Filament change
[gcode_macro M600]
gcode:
    #LCDRGB R=0 G=1 B=0  ; Turn LCD green
    PAUSE                ; Pause
