cee-wals/Voron-2/(commit log)

2022-10-24 Adding the BOM for our printer build: Voron 2.4 (350 mm^3)
    [voron2.4_350mm_bom.csv, voron2.4_350mm_bom.xlsx]
2022-11-11 Updated BOM and adding slicer configs
    [panel_mounting_doors.3mf, panel_mounting_set1.3mf, panel_mounting_set2.3mf, voron2.4_350mm_bom.xlsx]
2022-12-01 Add files via upload
    Added jig.stl file.
    [jig.stl]
2022-12-01 adding voron 2.4 frame jig
    [jig.3mf, jig.stl]
2022-12-07 Adding project files for 3D printed parts and updated our BOM
    [[a]_skirts_belt_guard_a_b.3mf, [a]_skirts_electronics_panel_parts.3mf, [a]_skirts_fan_grill_a_b.3mf, [a]_skirts_fan_grill_open_optional.3mf, [a]_skirts_fan_grill_retainer.3mf, [a]_z_drive_baseplate_a_x2.3mf, [a]_z_drive_baseplate_b_x2.3mf, [a]_z_drive_belt_tensioner_a_x2.3mf]
2022-12-08 Updated BOM status for latest purchases
    [voron2.4_350mm_bom.xlsx]
2022-12-11 Adding folder for custom mods and scripts directory
    [voron_part_checklist_data.csv]
2022-12-12 project file updates
    [AB-drive-a_drive_frame_lower.3mf, AB-drive-a_drive_frame_upper.3mf, AB-drive-b_drive_frame_lower.3mf, AB-drive-b_drive_frame_upper.3mf, AB-drive-unit-set.3mf, [a]_AB-drive-cable_cover.3mf, [a]_AB-drive-z_chain_retainer_bracket_x2.3mf, [a]_front-idlers-tensioners_left.3mf]
2022-12-12 Sliced files marked in-progress
    [[a]_endstop_pod_hall_effect.3mf, [a]_xy_joint_cable_bridge_2hole.3mf]
2022-12-12 Updates to 3MF project files, renames some of the mods archives, and added the Manta M8P mounting bracket mod.
    [AB-drive-a_drive_frame_lower.3mf, AB-drive-a_drive_frame_upper.3mf, AB-drive-b_drive_frame_lower.3mf, AB-drive-b_drive_frame_upper.3mf, AB-drive-unit-set.3mf, Manta-M8P_Bracket.step, Manta-M8P_Bracket.stl, [a]_AB-drive-z_chain_retainer_bracket_x2.3mf]
2022-12-12 Adding 5 files to in-progress
    [[a]_endstop_pod_D2F_switch.3mf, [a]_xy_joint_cable_bridge_3hole.3mf, xy_joint_left_lower_MGN12.3mf, xy_joint_left_upper_MGN12.3mf, xy_joint_right_lower_MGN12.3mf, xy_joint_right_upper_MGN12.3mf]
2022-12-13 Added Mini Case Hinge to reprint
    [[a]_mini12864_case_hinge.3mf]
2022-12-13 Added hotend and probe retainer to in-progress. Added case hinge to reprint and started the print. Results pending.
    [[a]_mini12864_case_hinge.3mf, hotend_fan_mount.3mf, probe_retainer_bracket_9mm.3mf]
2022-12-21 Fixed conflicts
    [AB-drive-b_drive_frame_lower.3mf, Belt_Tension_Meter.3mf, Belt_Tension_Meter_90mm.3mf, Belt_Tension_Meter_base.3mf, Belt_Tension_Meter_stick_and_finger.3mf, [a]_skirts-mini12864_case_hinge.3mf, [a]_skirts_belt_guard_a_b.3mf, gantry-installation-hook.3mf]
2022-12-27 Lots o' updates
    [Alignmenttool_MGN12.stl, Bed_Support_Alignment_Tool_250_Corners_x4.stl, Bed_Support_Alignment_Tool_300_Corners_x4.stl, Bed_Support_Alignment_Tool_350_Corners_x4.stl, Bed_Support_Alignment_Tool_Center_250_300_350_x2.stl, Dial_indicator_AB_beta.stl, Linear_Rail_2020_Alignment_Tool.stl, Linear_Rail_3030_Alignment_Tool.stl]
2023-01-05 BOM and project file updates
    [bottom_panel_clip_x4.3mf, bottom_panel_hinge_x2.3mf, bowden_retainer.3mf, corner_panel_clip_6mm_x8.3mf, door_hardware.3mf, exhaust_filter_housing.3mf, lrs_200_psu_bracket_x2.3mf, spool_holder.3mf]
2023-01-05 Added Z-endstop sexbolt mods. Needed for extended height due to MRW kinematic bed mounts and nevermore duo mounting
    [EndstopHousingBlank.stl, EndstopHousingPissedOff.stl, EndstopHousingSmile.stl, EndstopHousingVoronLogo.stl, SexboltBodyHexBacker.stl, SexboltBodyHexBrace.stl, TridentSexBolt.stl, V2_SexBolt_Z_Endstop.step]
2023-02-24 First successful print. Added the smart filament runout sensor and macros. Had to increase the E-motor current b/c the filament path has a lot of resistance.
    [2020 Internal Clip.stl, 2020_Profile_Cover.step, 2020_Profile_Cover.stl, 2020_Profile_Cover__x4.3mf, 2020_Stealth_Profile_Cover.step, 2020_Stealth_Profile_Cover.stl, 250mm_angle_frame_1_x2.stl, 250mm_angle_frame_2_x2.stl]
2026-08-27 Updating repo
    [2020_Profile_and_stealth_Cover.3mf, Back Plate.stl, EM_Cubes_x20.3mf, EM_Cubes_x9.3mf, Extrusion Mount - No Kinematics.stl, Filament_Card_Caddy_25.stl, Filament_Card_PLA.3mf, Front Cover.stl]
